adibatic/3dof-manipulator/cad/Ashoulder_joint.SLDASM

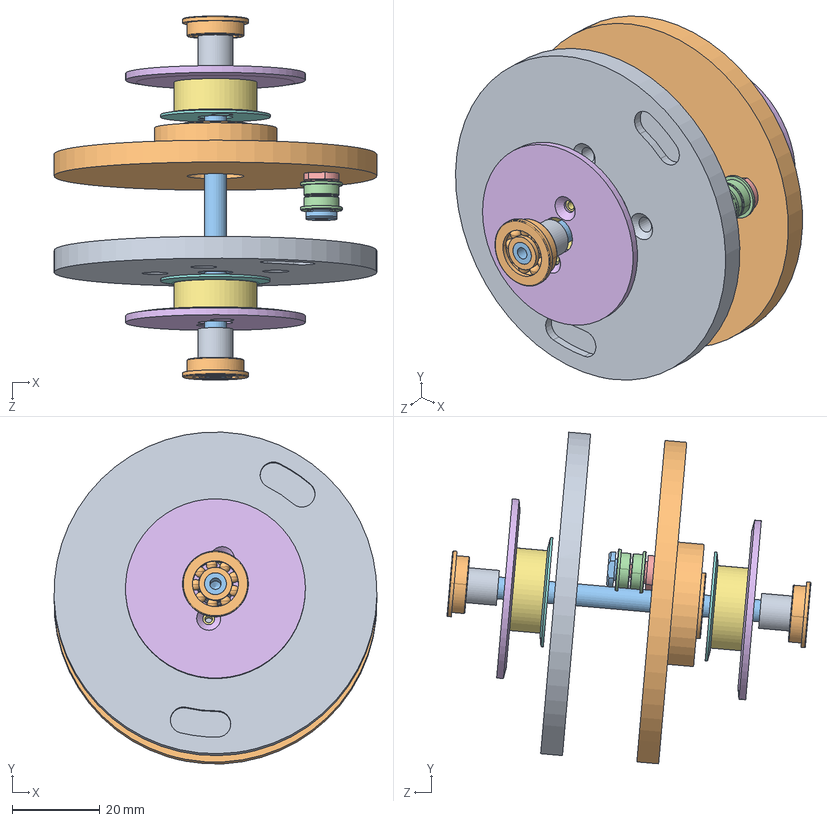
[picture p9: CAD file, 2026-10-08]
cad/Ashoulder_joint.SLDASM
73.6 x 75.6 x 83.0 mm
213shaft
704small_ball_bearings x 3
214sleeve x 2
212flange x 2
211toothed_pulley x 2
210spur_gear x 2
307link_attachment_shaft
705small_ball_bearings x 2
308nut
208spur_gear
207spur_gear
