adibatic/3dof-manipulator/cad/X-X.SLDASM

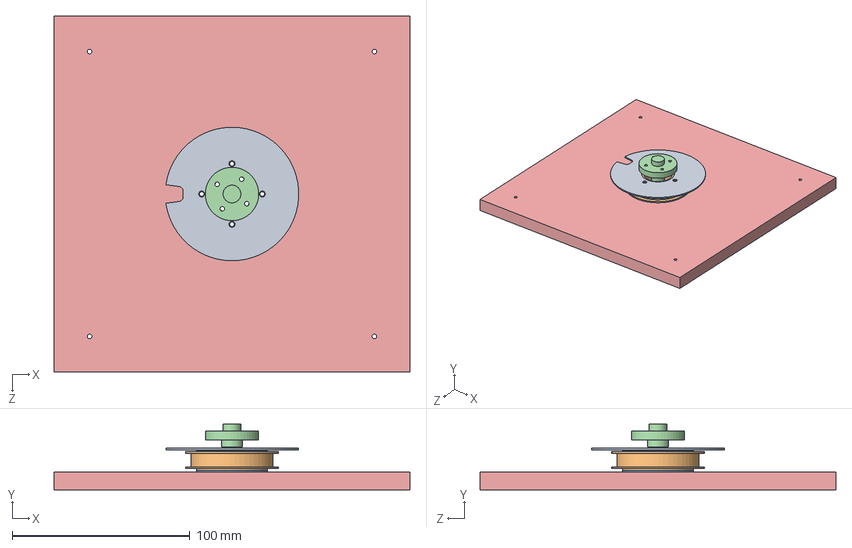
[picture p10: CAD file, 2026-10-08]
cad/X-X.SLDASM
200.0 x 37.0 x 200.0 mm
101base
102shaft
107spacer
103toothed_pulley
106proximity_sensor_target
