adibatic/3dof-manipulator/cad/assembly.SLDASM

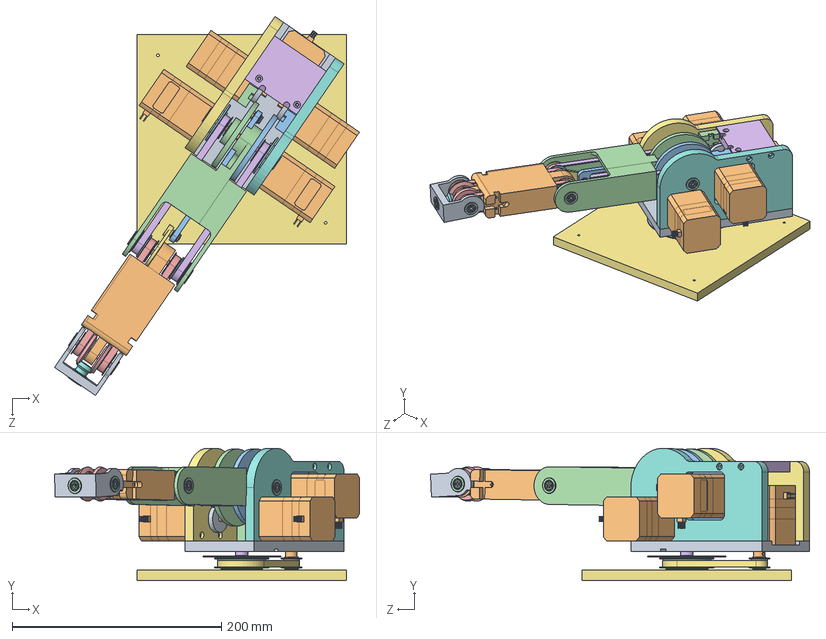
[picture p11: CAD file, 2026-10-08]
cad/assembly.SLDASM
291.2 x 126.5 x 361.9 mm
101base
102shaft
107spacer
103toothed_pulley
106proximity_sensor_target
104toothed_pulley
105waist_rotation_plate
201left_motor_plate
202right_motor_plate
203reinforcement_plate
213shaft
704small_ball_bearings x 9
214sleeve x 2
212flange x 8
211toothed_pulley x 4
210spur_gear x 2
307link_attachment_shaft x 2
705small_ball_bearings x 4
308nut x 2
208spur_gear
207spur_gear
302shaft
303toothed_pulley x 2
304flange x 2
305lever
402shaft
403bevel_gear x 2
301upper_arm
306link_bar
401forearm
501wrist
404bevel_gear
108belt
217belt x 2
309belt x 2
204motor_mounting_plate
205motor_mounting_plate
601pulse_motor x 5
206spur_gear x 4
