adibatic/3dof-manipulator/cad/Belbow_joint.SLDASM

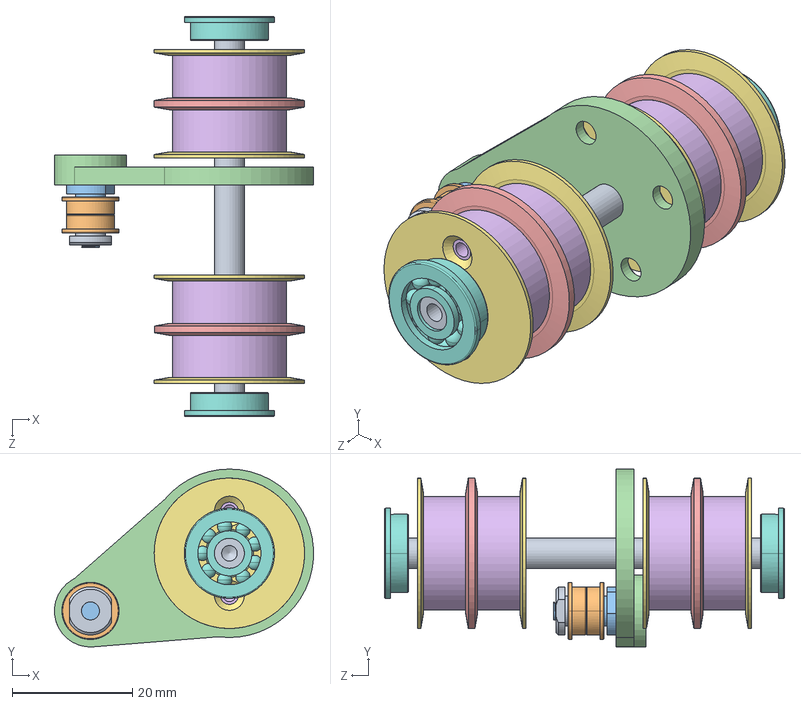
[picture p12: CAD file, 2026-10-08]
cad/Belbow_joint.SLDASM
43.0 x 29.6 x 66.5 mm
302shaft
704small_ball_bearings x 2
212flange x 4
303toothed_pulley x 2
304flange x 2
305lever
307link_attachment_shaft
705small_ball_bearings x 2
308nut
