adibatic/3dof-manipulator/cad/101base.SLDPRT

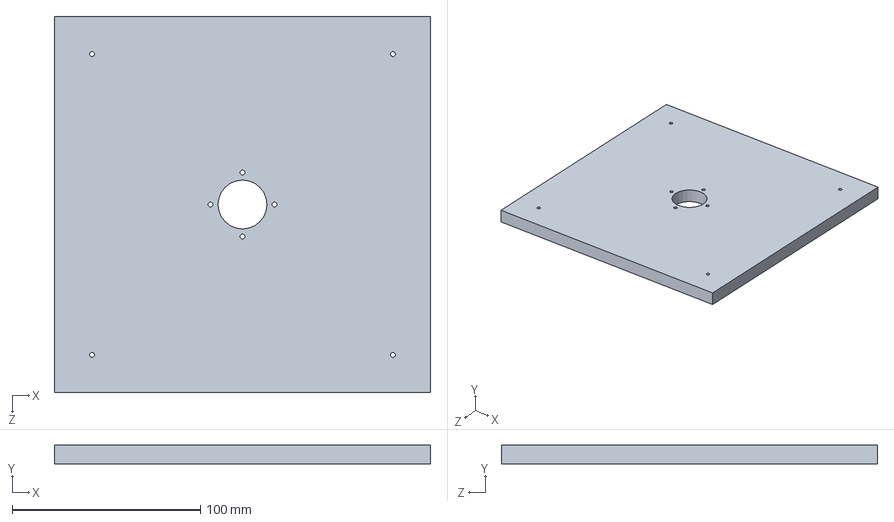
[picture p13: CAD file, 2026-10-08]
cad/101base.SLDPRT
200.0 x 10.0 x 200.0 mm
