adibatic/3dof-manipulator/cad/302shaft.SLDPRT

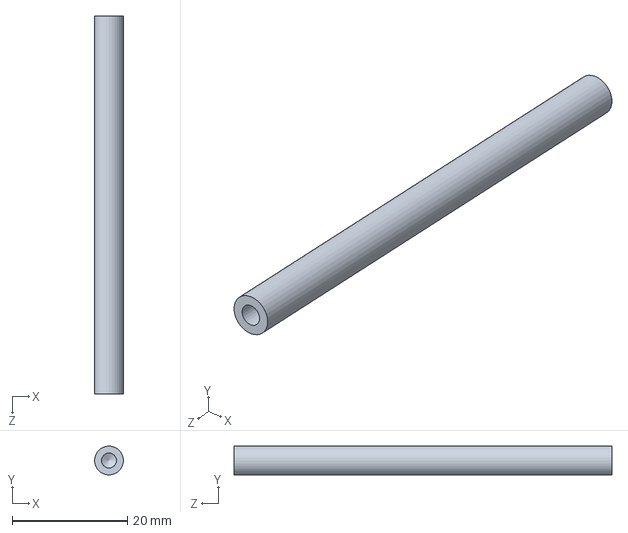
[picture p14: CAD file, 2026-10-08]
cad/302shaft.SLDPRT
5.00 x 5.00 x 65.5 mm
