adibatic/3dof-manipulator/cad/217belt.SLDPRT

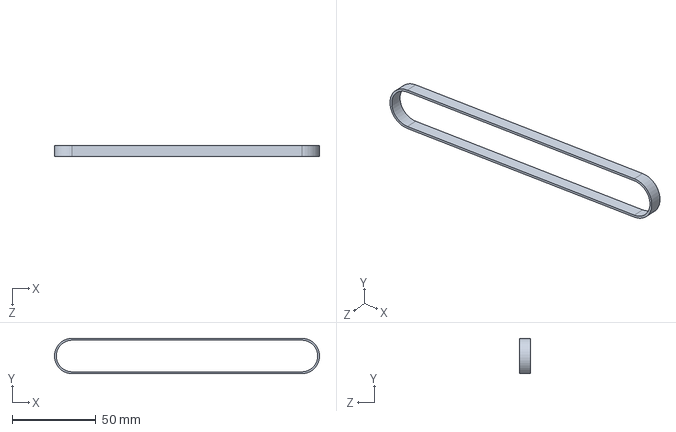
[picture p15: CAD file, 2026-10-08]
cad/217belt.SLDPRT
158.2 x 21.1 x 6.40 mm
