adibatic/3dof-manipulator/cad/208spur_gear.SLDPRT

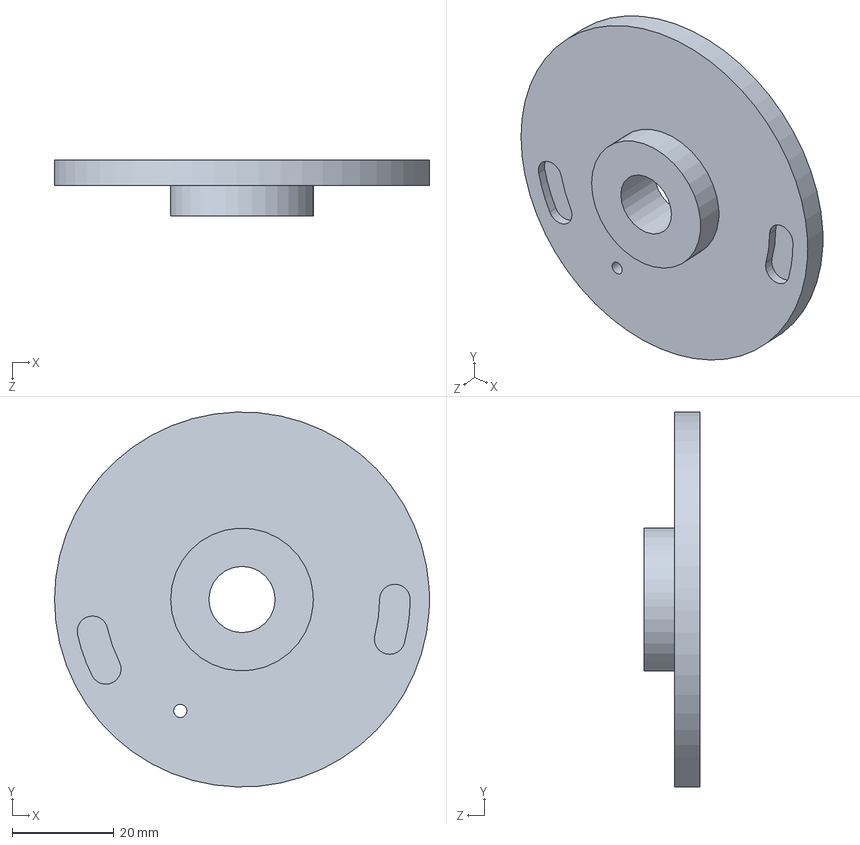
[picture p16: CAD file, 2026-10-08]
cad/208spur_gear.SLDPRT
73.6 x 73.6 x 11.0 mm
