adibatic/3dof-manipulator/cad/207spur_gear.SLDPRT

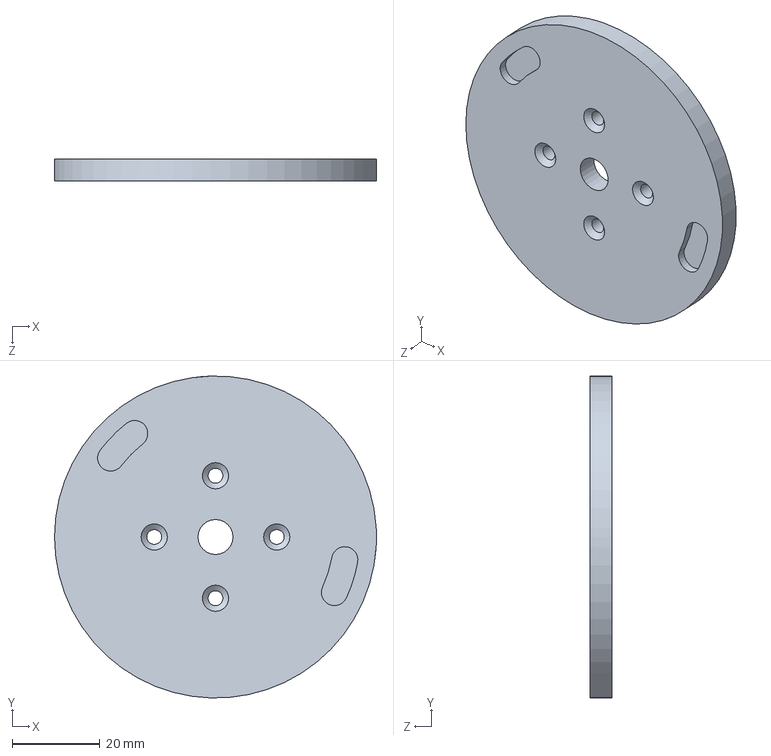
[picture p17: CAD file, 2026-10-08]
cad/207spur_gear.SLDPRT
73.6 x 73.6 x 5.00 mm
