adibatic/3dof-manipulator/cad/704small_ball_bearings.SLDPRT

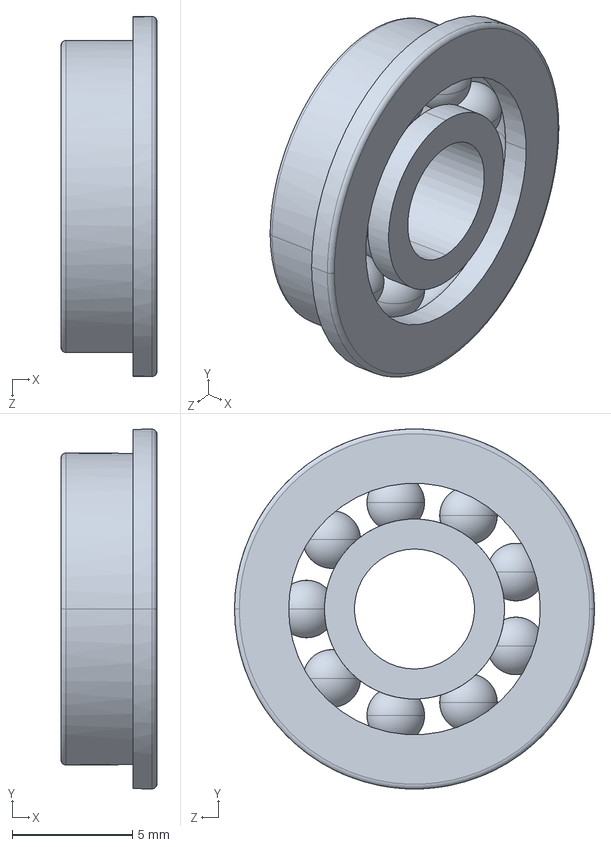
[picture p18: CAD file, 2026-10-08]
cad/704small_ball_bearings.SLDPRT
4.00 x 15.0 x 15.0 mm
