adibatic/3dof-manipulator/cad/308nut.SLDPRT

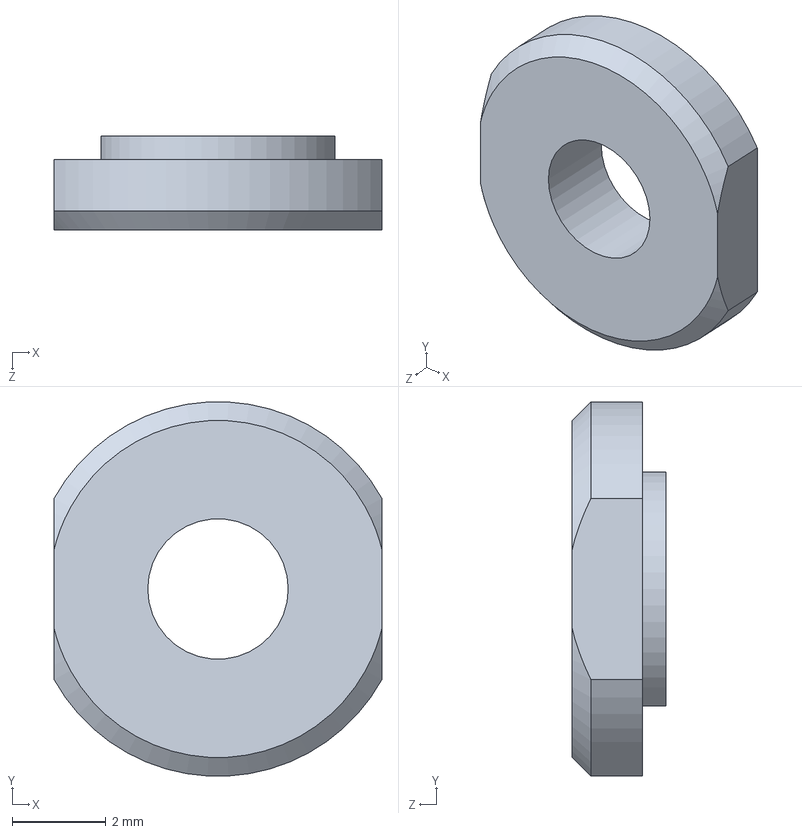
[picture p19: CAD file, 2026-10-08]
cad/308nut.SLDPRT
7.00 x 7.99 x 2.00 mm
