adibatic/3dof-manipulator/cad/303toothed_pulley.SLDPRT

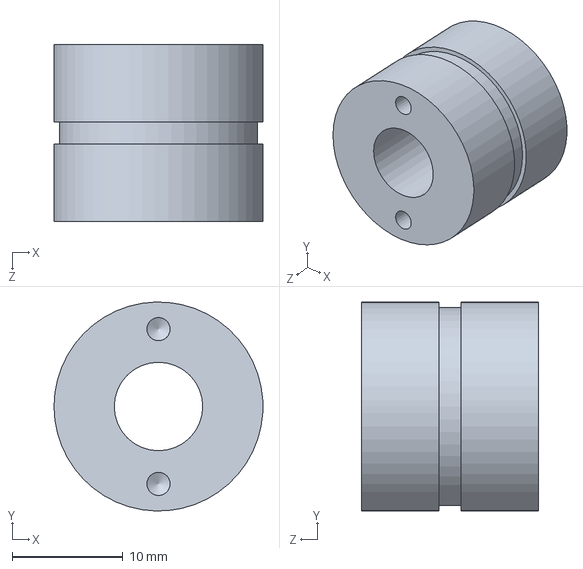
[picture p20: CAD file, 2026-10-08]
cad/303toothed_pulley.SLDPRT
18.9 x 18.9 x 16.0 mm
