adibatic/3dof-manipulator/cad/203reinforcement_plate.SLDPRT

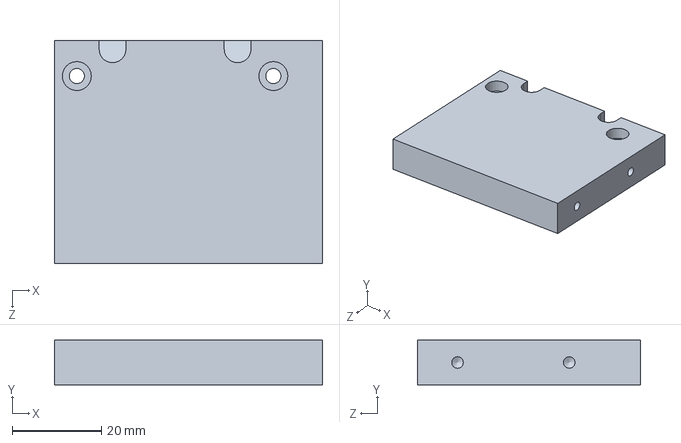
[picture p21: CAD file, 2026-10-08]
cad/203reinforcement_plate.SLDPRT
60.0 x 10.0 x 50.0 mm
