adibatic/3dof-manipulator/cad/201left_motor_plate.SLDPRT

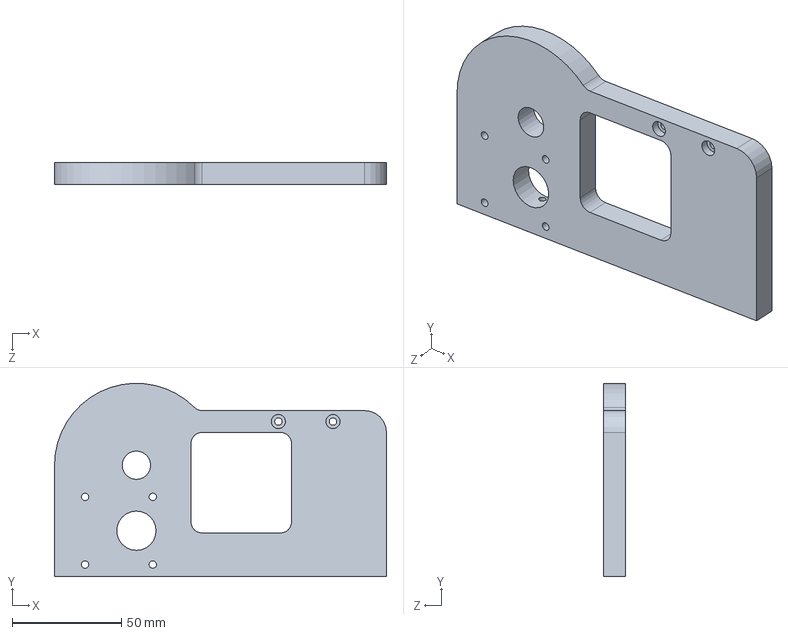
[picture p22: CAD file, 2026-10-08]
cad/201left_motor_plate.SLDPRT
152.0 x 88.5 x 10.0 mm
