adibatic/3dof-manipulator/cad/304flange.SLDPRT

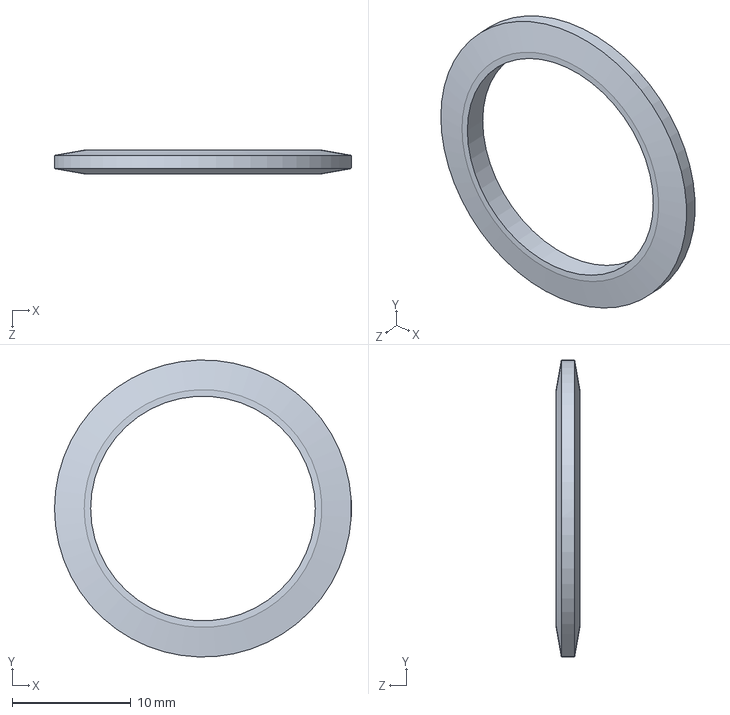
[picture p23: CAD file, 2026-10-08]
cad/304flange.SLDPRT
25.0 x 25.0 x 2.00 mm
