adibatic/3dof-manipulator/cad/214sleeve.SLDPRT

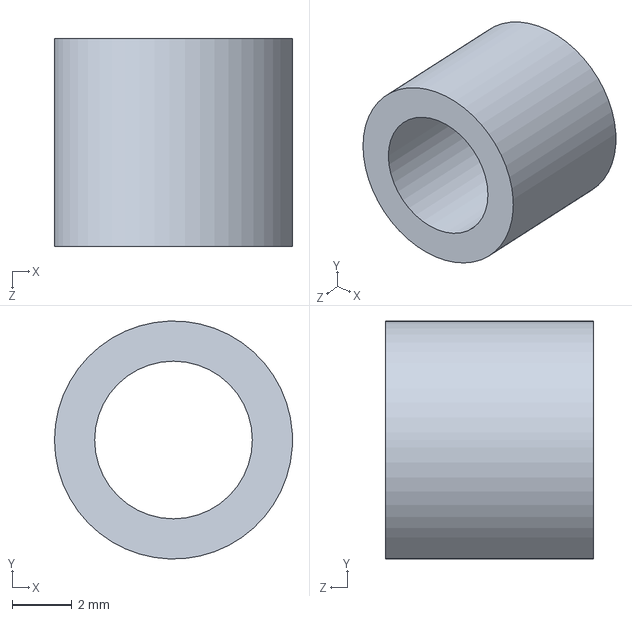
[picture p24: CAD file, 2026-10-08]
cad/214sleeve.SLDPRT
8.00 x 8.00 x 7.00 mm
