adibatic/3dof-manipulator/cad/401forearm.SLDPRT

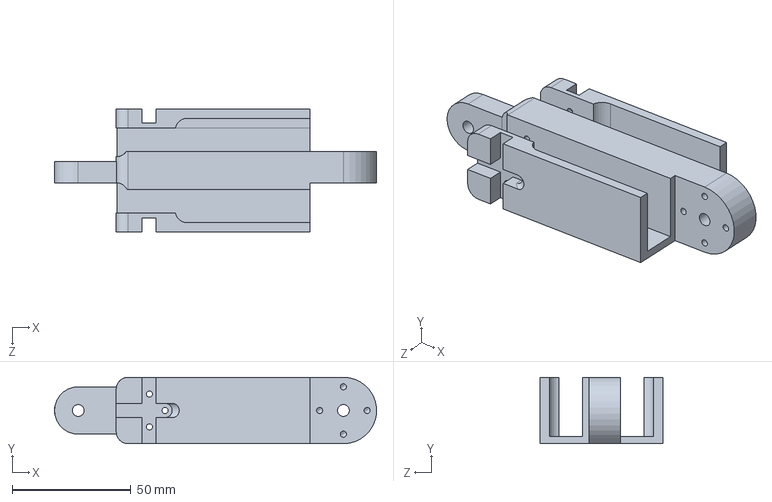
[picture p25: CAD file, 2026-10-08]
cad/401forearm.SLDPRT
135.7 x 28.0 x 52.0 mm
