adibatic/3dof-manipulator/cad/102shaft.SLDPRT

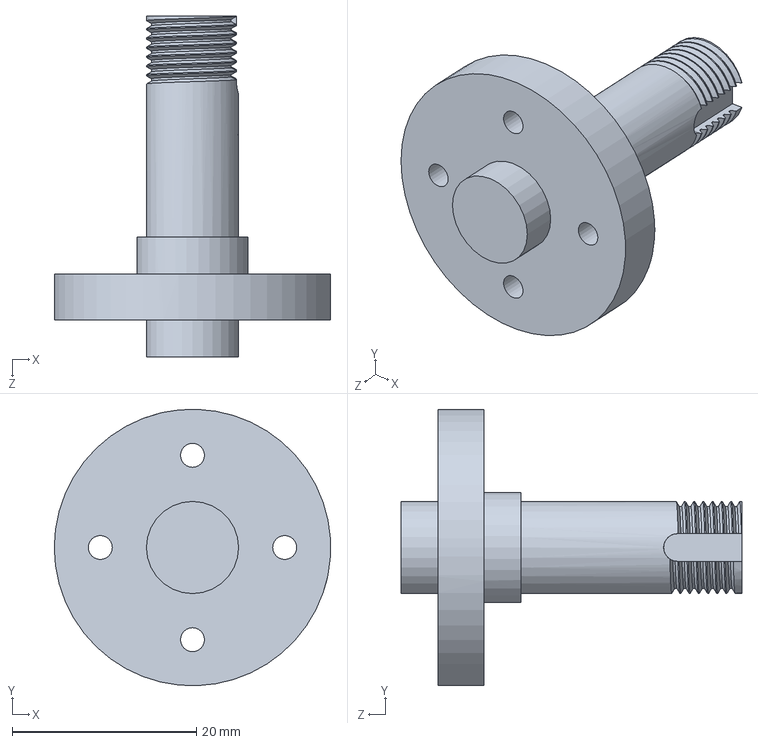
[picture p26: CAD file, 2026-10-08]
cad/102shaft.SLDPRT
30.0 x 30.0 x 37.0 mm
