adibatic/3dof-manipulator/cad/309belt.SLDPRT

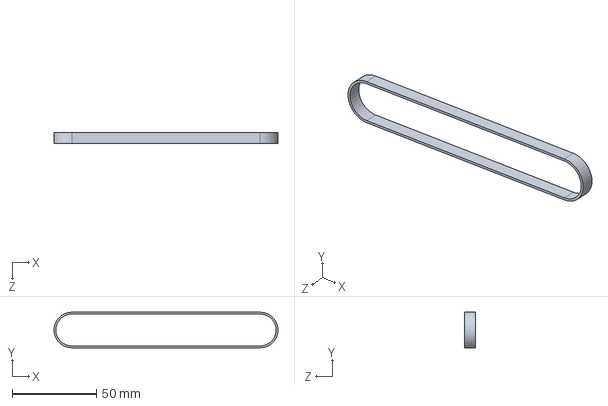
[picture p27: CAD file, 2026-10-08]
cad/309belt.SLDPRT
132.9 x 21.1 x 6.40 mm
