adibatic/3dof-manipulator/cad/103toothed_pulley.SLDPRT

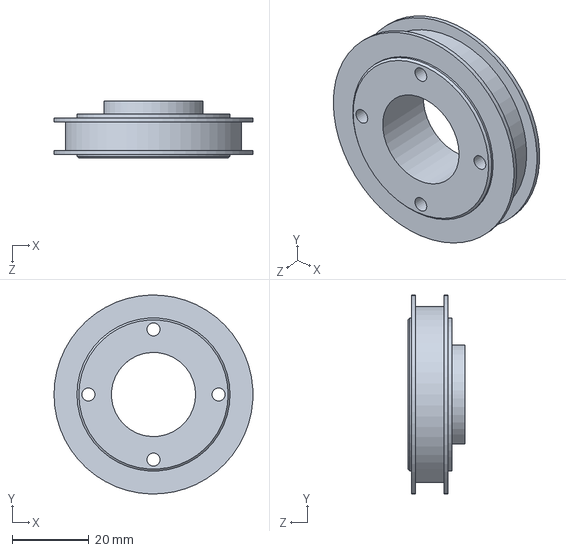
[picture p28: CAD file, 2026-10-08]
cad/103toothed_pulley.SLDPRT
52.0 x 52.0 x 15.0 mm
