adibatic/3dof-manipulator/cad/306link_bar.SLDPRT

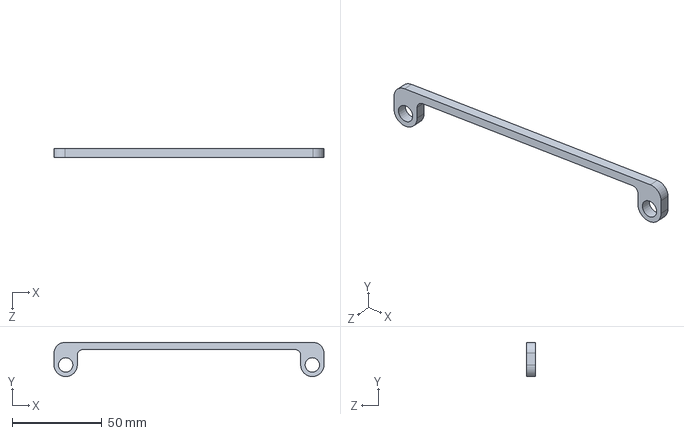
[picture p29: CAD file, 2026-10-08]
cad/306link_bar.SLDPRT
150.2 x 19.0 x 5.00 mm
