adibatic/3dof-manipulator/cad/404bevel_gear.sldprt

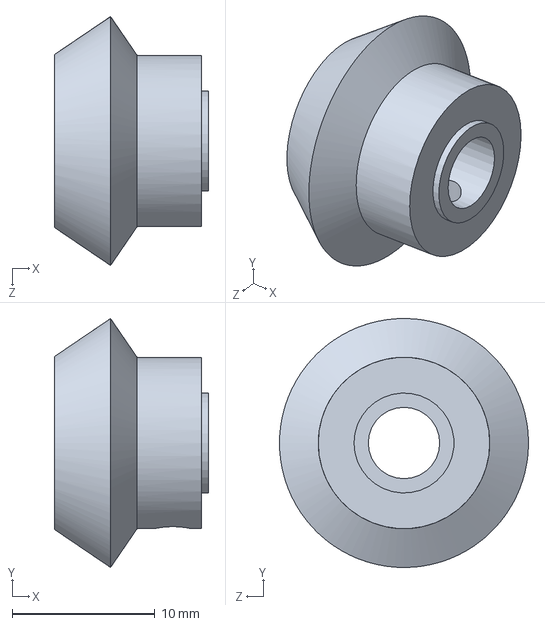
[picture p30: CAD file, 2026-10-08]
cad/404bevel_gear.sldprt
10.8 x 17.4 x 17.4 mm
