adibatic/3dof-manipulator/cad/301upper_arm.SLDPRT

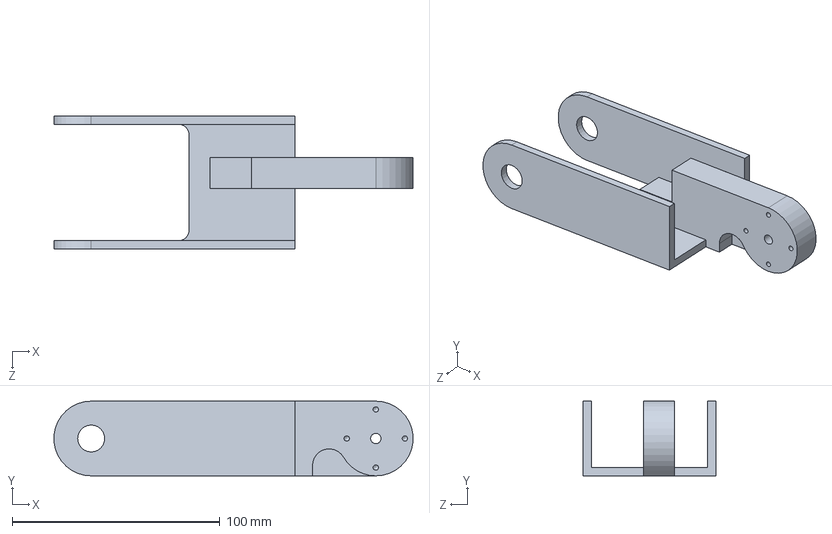
[picture p31: CAD file, 2026-10-08]
cad/301upper_arm.SLDPRT
173.0 x 36.0 x 64.0 mm
