adibatic/3dof-manipulator/cad/402shaft.SLDPRT

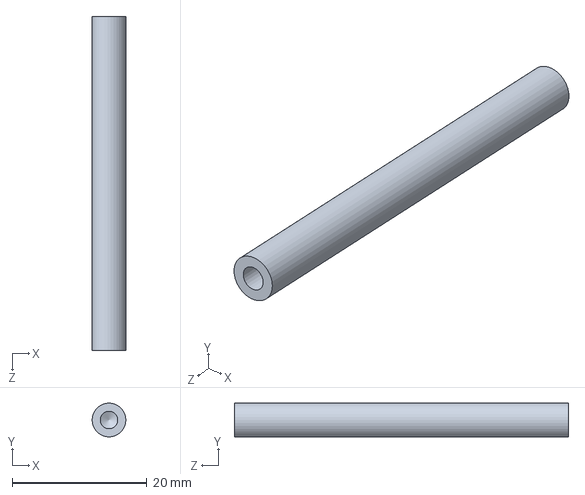
[picture p32: CAD file, 2026-10-08]
cad/402shaft.SLDPRT
5.00 x 4.98 x 49.5 mm
