adibatic/3dof-manipulator/cad/210spur_gear.SLDPRT

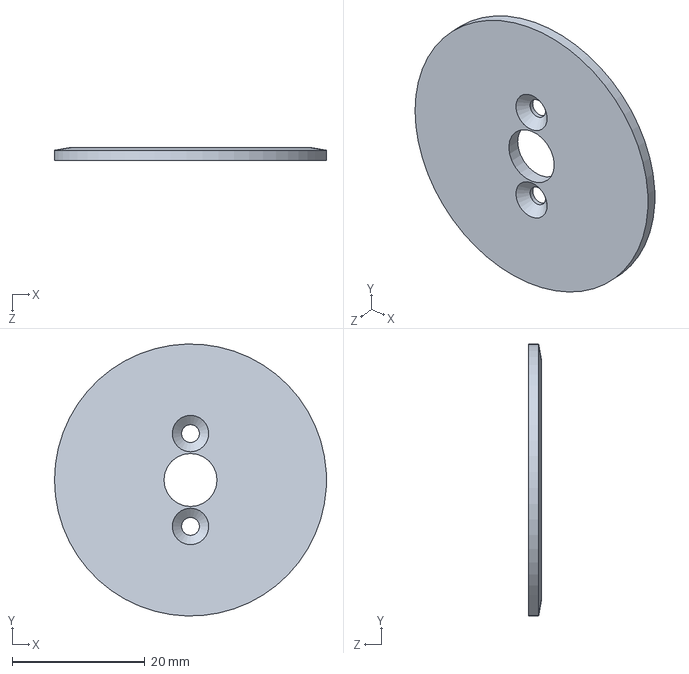
[picture p33: CAD file, 2026-10-08]
cad/210spur_gear.SLDPRT
41.0 x 41.0 x 2.00 mm
