adibatic/3dof-manipulator/cad/307link_attachment_shaft.SLDPRT

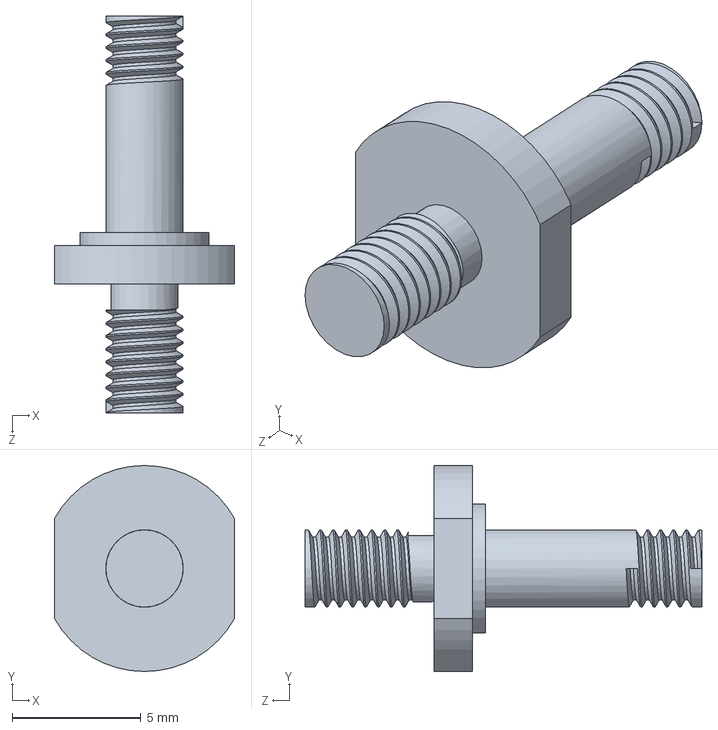
[picture p34: CAD file, 2026-10-08]
cad/307link_attachment_shaft.SLDPRT
7.00 x 8.00 x 15.4 mm
