adibatic/3dof-manipulator/cad/206spur_gear.SLDPRT

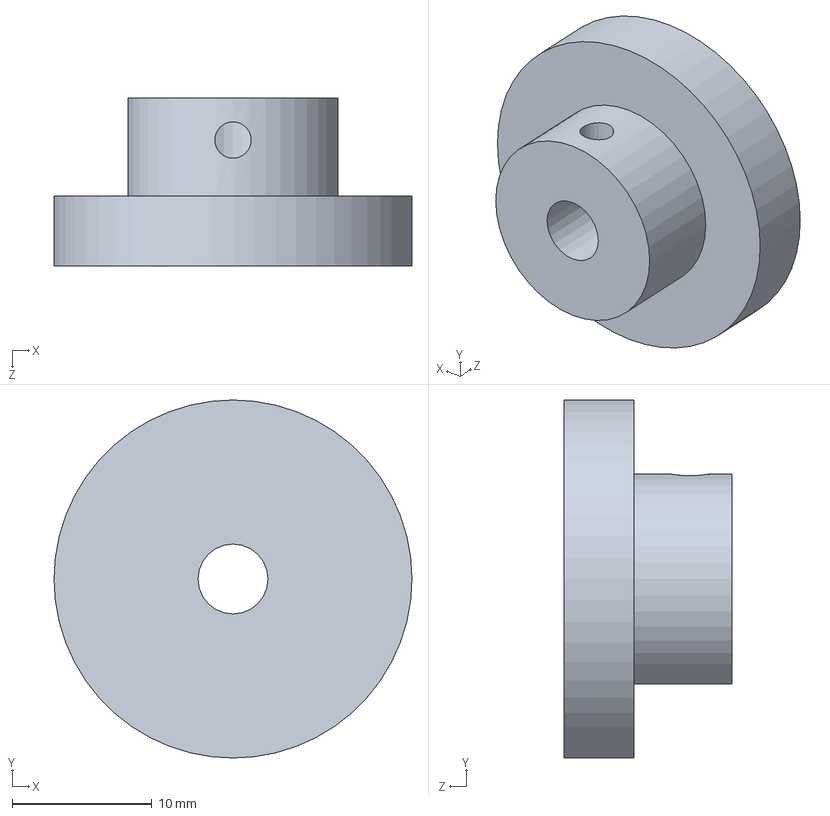
[picture p36: CAD file, 2026-10-08]
cad/206spur_gear.SLDPRT
25.6 x 25.6 x 12.0 mm
