adibatic/3dof-manipulator/cad/305lever.SLDPRT

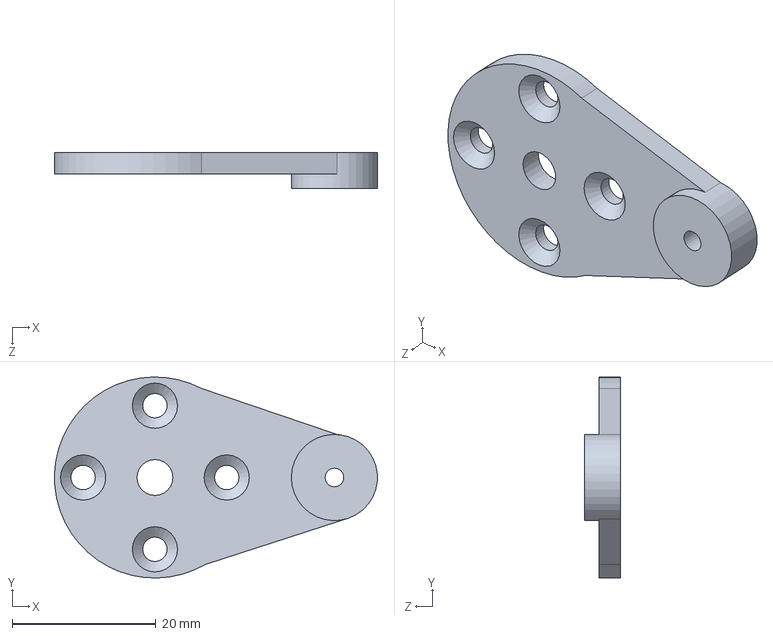
[picture p37: CAD file, 2026-10-08]
cad/305lever.SLDPRT
45.0 x 28.0 x 5.00 mm
