adibatic/3dof-manipulator/cad/104toothed_pulley.SLDPRT

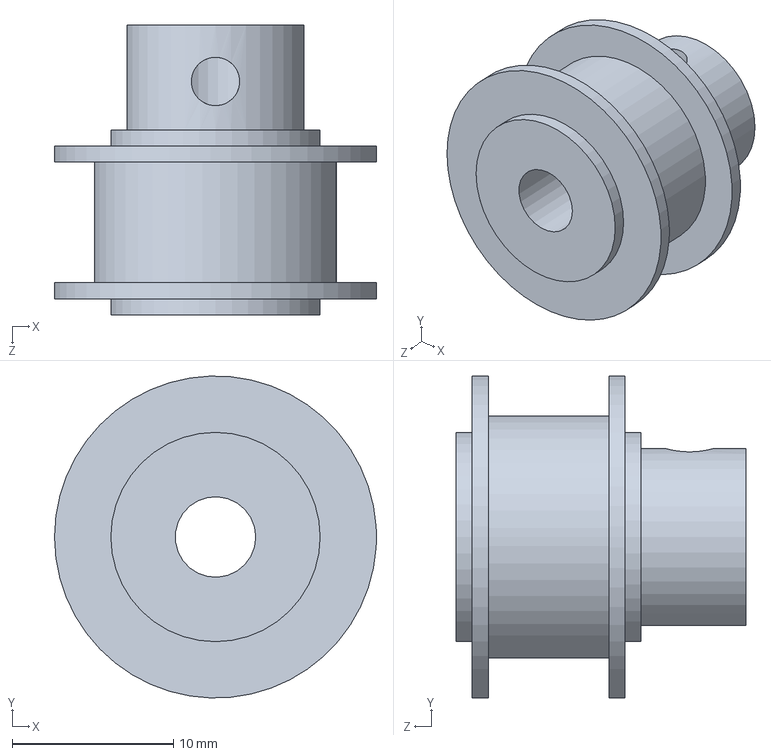
[picture p38: CAD file, 2026-10-08]
cad/104toothed_pulley.SLDPRT
20.0 x 20.0 x 18.0 mm
