adibatic/3dof-manipulator/cad/209spur_gear.SLDPRT

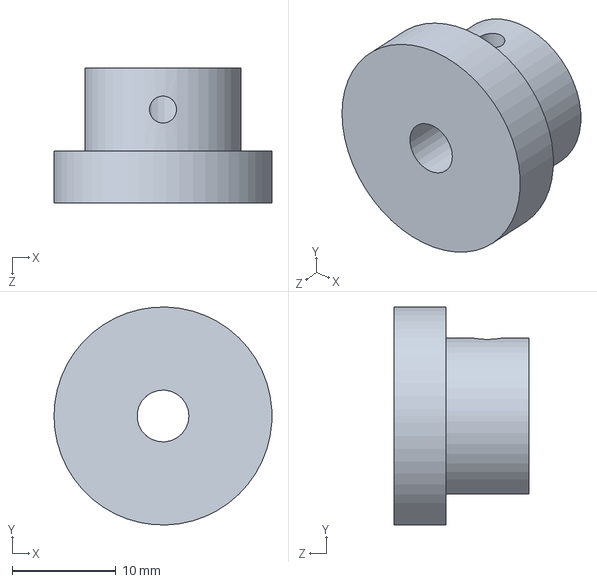
[picture p39: CAD file, 2026-10-08]
cad/209spur_gear.SLDPRT
21.0 x 21.0 x 13.0 mm
