adibatic/3dof-manipulator/cad/205motor_mounting_plate.SLDPRT

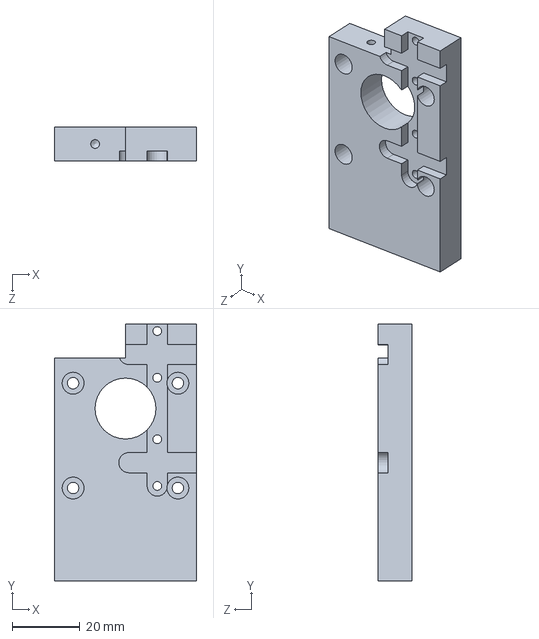
[picture p40: CAD file, 2026-10-08]
cad/205motor_mounting_plate.SLDPRT
42.0 x 76.0 x 10.0 mm
