adibatic/3dof-manipulator/cad/501wrist.SLDPRT

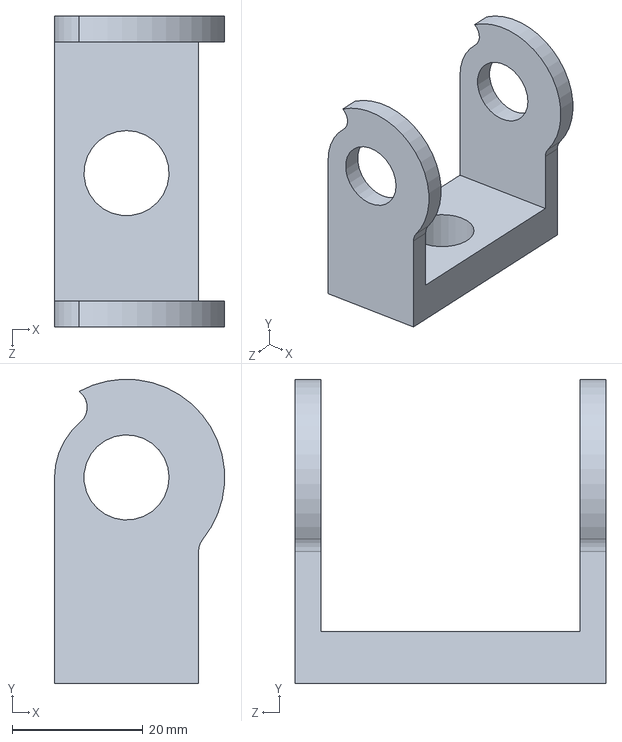
[picture p41: CAD file, 2026-10-08]
cad/501wrist.SLDPRT
26.0 x 46.5 x 47.5 mm
