adibatic/3dof-manipulator/cad/213shaft.SLDPRT

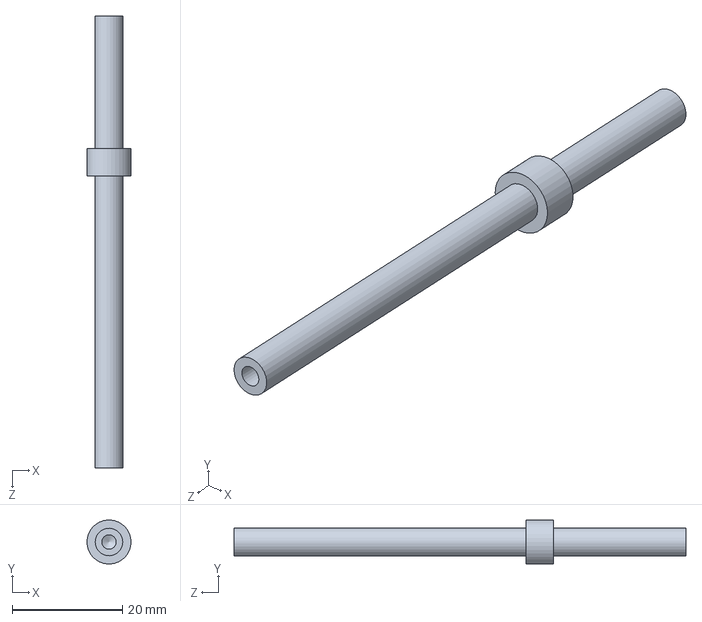
[picture p42: CAD file, 2026-10-08]
cad/213shaft.SLDPRT
8.00 x 7.97 x 82.0 mm
