adibatic/3dof-manipulator/cad/705small_ball_bearings.SLDPRT

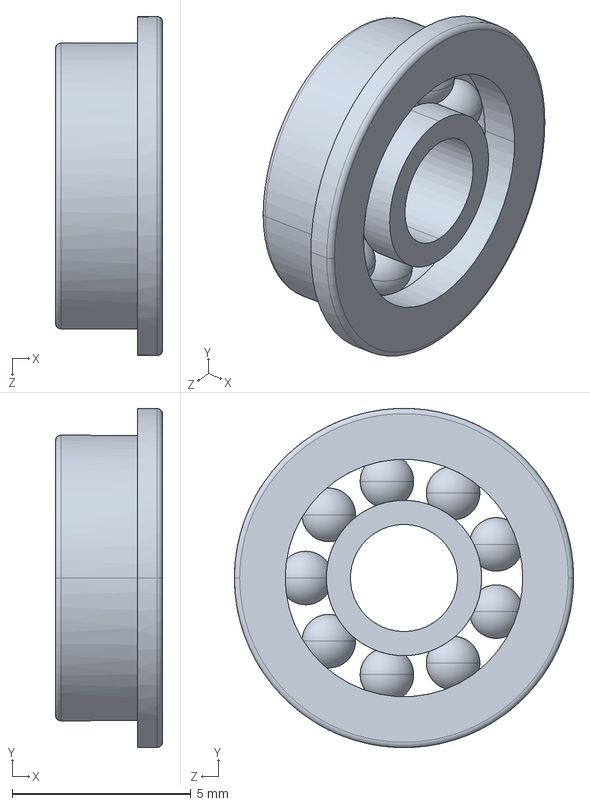
[picture p43: CAD file, 2026-10-08]
cad/705small_ball_bearings.SLDPRT
3.00 x 9.49 x 9.50 mm
