adibatic/3dof-manipulator/cad/108belt.SLDPRT

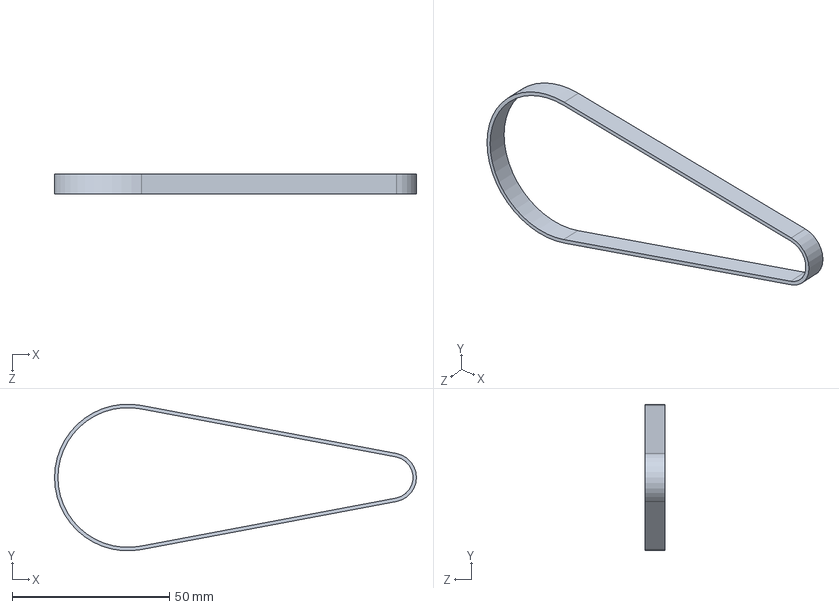
[picture p44: CAD file, 2026-10-08]
cad/108belt.SLDPRT
115.0 x 46.5 x 6.40 mm
