adibatic/3dof-manipulator/cad/106proximity_sensor_target.SLDPRT

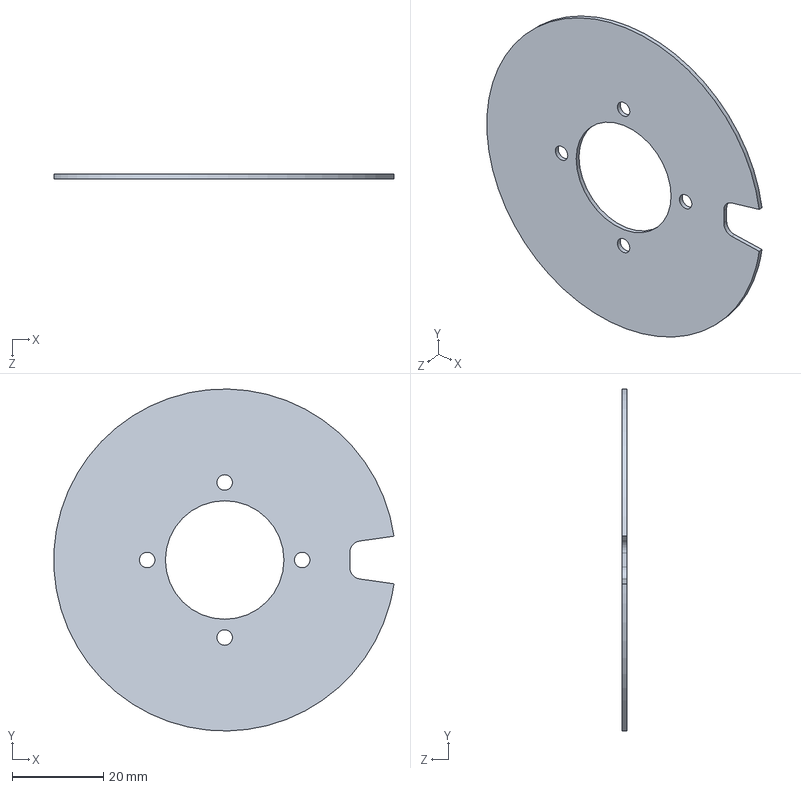
[picture p45: CAD file, 2026-10-08]
cad/106proximity_sensor_target.SLDPRT
74.6 x 75.0 x 1.00 mm
