adibatic/3dof-manipulator/cad/601pulse_motor.SLDPRT

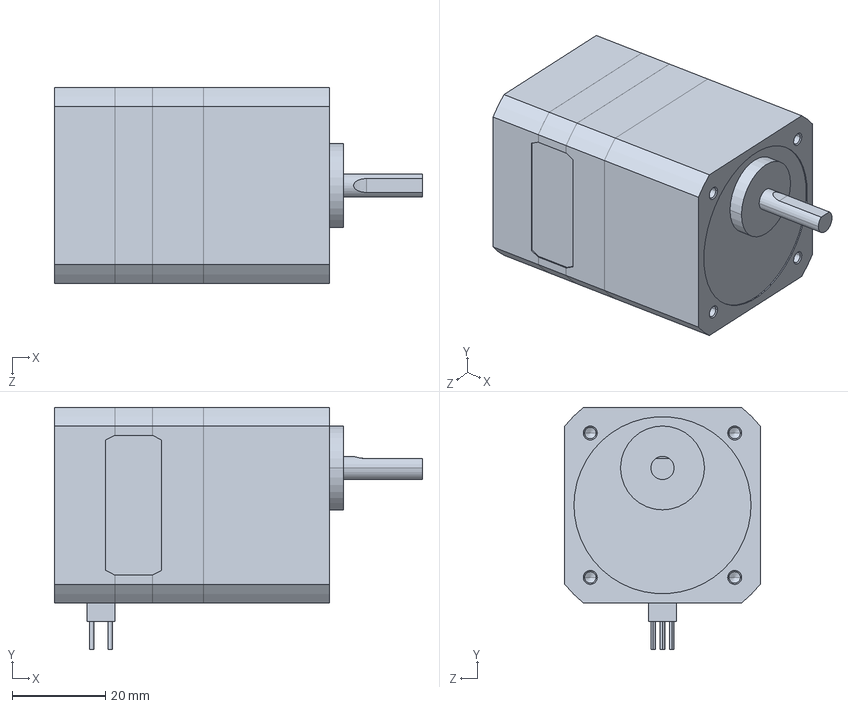
[picture p46: CAD file, 2026-10-08]
cad/601pulse_motor.SLDPRT
79.0 x 52.0 x 42.0 mm
