adibatic/3dof-manipulator/cad/107spacer.SLDPRT

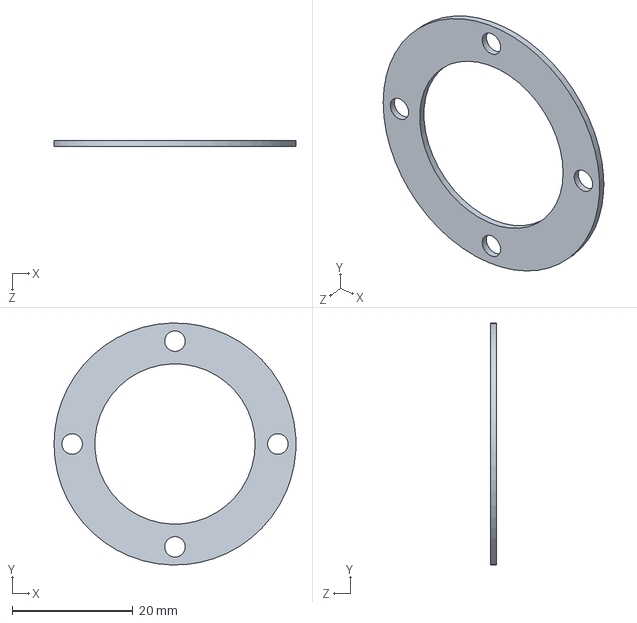
[picture p47: CAD file, 2026-10-08]
cad/107spacer.SLDPRT
40.0 x 40.0 x 1.00 mm
