adibatic/3dof-manipulator/cad/202right_motor_plate.SLDPRT

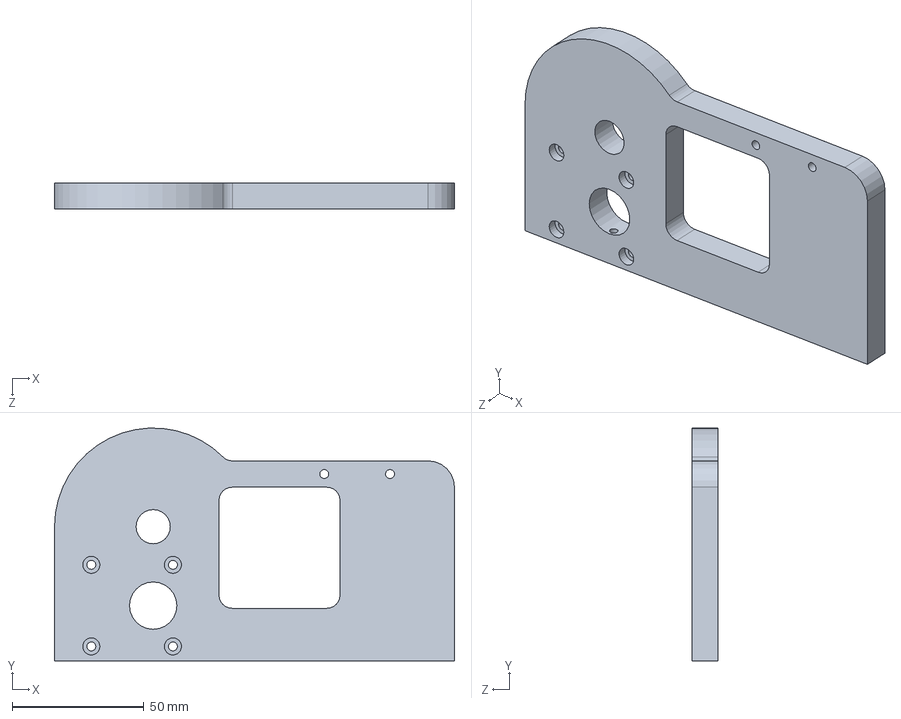
[picture p48: CAD file, 2026-10-08]
cad/202right_motor_plate.SLDPRT
152.0 x 88.5 x 10.0 mm
