adibatic/3dof-manipulator/cad/211toothed_pulley.SLDPRT

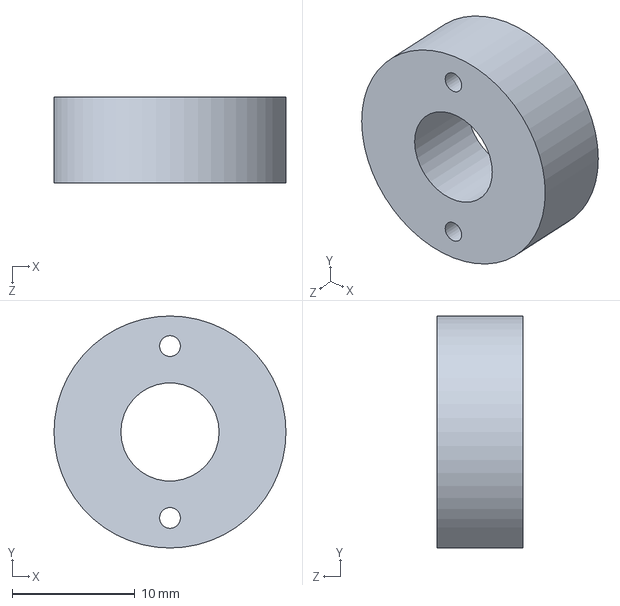
[picture p49: CAD file, 2026-10-08]
cad/211toothed_pulley.SLDPRT
18.9 x 18.9 x 7.00 mm
