adibatic/3dof-manipulator/cad/403bevel_gear.sldprt

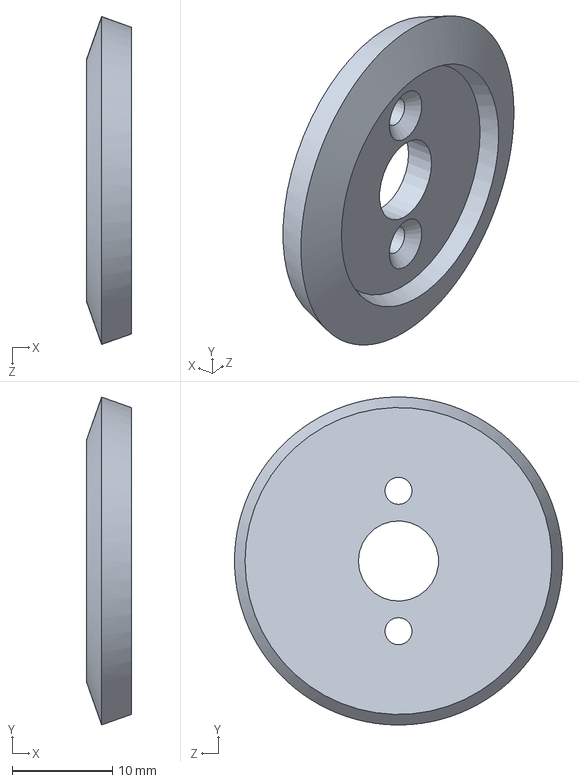
[picture p50: CAD file, 2026-10-08]
cad/403bevel_gear.sldprt
4.50 x 32.7 x 32.7 mm
