adibatic/3dof-manipulator/cad/212flange.SLDPRT

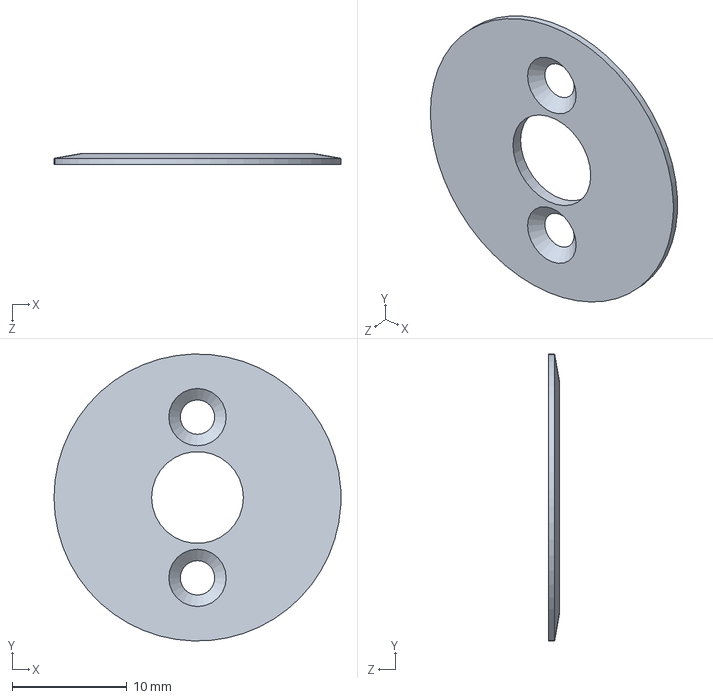
[picture p51: CAD file, 2026-10-08]
cad/212flange.SLDPRT
25.0 x 25.0 x 1.00 mm
