adibatic/3dof-manipulator/cad/105waist_rotation_plate.SLDPRT

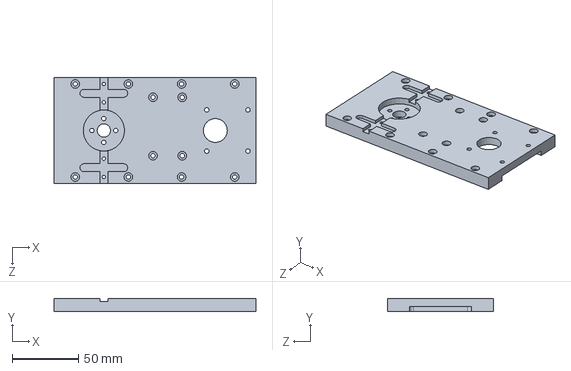
[picture p52: CAD file, 2026-10-08]
cad/105waist_rotation_plate.SLDPRT
152.0 x 10.0 x 80.0 mm
