adibatic/3dof-manipulator/cad/701ball_bearings.SLDPRT

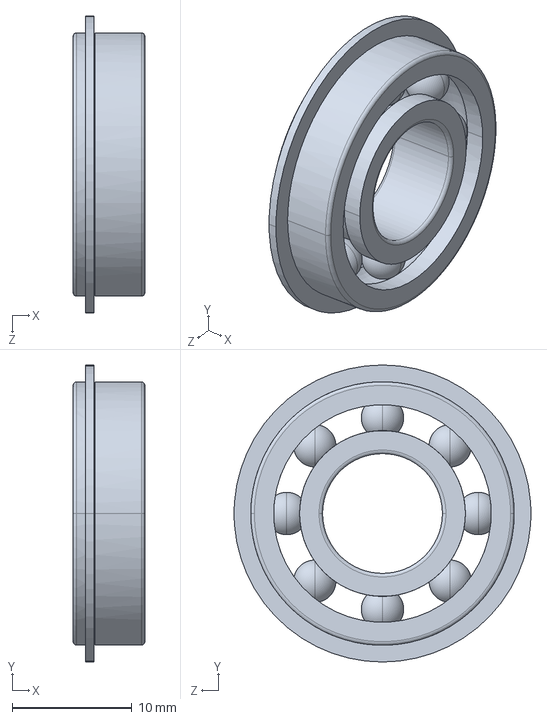
[picture p53: CAD file, 2026-10-08]
cad/701ball_bearings.SLDPRT
6.00 x 24.8 x 24.8 mm
