adibatic/3dof-manipulator/cad/502shaft.SLDPRT

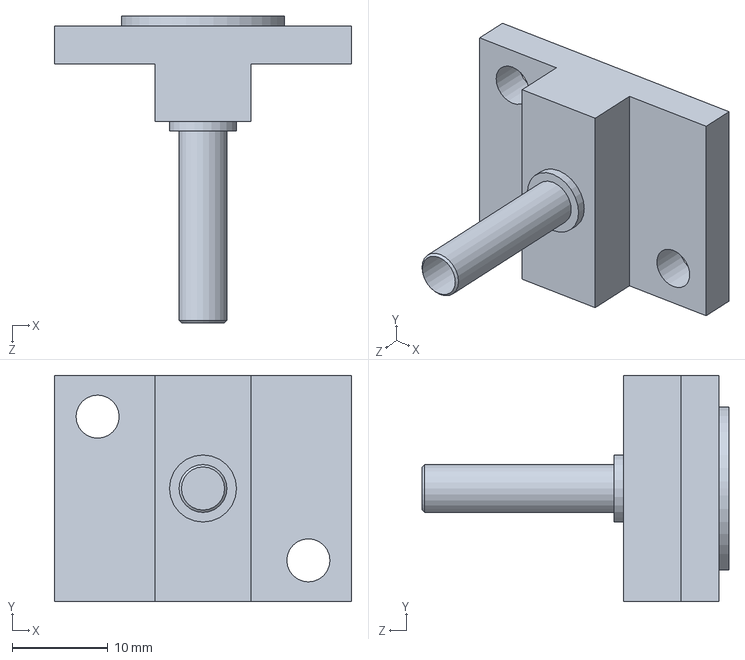
[picture p54: CAD file, 2026-10-08]
cad/502shaft.SLDPRT
31.0 x 23.6 x 32.0 mm
