adibatic/3dof-manipulator/cad/215sleeve.SLDPRT

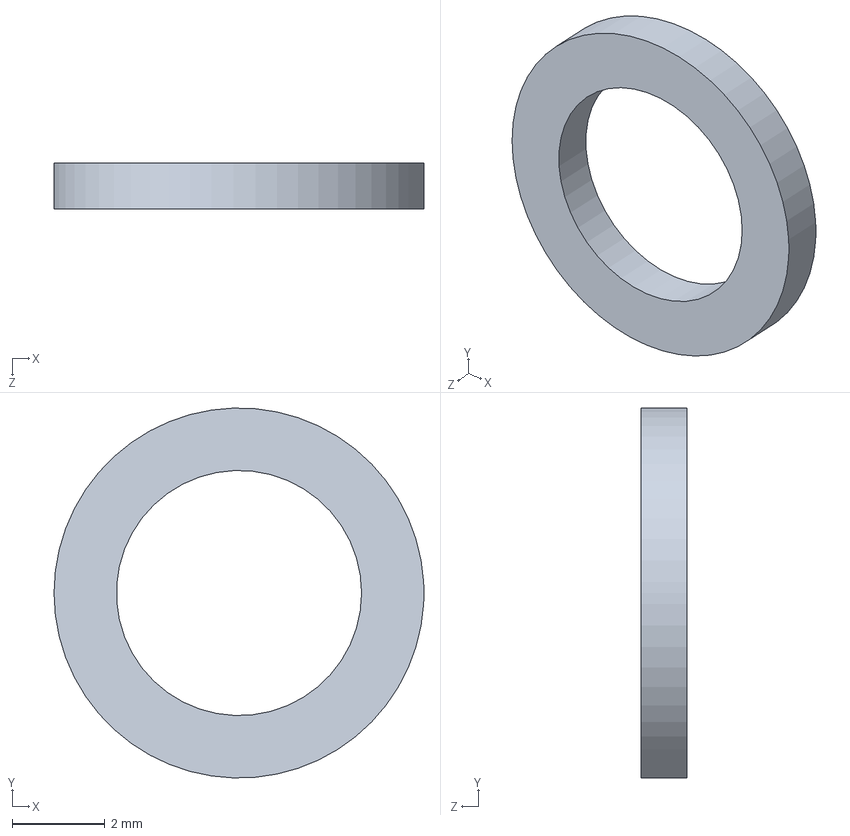
[picture p55: CAD file, 2026-10-08]
cad/215sleeve.SLDPRT
8.00 x 8.00 x 1.00 mm
