adibatic/3dof-manipulator/cad/Cwrist_joint.SLDASM

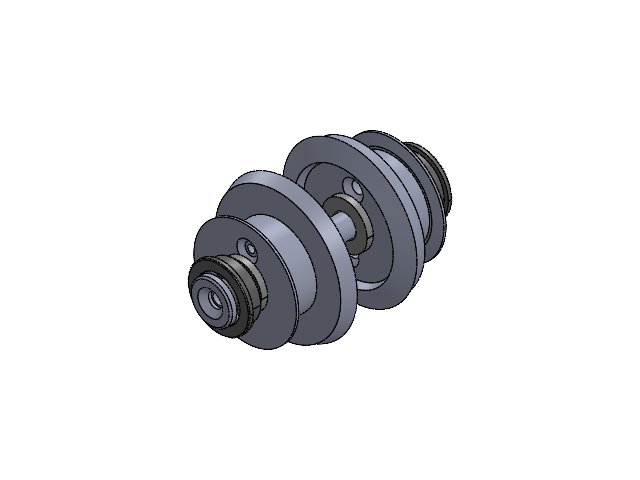
[picture p56: CAD file, 2026-10-08]
cad/Cwrist_joint.SLDASM
402shaft
216washer x 2
704small_ball_bearings x 2
215sleeve x 2
706plain_bearings x 5
212flange x 2
211toothed_pulley x 2
403bevel_gear x 2
