adibatic/3dof-manipulator/(list of files, cad)

Other CAD files:
cad/216washer.SLDPRT
cad/702bearing_nut.SLDPRT
cad/703bearing_washer.SLDPRT
