adibatic/3dof-manipulator/drawings/drawings.pdf

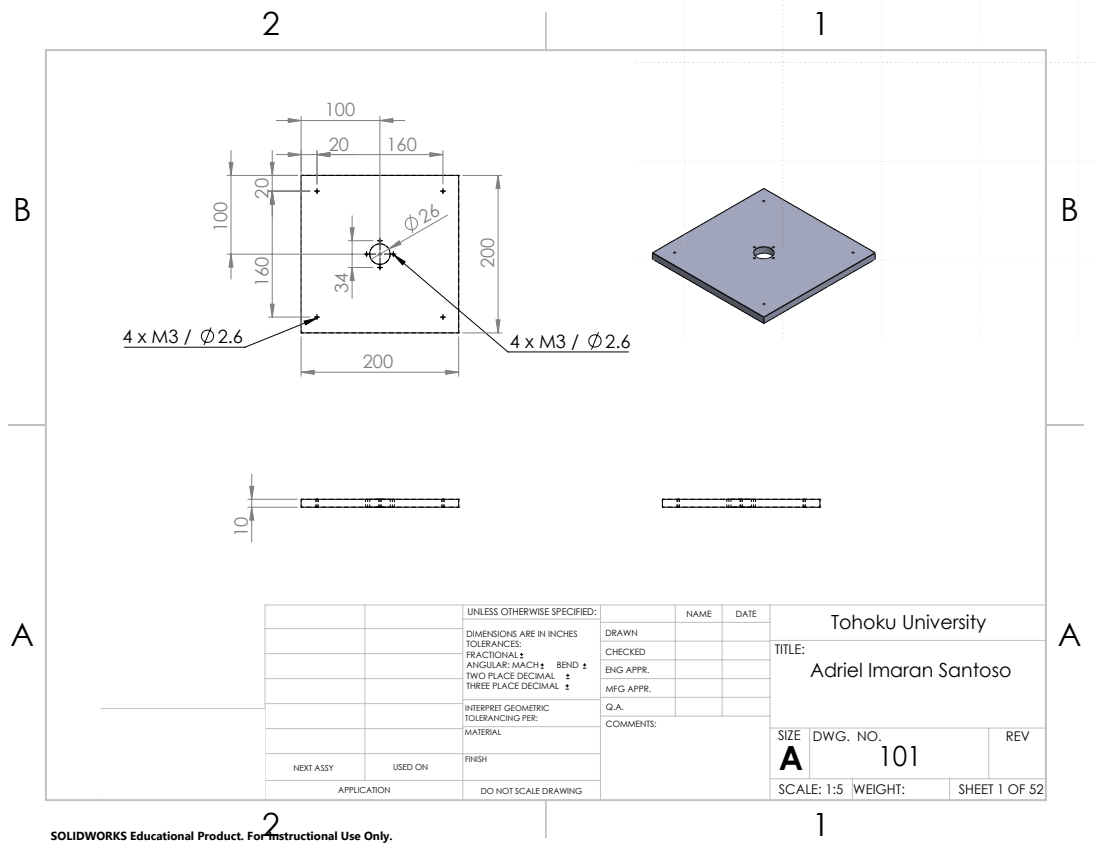
[picture p57: page 1]

UNLESS OTHERWISE SPECIFIED: | | NAME | DATE | Tohoku University
DIMENSIONS ARE IN INCHES TOLERANCES: FRACTIONAL ANGULAR: MACH BEND TWO PLACE DECIMAL THREE PLACE DECIMAL | DRAWN

CHECKED | | | TITLE: Adriel Imaran Santoso

ENG APPR.
MFG APPR.

INTERPRET GEOMETRIC TOLERANCING PER: | Q.A.
MATERIAL | | SIZE A | DWG. NO. 101 | REV

NEXT ASSY | USED ON | FINISH

APPLICATION | DO NOT SCALE DRAWING | | SCALE: 1:5 | WEIGHT: | SHEET 1 OF 52

SOLIDWORKS Educational Product. For Instructional Use Only.

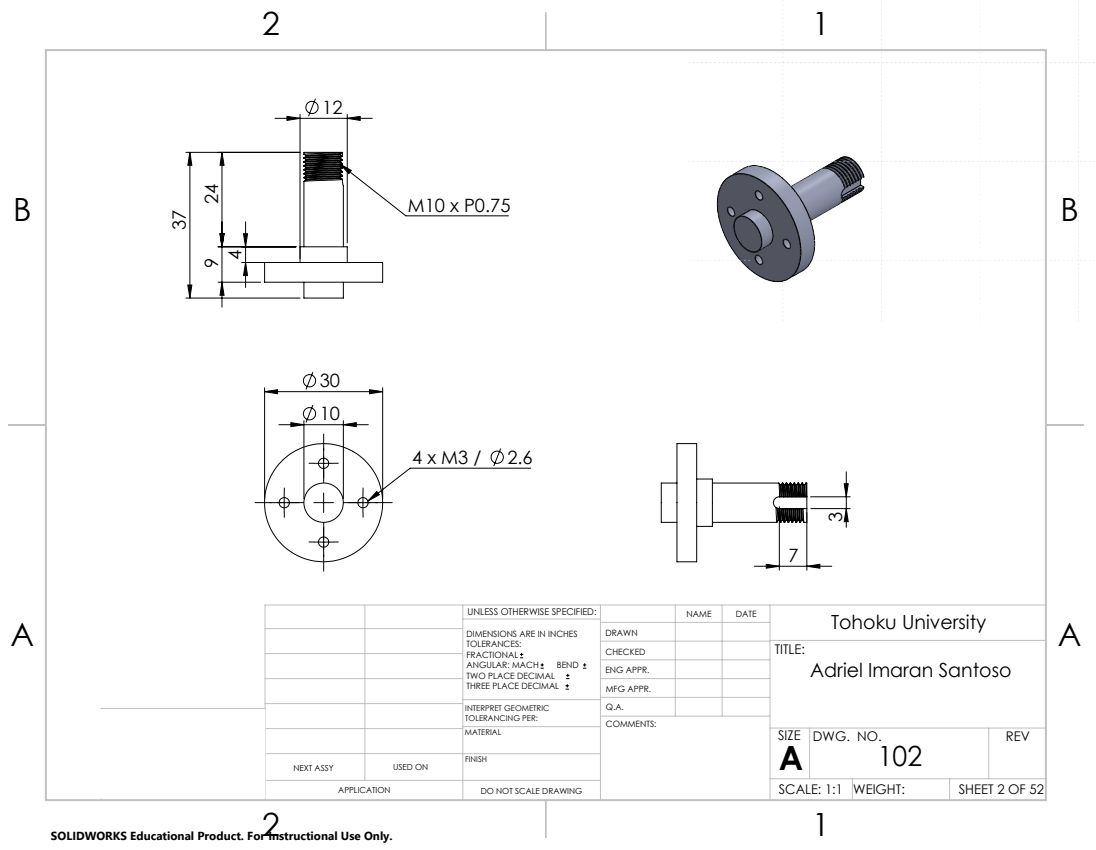
[picture p58: page 2]
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

CHECKED | | | TITLE: Adriel Imaran Santoso

ENG APPR.
MFG APPR.

INTERPRET GEOMETRIC TOLERANCING PER: | Q.A.
MATERIAL | | SIZE A | DWG. NO. 102 | REV

NEXT ASSY | USED ON | FINISH

SCALE: 1:1 | WEIGHT:

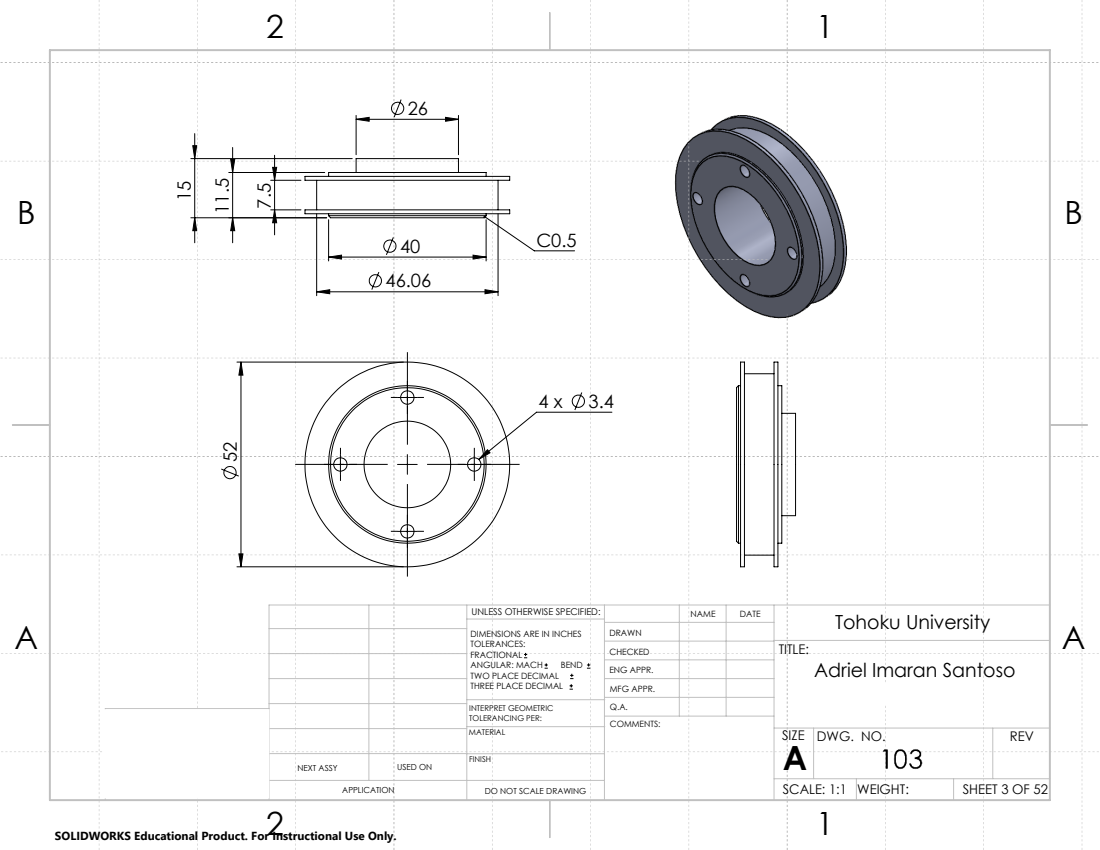
[picture p59: page 3]
Tohoku University A

UNLESS OTHERWISE SPECIFIED: | | NAME | DATE
DIMENSIONS ARE IN INCHES TOLERANCES: FRACTIONAL ANGULAR: MACH BEND TWO PLACE DECIMAL THREE PLACE DECIMAL | DRAWN

CHECKED | | | TITLE: Adriel Imaran Santoso

ENG APPR.
MFG APPR.

INTERPRET GEOMETRIC TOLERANCING PER: | Q.A.
MATERIAL | | SIZE A | DWG. NO. | REV

NEXT ASSY | USED ON | FINISH

DO NOT SCALE DRAWING | | SCALE: 1:1 | WEIGHT: | SHEET 3 OF 52

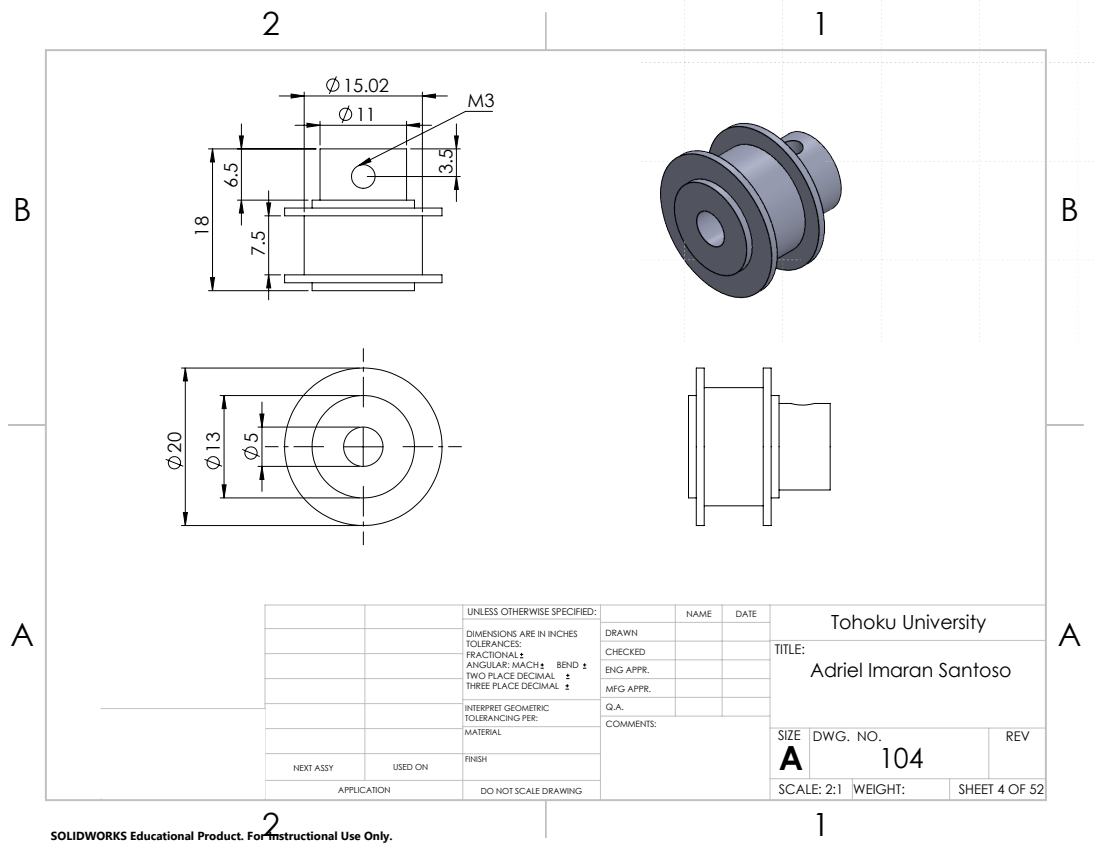
[picture p60: page 4]
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

CHECKED | | | TITLE: Adriel Imaran Santoso

ENG APPR.
MFG APPR.

INTERPRET GEOMETRIC TOLERANCING PER: | Q.A.
MATERIAL | | SIZE A | DWG. NO. 104 | REV

NEXT ASSY | USED ON | FINISH

SCALE: 2:1 | WEIGHT:

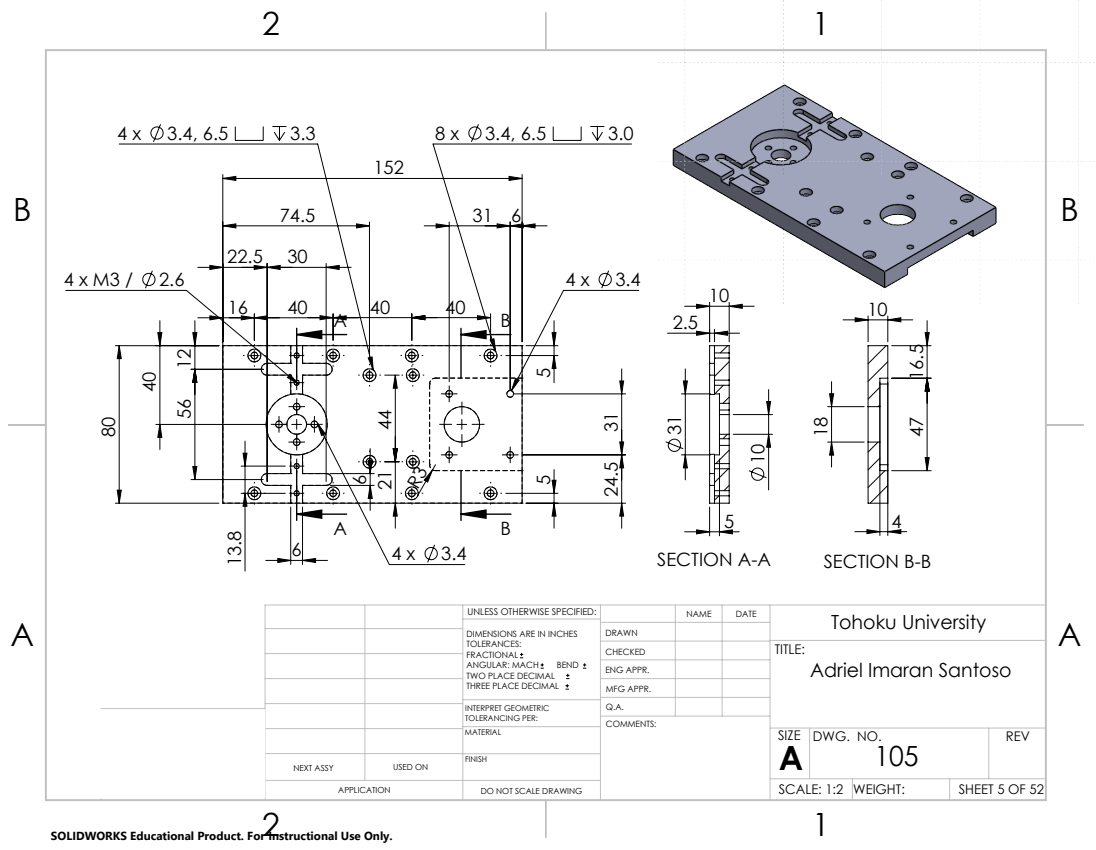
[picture p61: page 5]
SECTION A-A; SECTION B-B

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

CHECKED | | | TITLE: Adriel Imaran Santoso

ENG APPR.
MFG APPR.

INTERPRET GEOMETRIC TOLERANCING PER: | Q.A.
MATERIAL | | SIZE A | DWG. NO. 105 | REV

NEXT ASSY | USED ON | FINISH

SCALE: 1:2 | WEIGHT:

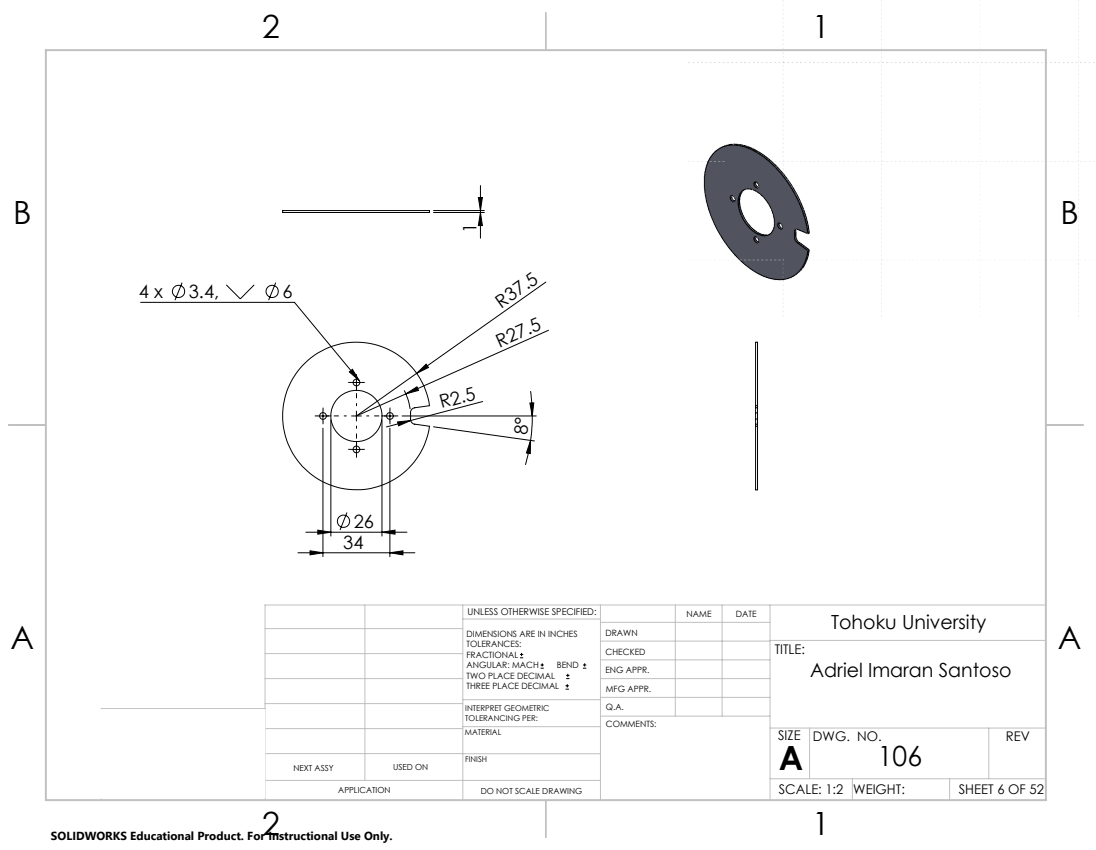
[picture p62: page 6]
Tohoku University A

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

CHECKED | | | TITLE: Adriel Imaran Santoso

ENG APPR.
MFG APPR.

INTERPRET GEOMETRIC TOLERANCING PER: | Q.A.
MATERIAL | | SIZE A | DWG. NO. 106 | REV

NEXT ASSY | USED ON | FINISH

SCALE: 1:2 | WEIGHT:

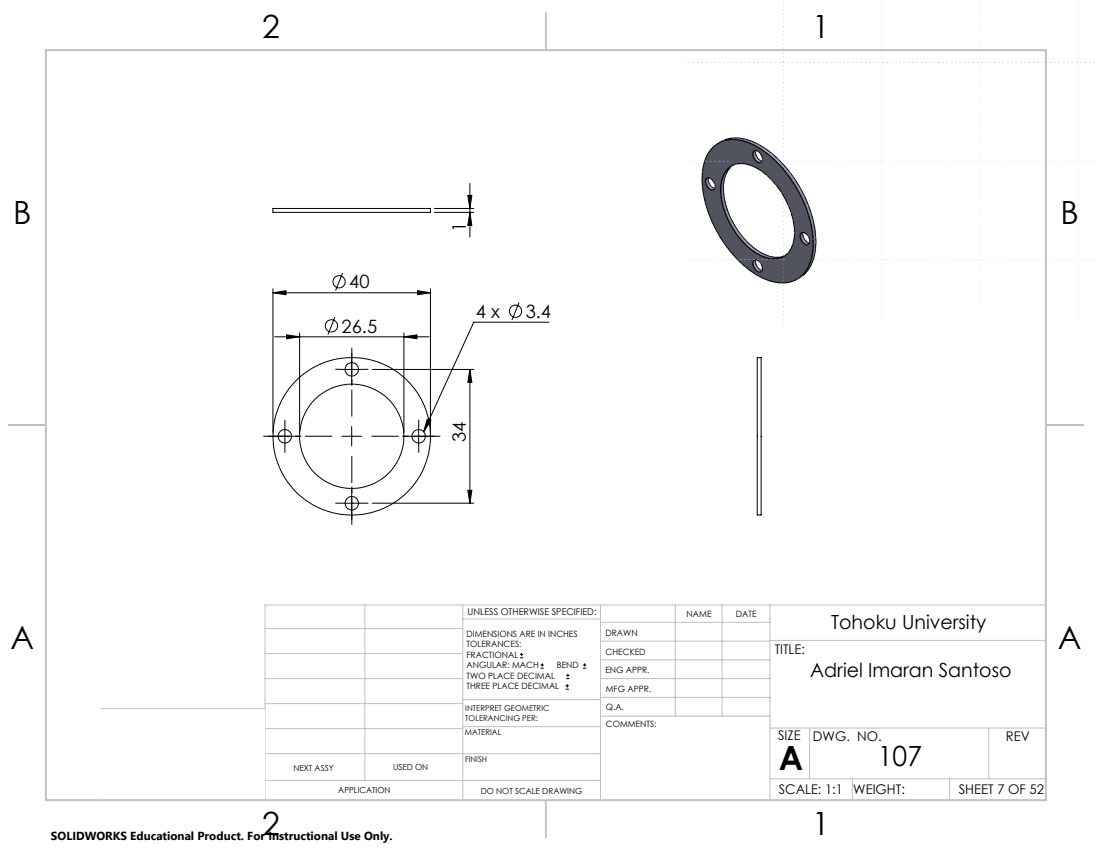
[picture p63: page 7]
Tohoku University A

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

CHECKED | | | TITLE: Adriel Imaran Santoso

ENG APPR.
MFG APPR.

INTERPRET GEOMETRIC TOLERANCING PER: | Q.A.
MATERIAL | | SIZE A | DWG. NO. 107 | REV

NEXT ASSY | USED ON | FINISH

SCALE: 1:1 | WEIGHT:

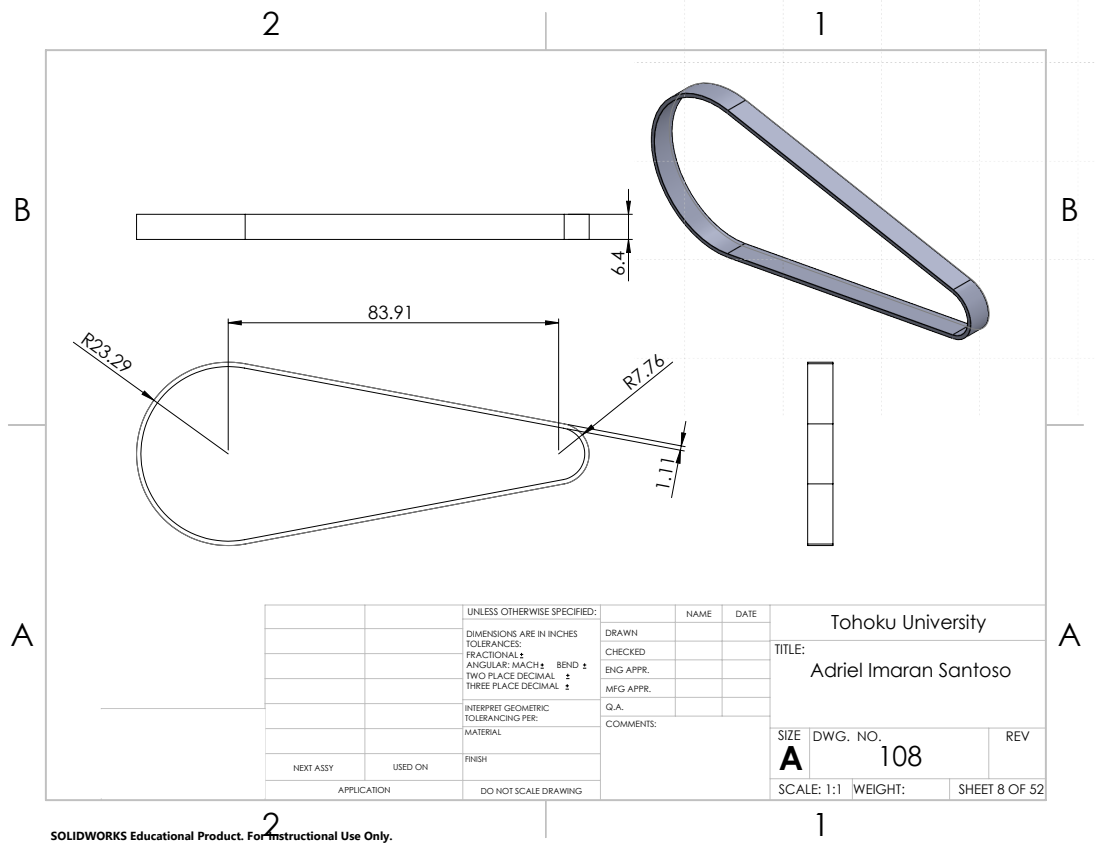
[picture p64: page 8]
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

CHECKED | | | TITLE: Adriel Imaran Santoso

ENG APPR.
MFG APPR.

INTERPRET GEOMETRIC TOLERANCING PER: | Q.A.
MATERIAL | | SIZE A | DWG. NO. 108 | REV

NEXT ASSY | USED ON | FINISH

SCALE: 1:1 | WEIGHT:

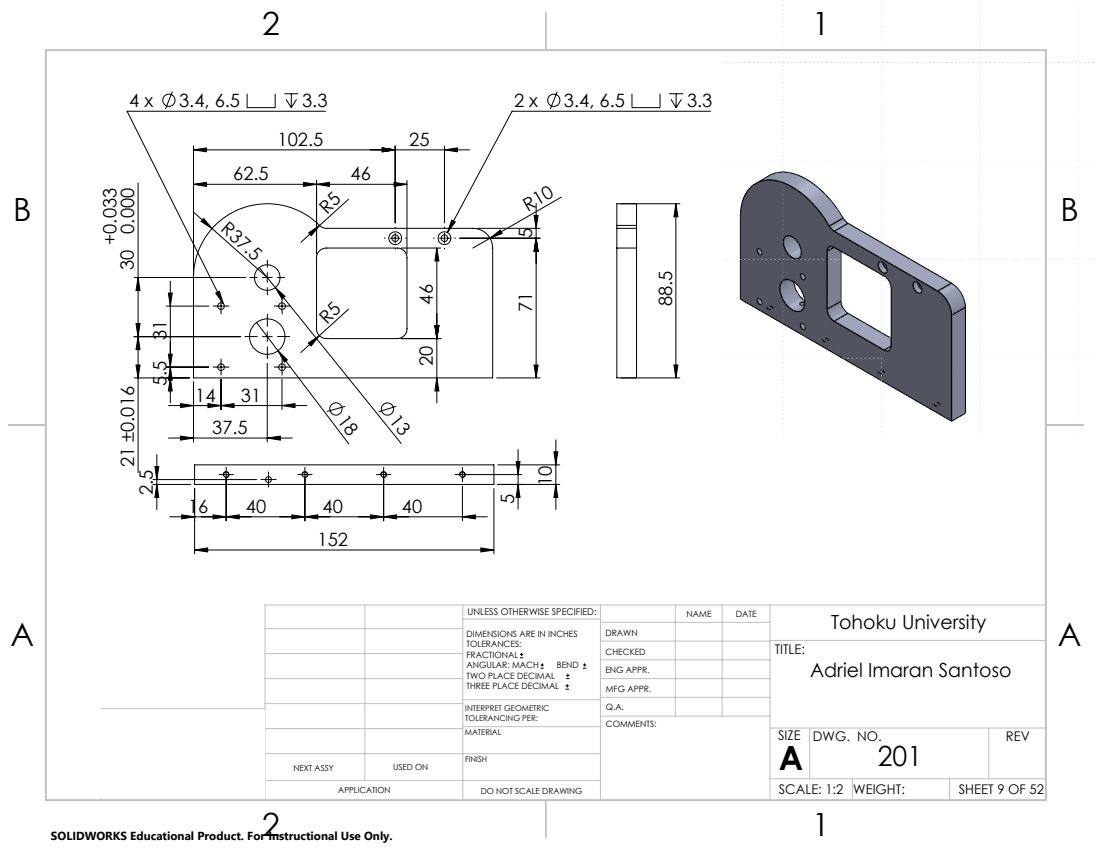
[picture p65: page 9]
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

CHECKED | | | TITLE: Adriel Imaran Santoso

ENG APPR.
MFG APPR.

INTERPRET GEOMETRIC TOLERANCING PER: | Q.A.
MATERIAL | | SIZE A | DWG. NO. 201 | REV

NEXT ASSY | USED ON | FINISH

SCALE: 1:2 | WEIGHT:

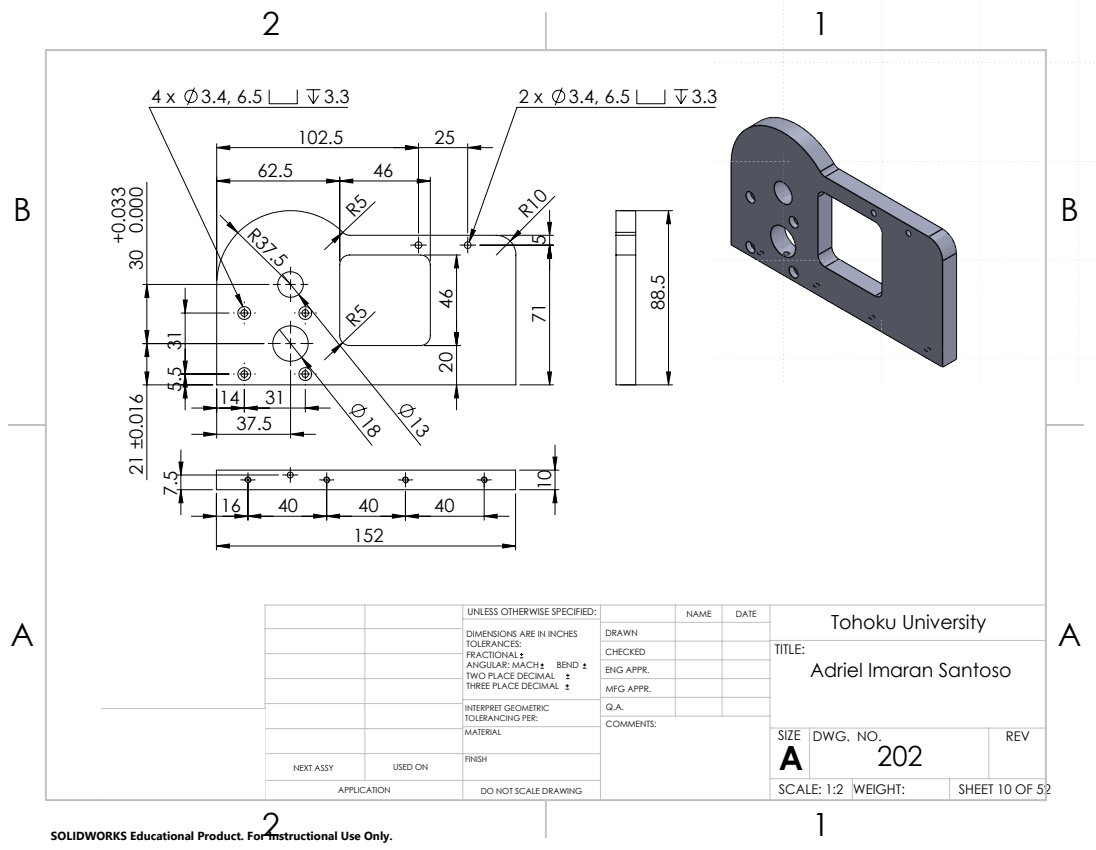
[picture p66: page 10]
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

CHECKED | | | TITLE: Adriel Imaran Santoso

ENG APPR.
MFG APPR.

INTERPRET GEOMETRIC TOLERANCING PER: | Q.A.
MATERIAL | | SIZE A | DWG. NO. 202 | REV

NEXT ASSY | USED ON | FINISH

SCALE: 1:2 | WEIGHT:

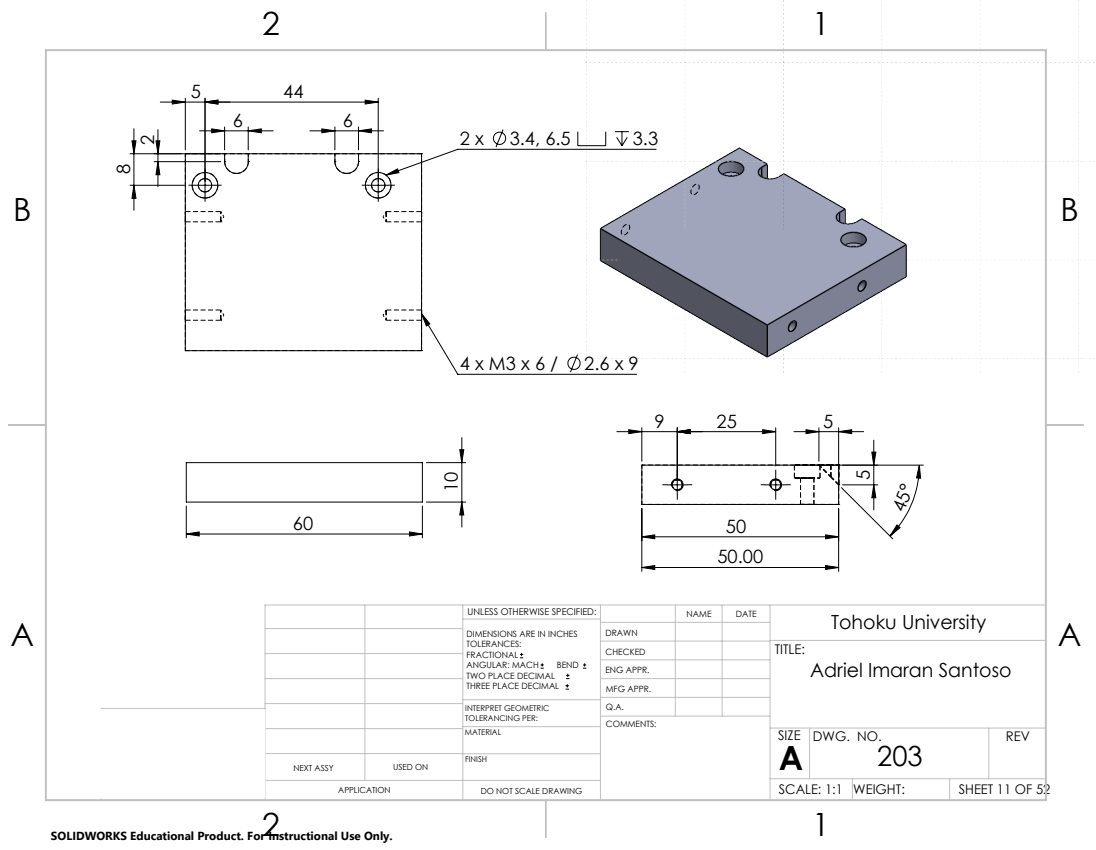
[picture p67: page 11]
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

CHECKED | | | TITLE: Adriel Imaran Santoso

ENG APPR.
MFG APPR.

INTERPRET GEOMETRIC TOLERANCING PER: | Q.A.
MATERIAL | | SIZE A | DWG. NO. 203 | REV

NEXT ASSY | USED ON | FINISH

SCALE: 1:1 | WEIGHT:

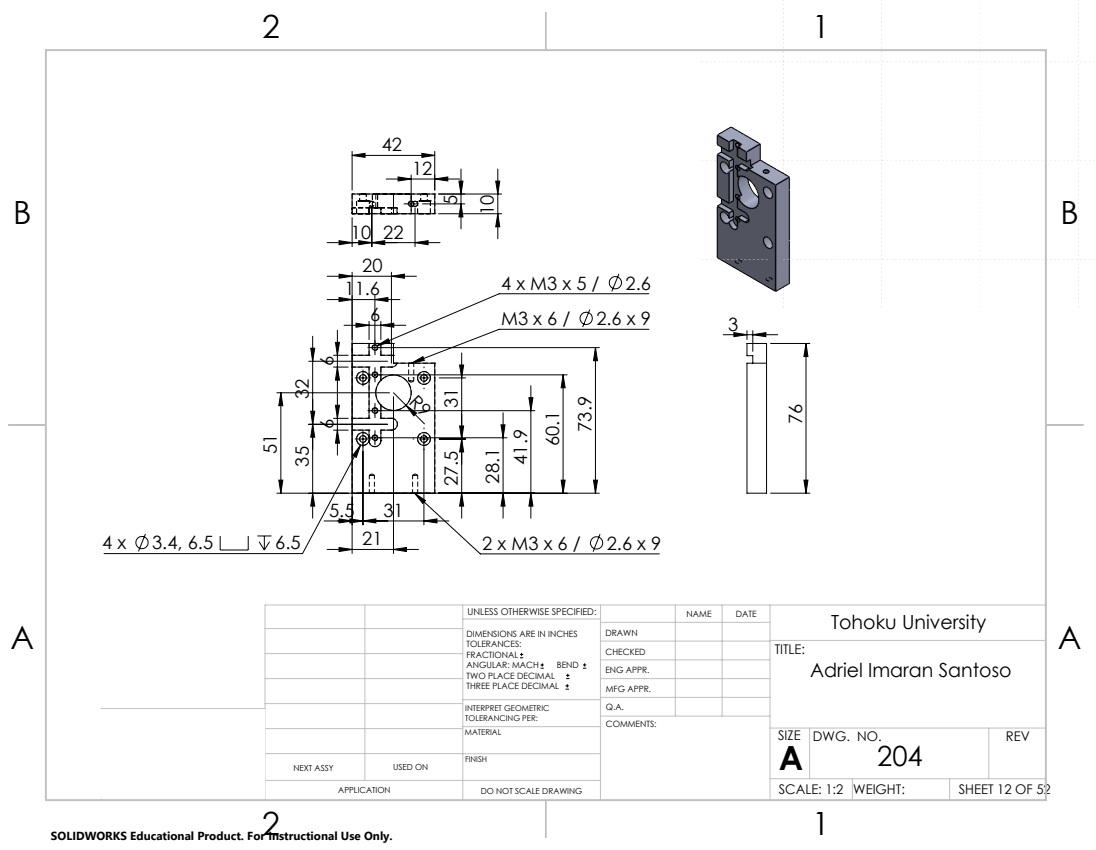
[picture p68: page 12]
Tohoku University A

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

CHECKED | | | TITLE: Adriel Imaran Santoso

ENG APPR.
MFG APPR.

INTERPRET GEOMETRIC TOLERANCING PER: | Q.A.
MATERIAL | | SIZE A | DWG. NO. 204 | REV

NEXT ASSY | USED ON | FINISH

SCALE: 1:2 | WEIGHT:

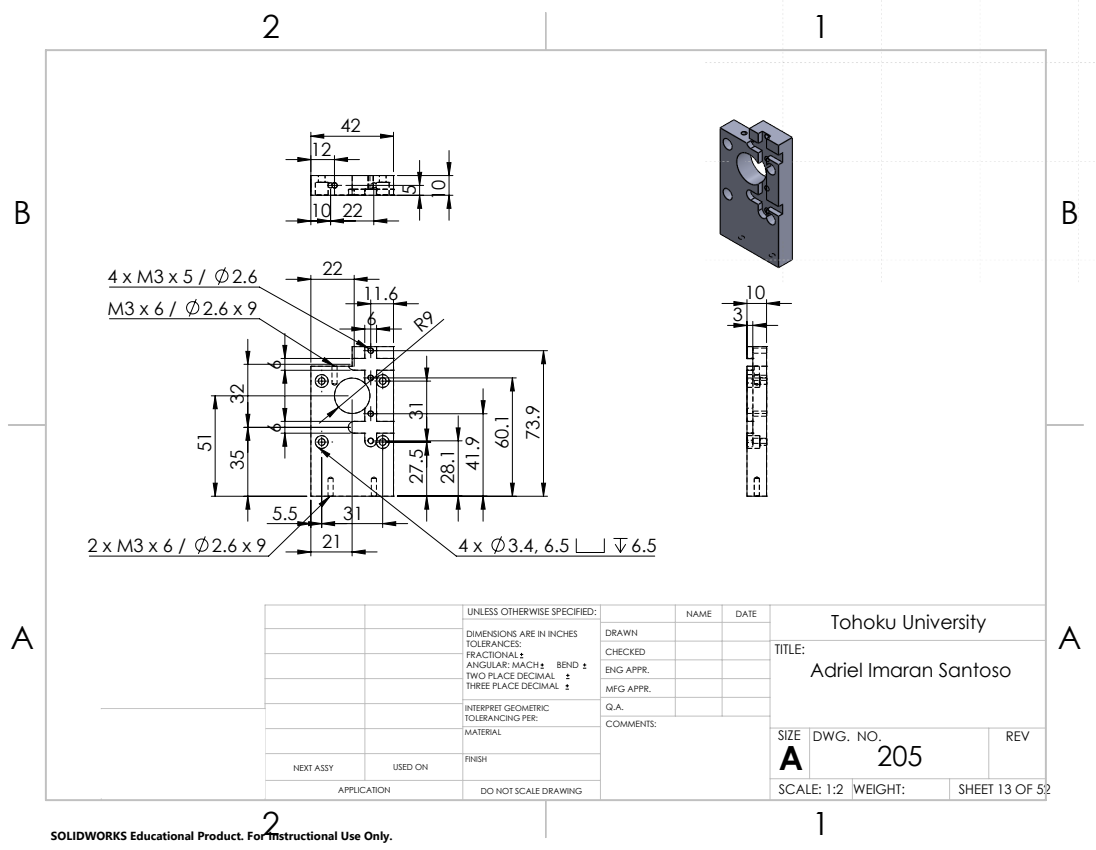
[picture p69: page 13]
Tohoku University A

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

CHECKED | | | TITLE: Adriel Imaran Santoso

ENG APPR.
MFG APPR.

INTERPRET GEOMETRIC TOLERANCING PER: | Q.A.
MATERIAL | | SIZE A | DWG. NO. 205 | REV

NEXT ASSY | USED ON | FINISH

SCALE: 1:2 | WEIGHT:

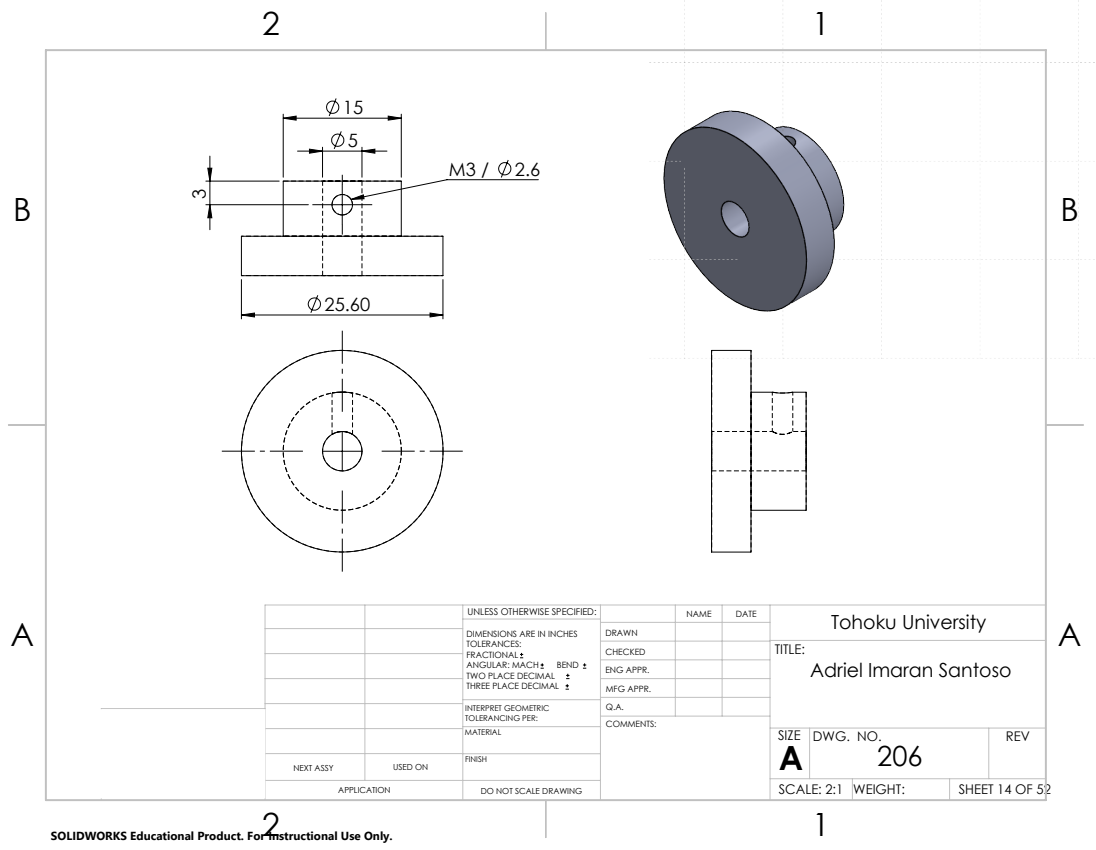
[picture p70: page 14]
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

CHECKED | | | TITLE: Adriel Imaran Santoso

ENG APPR.
MFG APPR.

INTERPRET GEOMETRIC TOLERANCING PER: | Q.A.
MATERIAL | | SIZE A | DWG. NO. 206 | REV

NEXT ASSY | USED ON | FINISH

SCALE: 2:1 | WEIGHT:

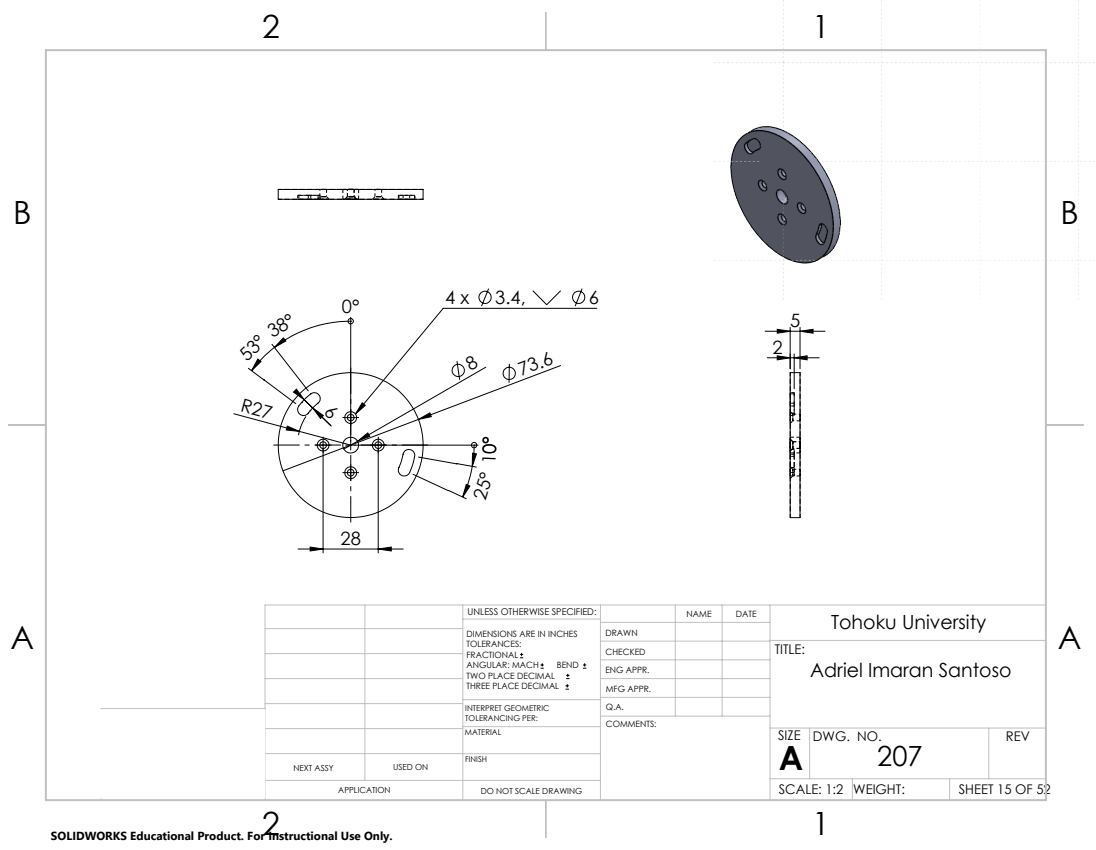
[picture p71: page 15]
Tohoku University A

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

CHECKED | | | TITLE: Adriel Imaran Santoso

ENG APPR.
MFG APPR.

INTERPRET GEOMETRIC TOLERANCING PER: | Q.A.
MATERIAL | | SIZE A | DWG. NO. 207 | REV

NEXT ASSY | USED ON | FINISH

SCALE: 1:2 | WEIGHT:

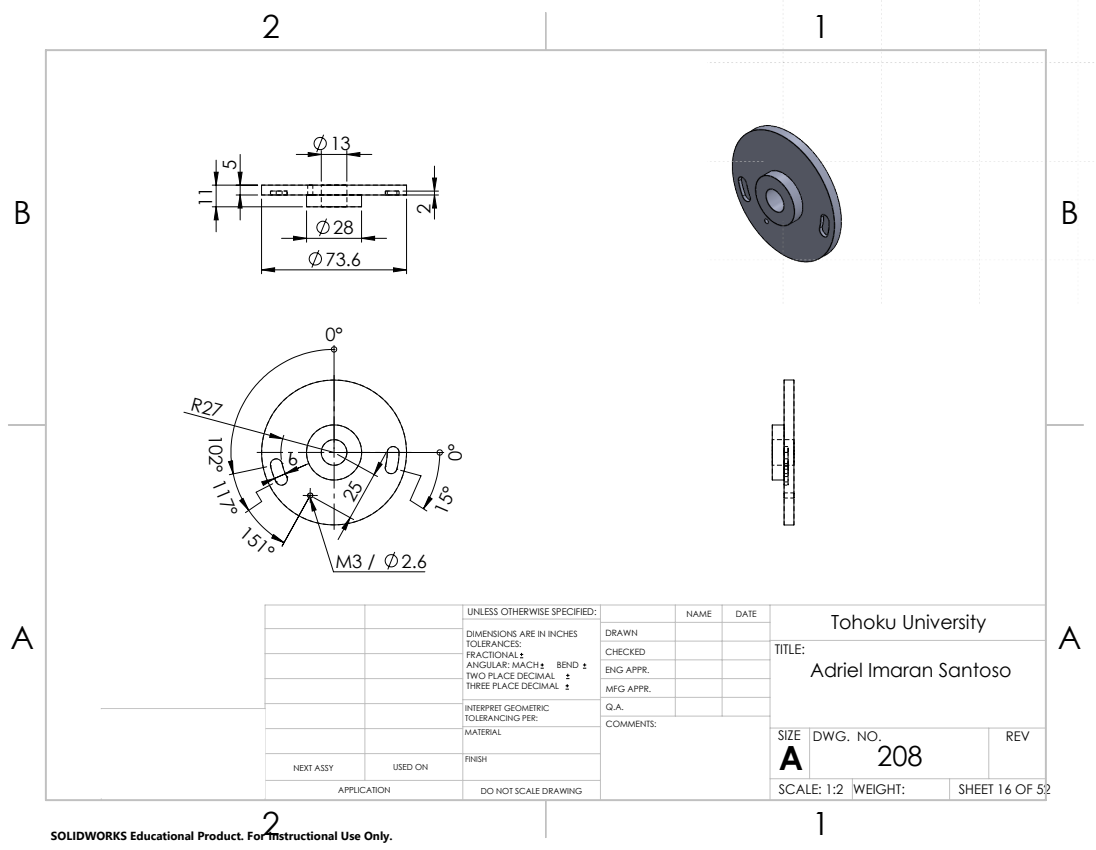
[picture p72: page 16]
Tohoku University A

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

CHECKED | | | TITLE: Adriel Imaran Santoso

ENG APPR.
MFG APPR.

INTERPRET GEOMETRIC TOLERANCING PER: | Q.A.
MATERIAL | | SIZE A | DWG. NO. 208 | REV

NEXT ASSY | USED ON | FINISH

SCALE: 1:2 | WEIGHT:

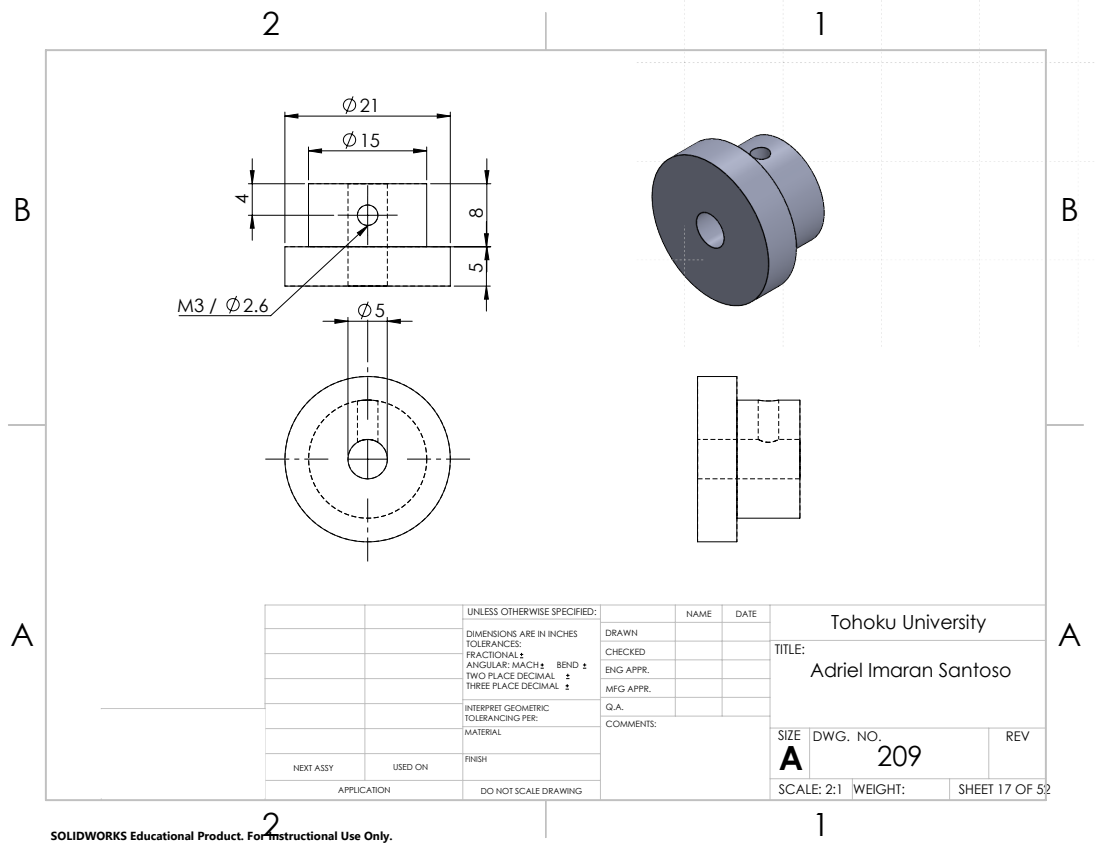
[picture p73: page 17]
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

CHECKED | | | TITLE: Adriel Imaran Santoso

ENG APPR.
MFG APPR.

INTERPRET GEOMETRIC TOLERANCING PER: | Q.A.
MATERIAL | | SIZE A | DWG. NO. 209 | REV

NEXT ASSY | USED ON | FINISH

SCALE: 2:1 | WEIGHT:

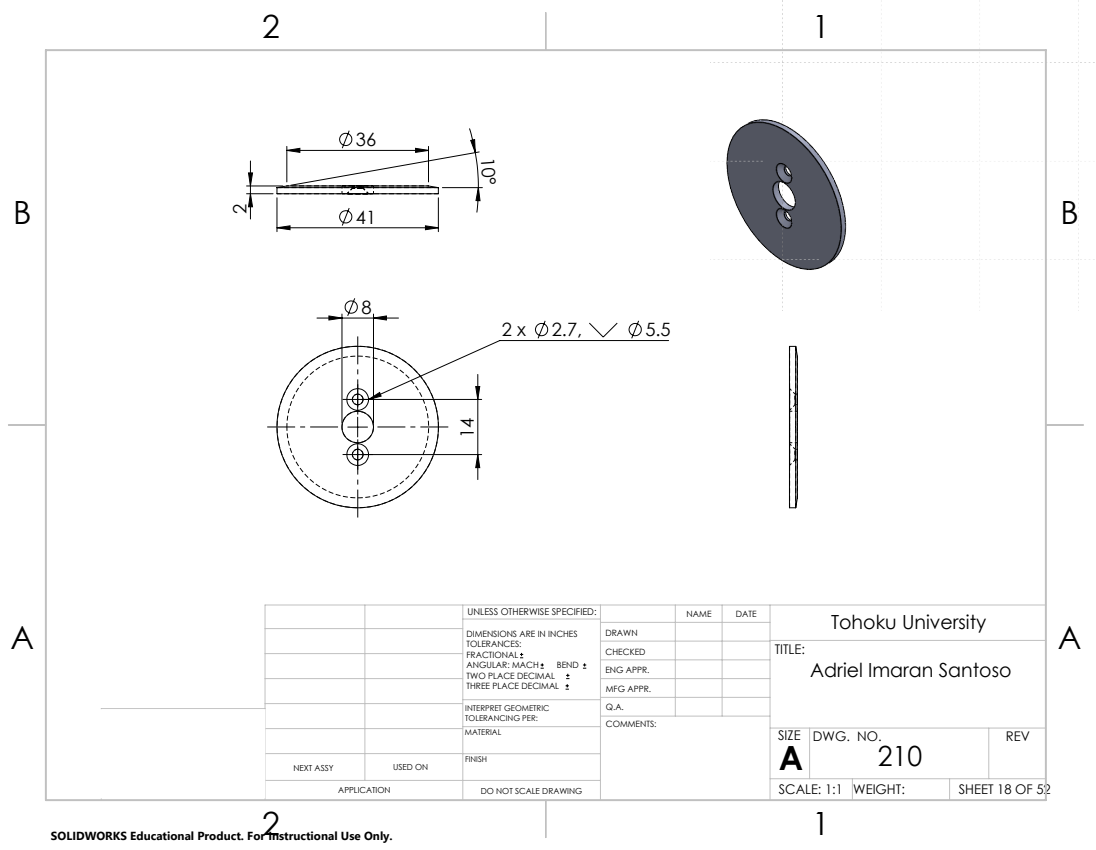
[picture p74: page 18]
Tohoku University A

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

CHECKED | | | TITLE: Adriel Imaran Santoso

ENG APPR.
MFG APPR.

INTERPRET GEOMETRIC TOLERANCING PER: | Q.A.
MATERIAL | | SIZE A | DWG. NO. 210 | REV

NEXT ASSY | USED ON | FINISH

SCALE: 1:1 | WEIGHT:

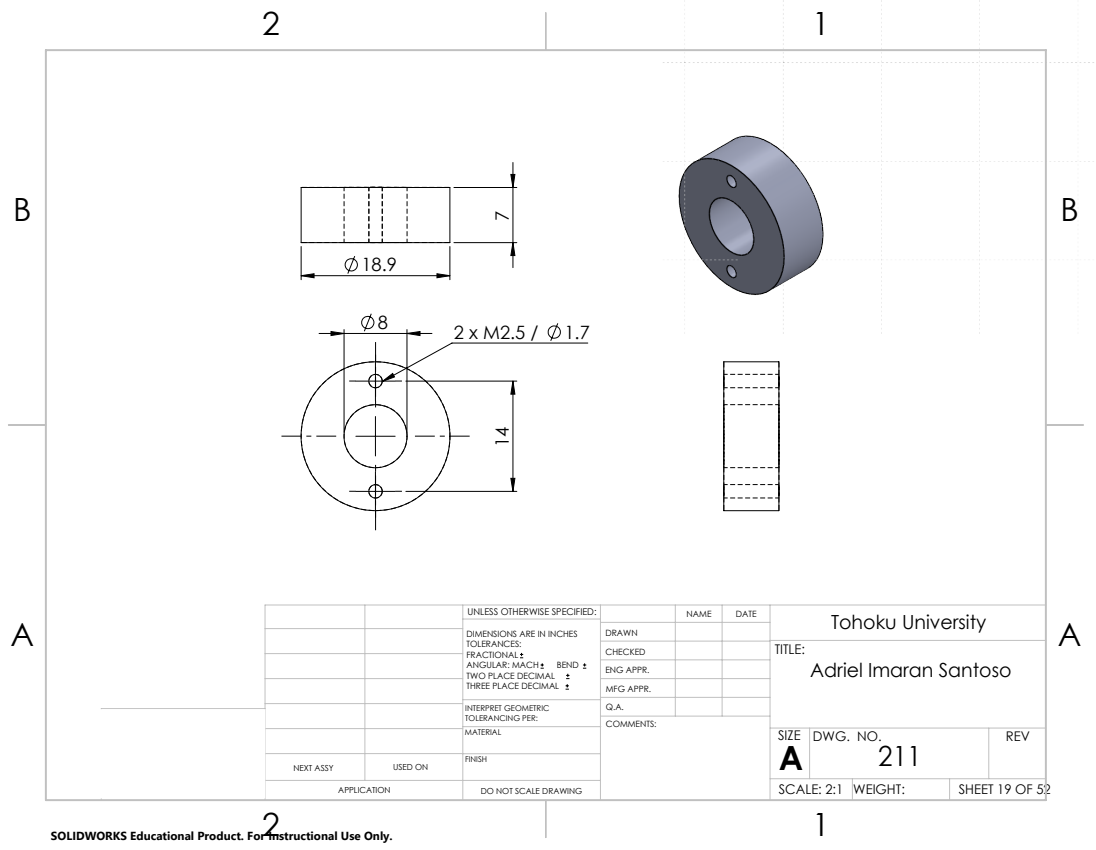
[picture p75: page 19]
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

CHECKED | | | TITLE: Adriel Imaran Santoso

ENG APPR.
MFG APPR.

INTERPRET GEOMETRIC TOLERANCING PER: | Q.A.
MATERIAL | | SIZE A | DWG. NO. 211 | REV

NEXT ASSY | USED ON | FINISH

SCALE: 2:1 | WEIGHT:

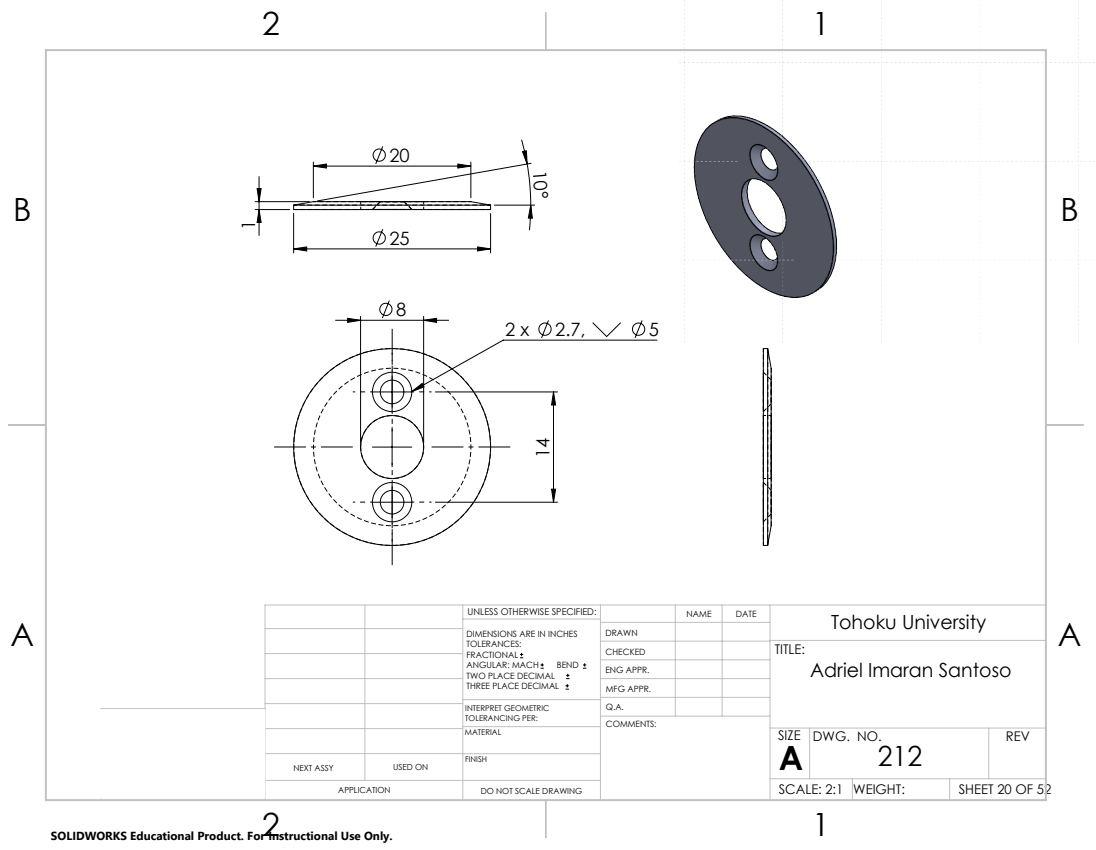
[picture p76: page 20]
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

CHECKED | | | TITLE: Adriel Imaran Santoso

ENG APPR.
MFG APPR.

INTERPRET GEOMETRIC TOLERANCING PER: | Q.A.
MATERIAL | | SIZE A | DWG. NO. 212 | REV

NEXT ASSY | USED ON | FINISH

SCALE: 2:1 | WEIGHT:

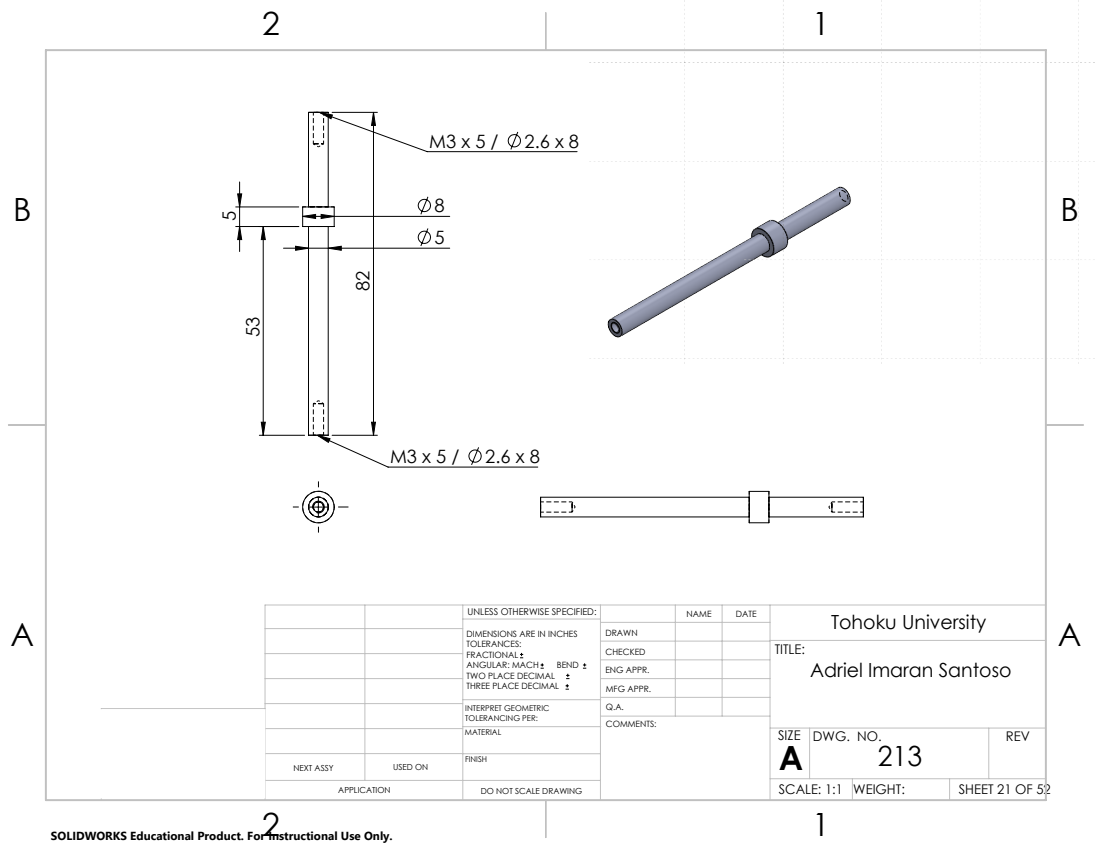
[picture p77: page 21]
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

CHECKED | | | TITLE: Adriel Imaran Santoso

ENG APPR.
MFG APPR.

INTERPRET GEOMETRIC TOLERANCING PER: | Q.A.
MATERIAL | | SIZE A | DWG. NO. 213 | REV

NEXT ASSY | USED ON | FINISH

SCALE: 1:1 | WEIGHT:

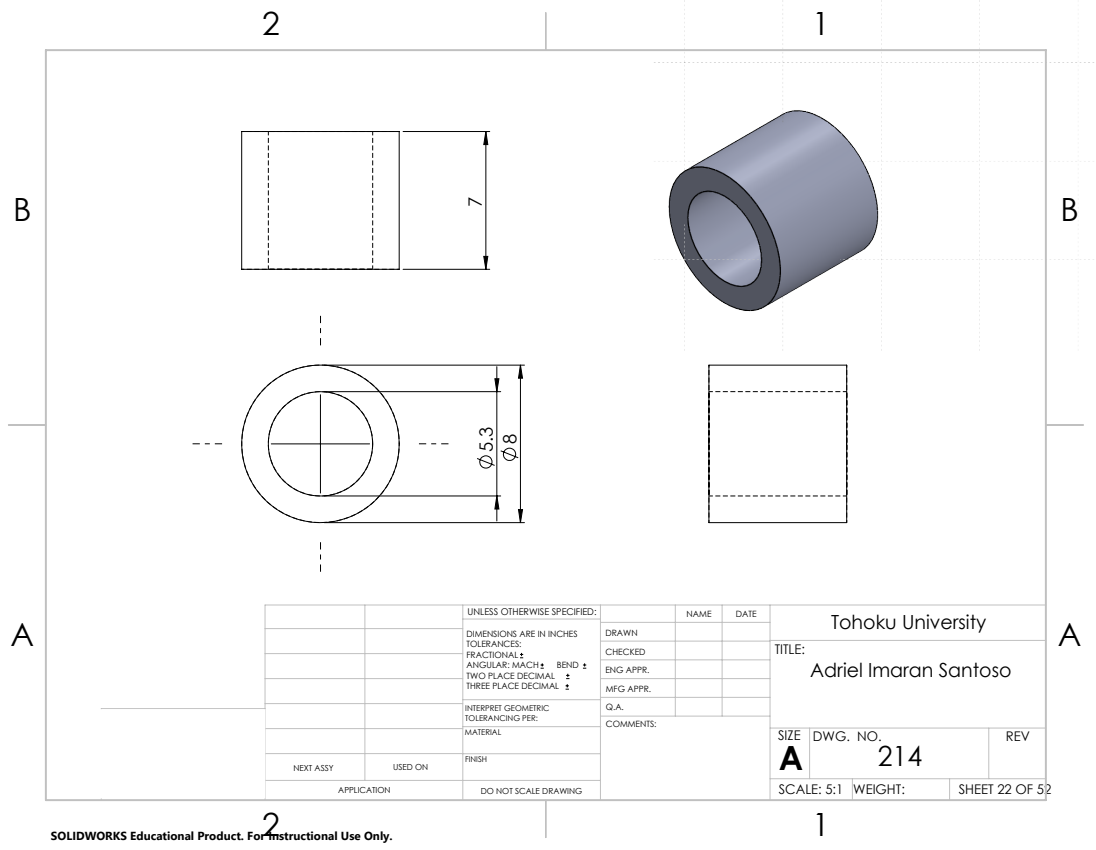
[picture p78: page 22]
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

CHECKED | | | TITLE: Adriel Imaran Santoso

ENG APPR.
MFG APPR.

INTERPRET GEOMETRIC TOLERANCING PER: | Q.A.
MATERIAL | | SIZE A | DWG. NO. 214 | REV

NEXT ASSY | USED ON | FINISH

SCALE: 5:1 | WEIGHT:

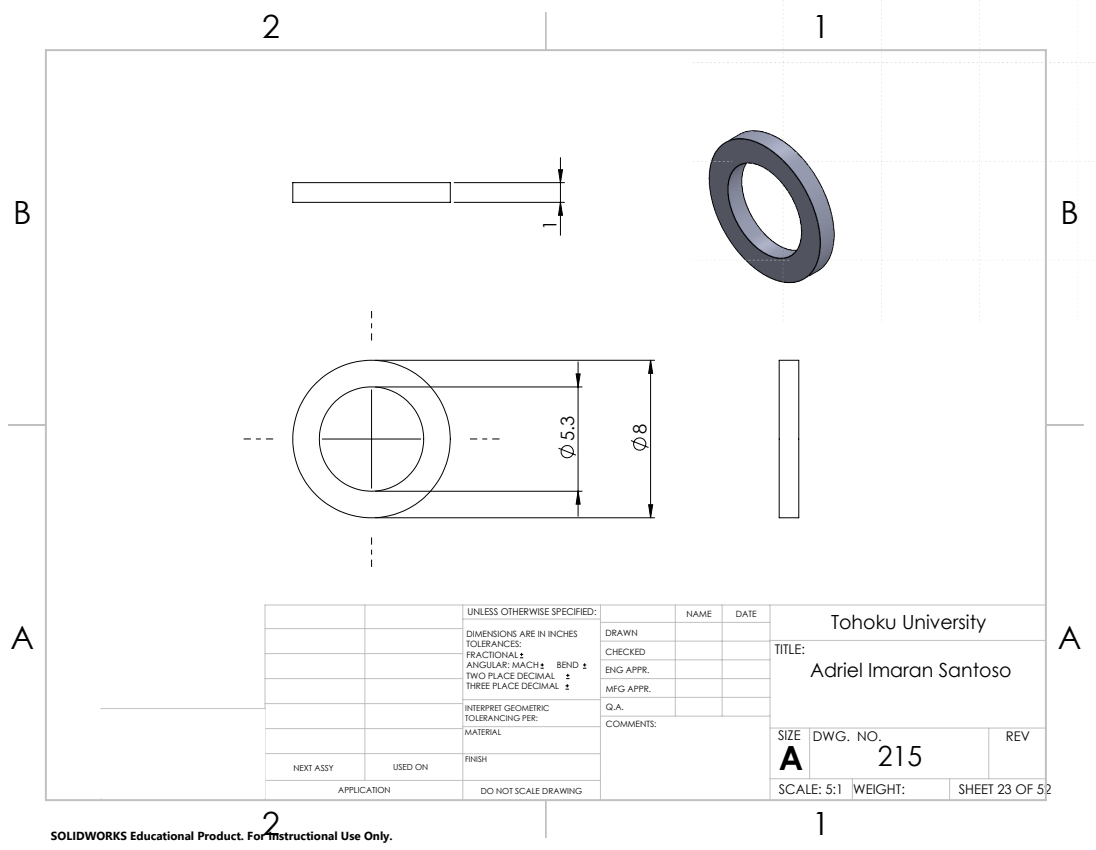
[picture p79: page 23]
Tohoku University A

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

CHECKED | | | TITLE: Adriel Imaran Santoso

ENG APPR.
MFG APPR.

INTERPRET GEOMETRIC TOLERANCING PER: | Q.A.
MATERIAL | | SIZE A | DWG. NO. 215 | REV

NEXT ASSY | USED ON | FINISH

SCALE: 5:1 | WEIGHT:

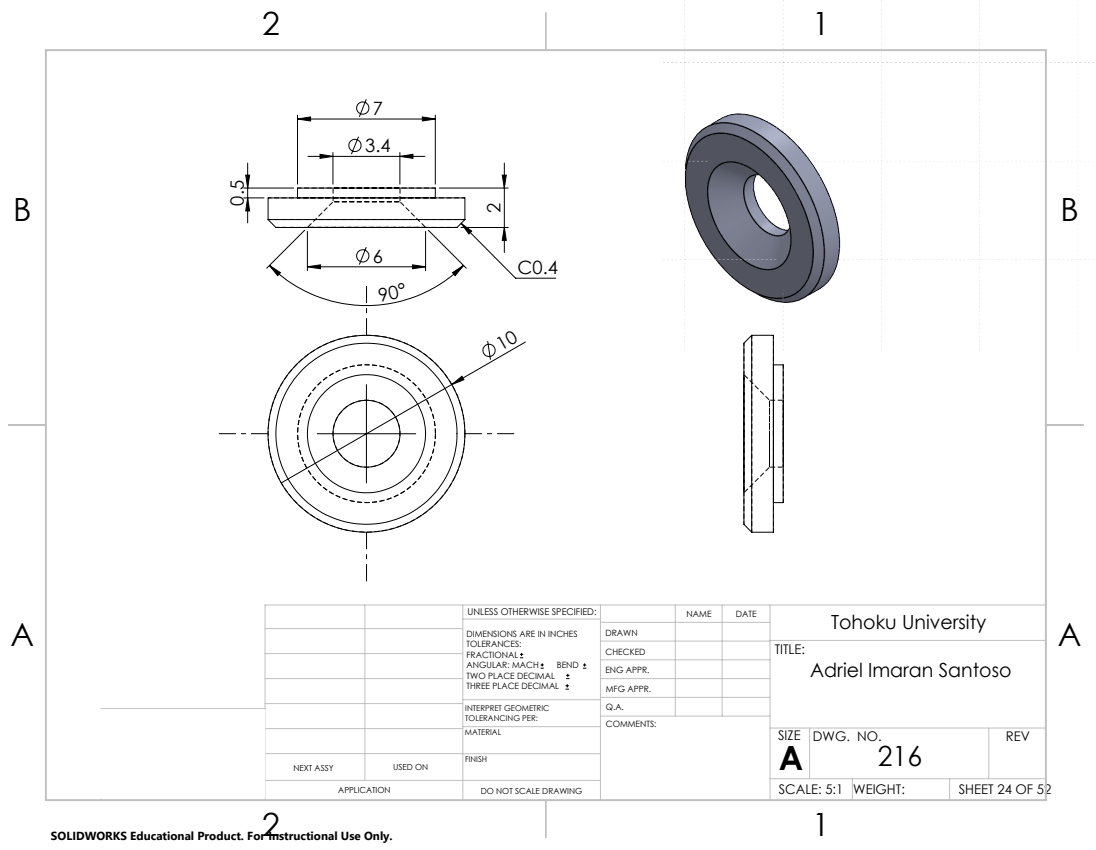
[picture p80: page 24]
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

CHECKED | | | TITLE: Adriel Imaran Santoso

ENG APPR.
MFG APPR.

INTERPRET GEOMETRIC TOLERANCING PER: | Q.A.
MATERIAL | | SIZE A | DWG. NO. 216 | REV

NEXT ASSY | USED ON | FINISH

SCALE: 5:1 | WEIGHT:

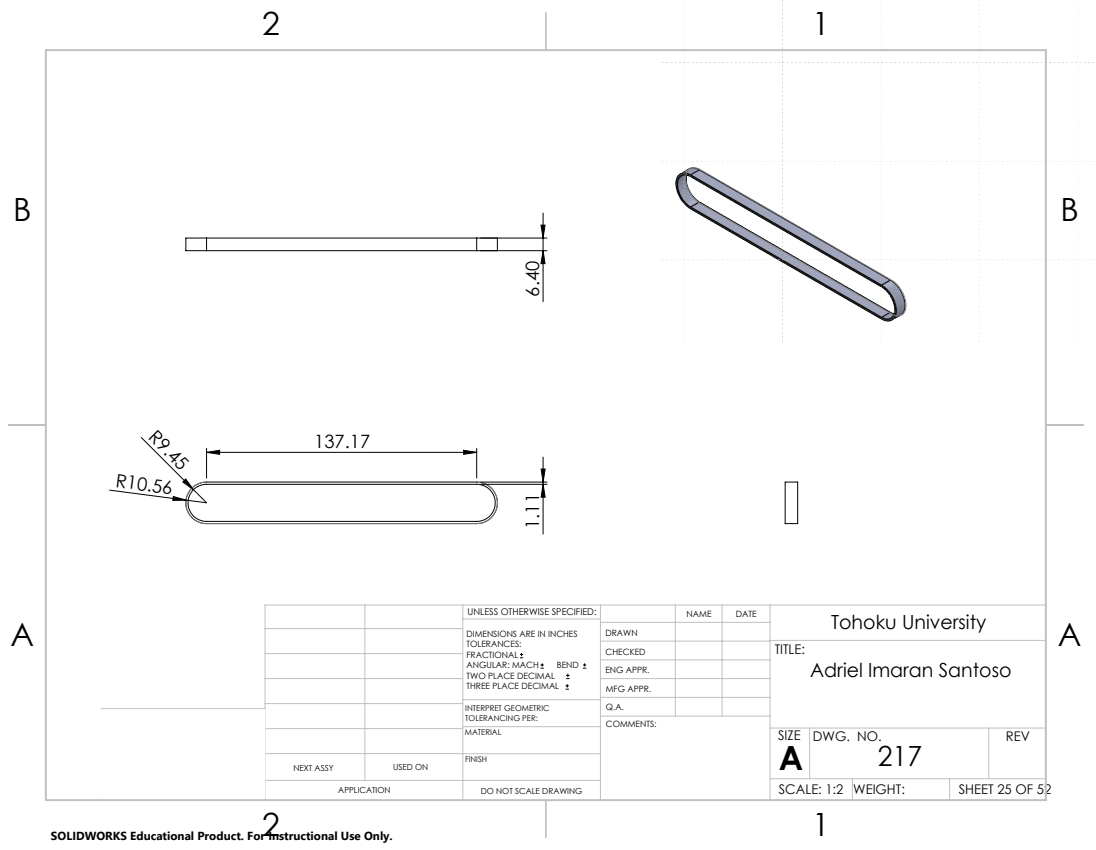
[picture p81: page 25]
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

CHECKED | | | TITLE: Adriel Imaran Santoso

ENG APPR.
MFG APPR.

INTERPRET GEOMETRIC TOLERANCING PER: | Q.A.
MATERIAL | | SIZE A | DWG. NO. 217 | REV

NEXT ASSY | USED ON | FINISH

SCALE: 1:2 | WEIGHT:

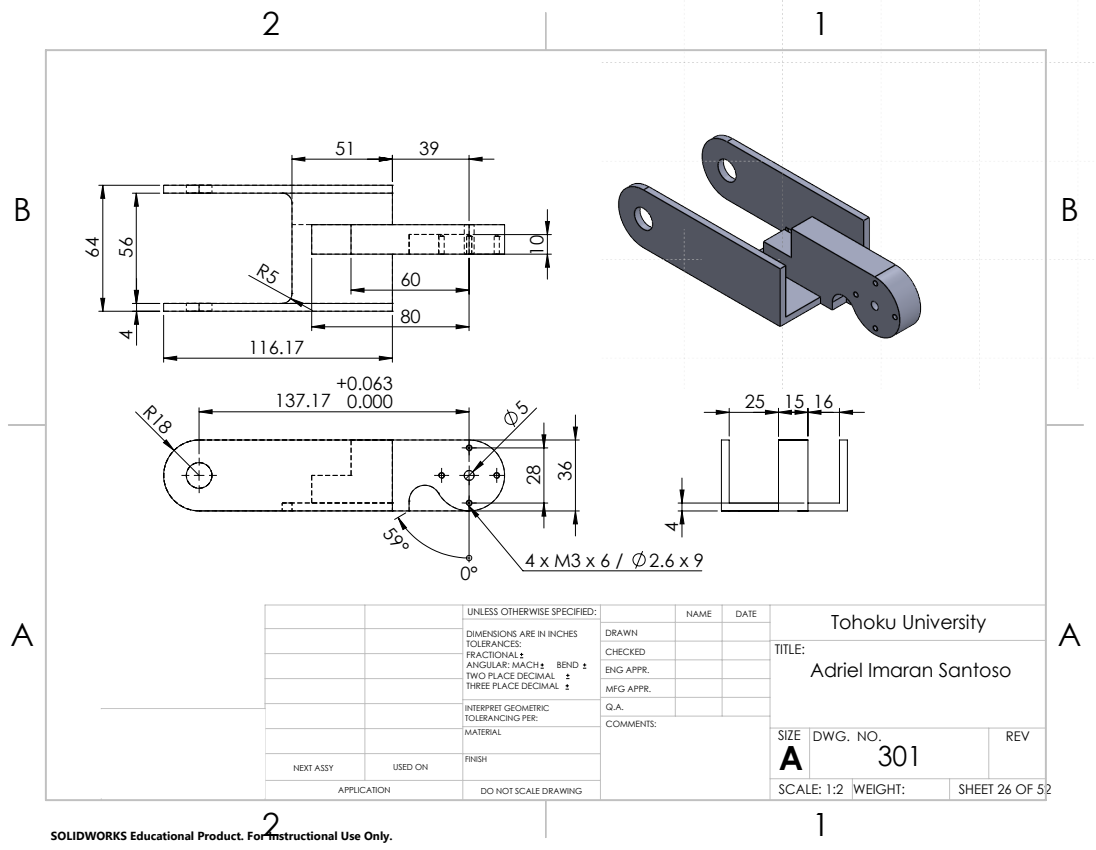
[picture p82: page 26]
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

CHECKED | | | TITLE: Adriel Imaran Santoso

ENG APPR.
MFG APPR.

INTERPRET GEOMETRIC TOLERANCING PER: | Q.A.
MATERIAL | | SIZE A | DWG. NO. 301 | REV

NEXT ASSY | USED ON | FINISH

SCALE: 1:2 | WEIGHT:

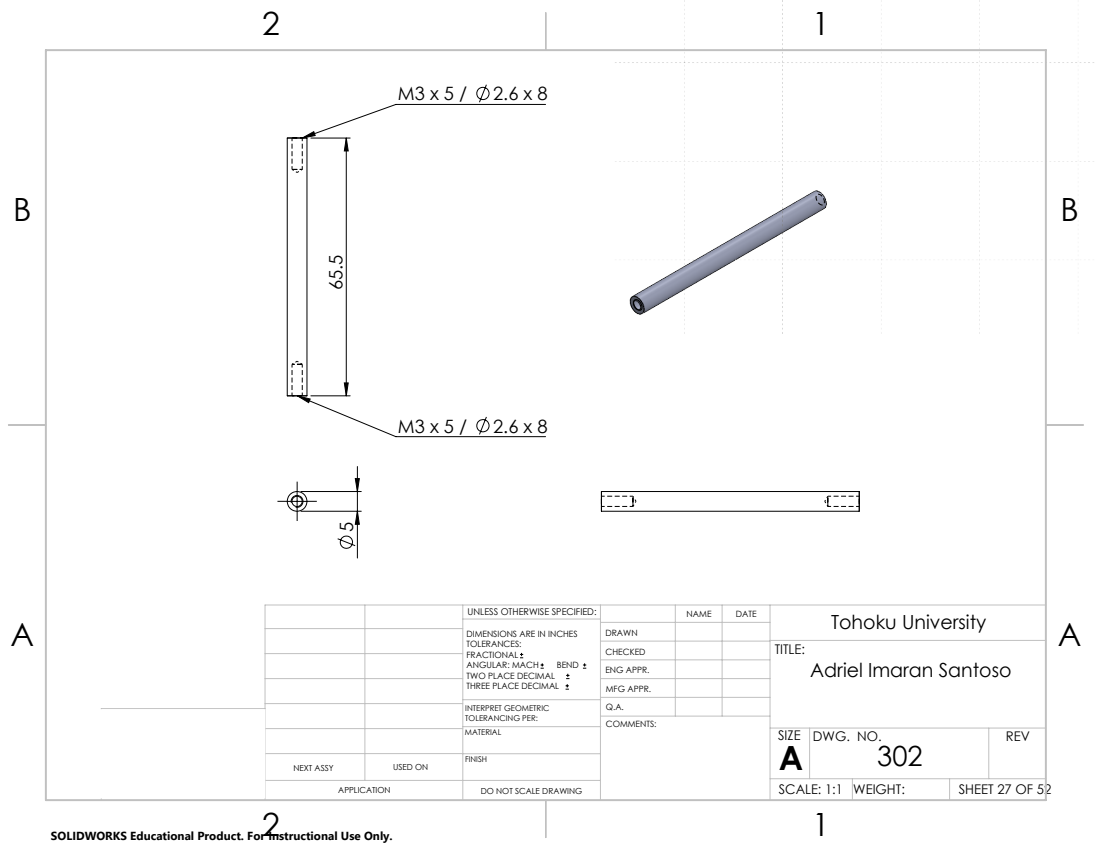
[picture p83: page 27]
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

CHECKED | | | TITLE: Adriel Imaran Santoso

ENG APPR.
MFG APPR.

INTERPRET GEOMETRIC TOLERANCING PER: | Q.A.
MATERIAL | | SIZE A | DWG. NO. 302 | REV

NEXT ASSY | USED ON | FINISH

SCALE: 1:1 | WEIGHT:

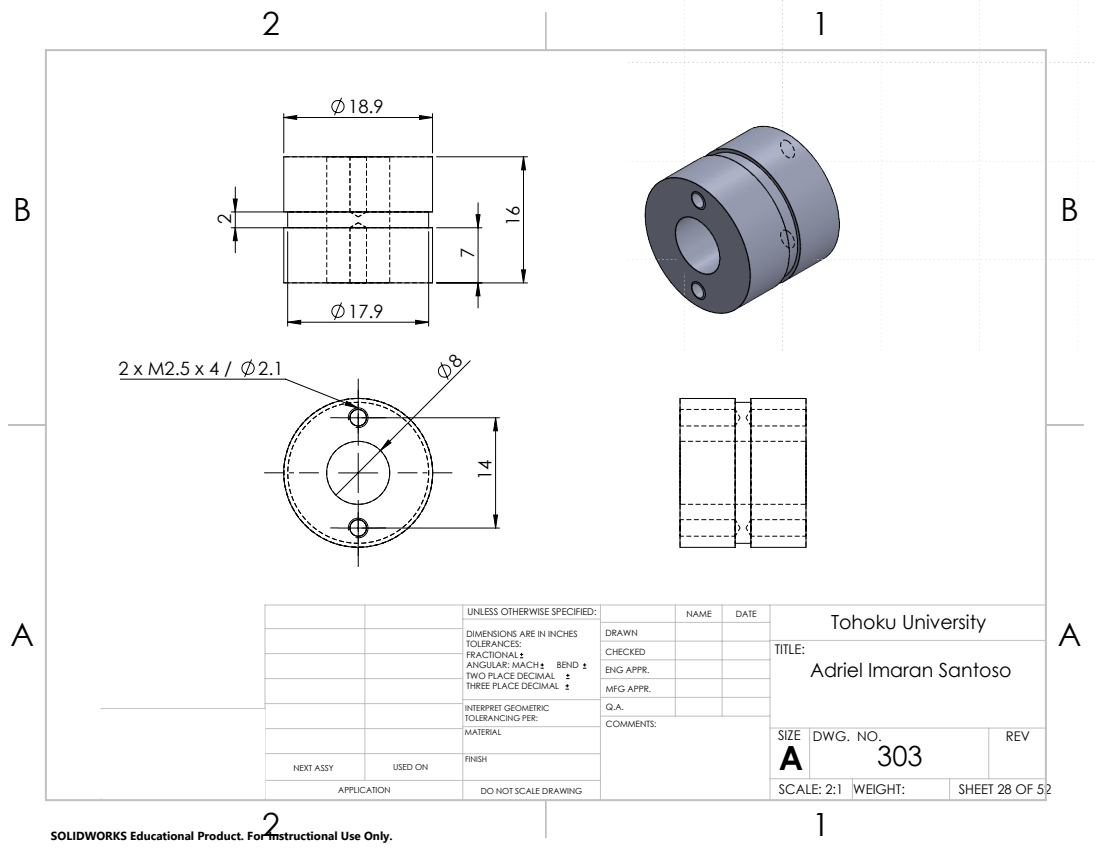
[picture p84: page 28]
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

CHECKED | | | TITLE: Adriel Imaran Santoso

ENG APPR.
MFG APPR.

INTERPRET GEOMETRIC TOLERANCING PER: | Q.A.
MATERIAL | | SIZE A | DWG. NO. 303 | REV

NEXT ASSY | USED ON | FINISH

SCALE: 2:1 | WEIGHT:

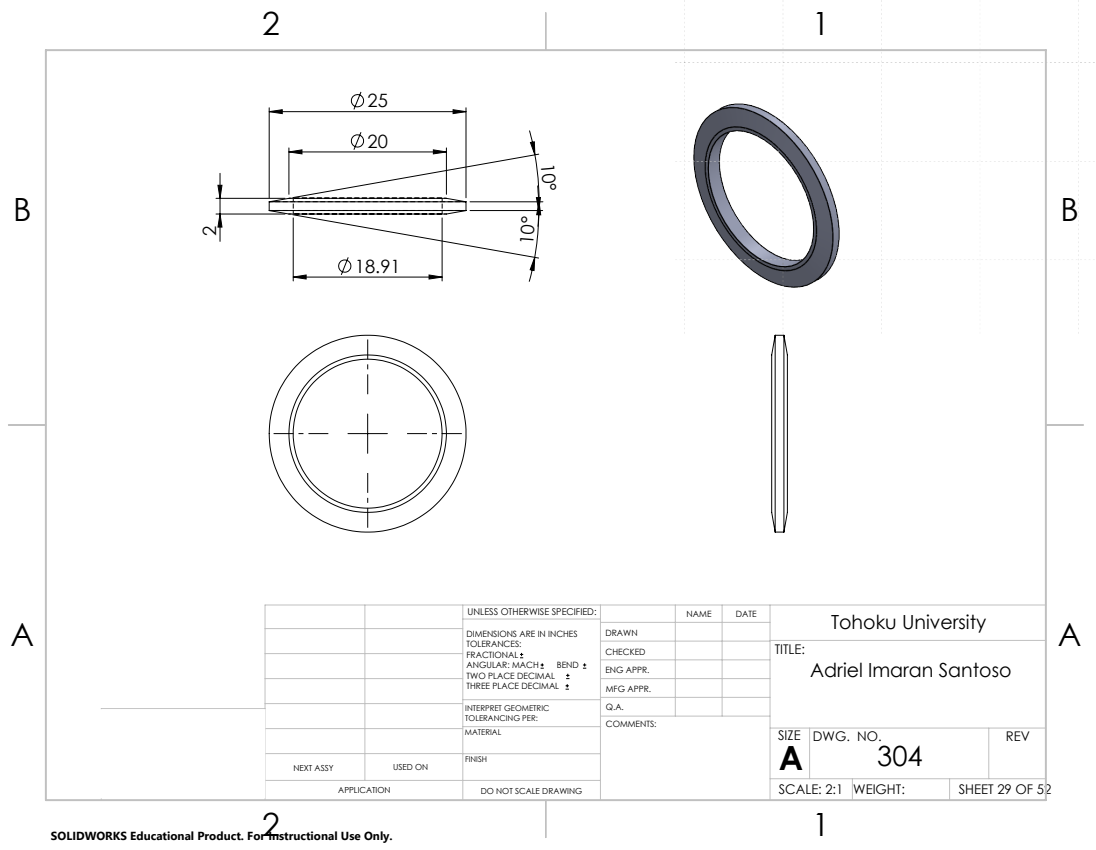
[picture p85: page 29]
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

CHECKED | | | TITLE: Adriel Imaran Santoso

ENG APPR.
MFG APPR.

INTERPRET GEOMETRIC TOLERANCING PER: | Q.A.
MATERIAL | | SIZE A | DWG. NO. 304 | REV

NEXT ASSY | USED ON | FINISH

SCALE: 2:1 | WEIGHT:

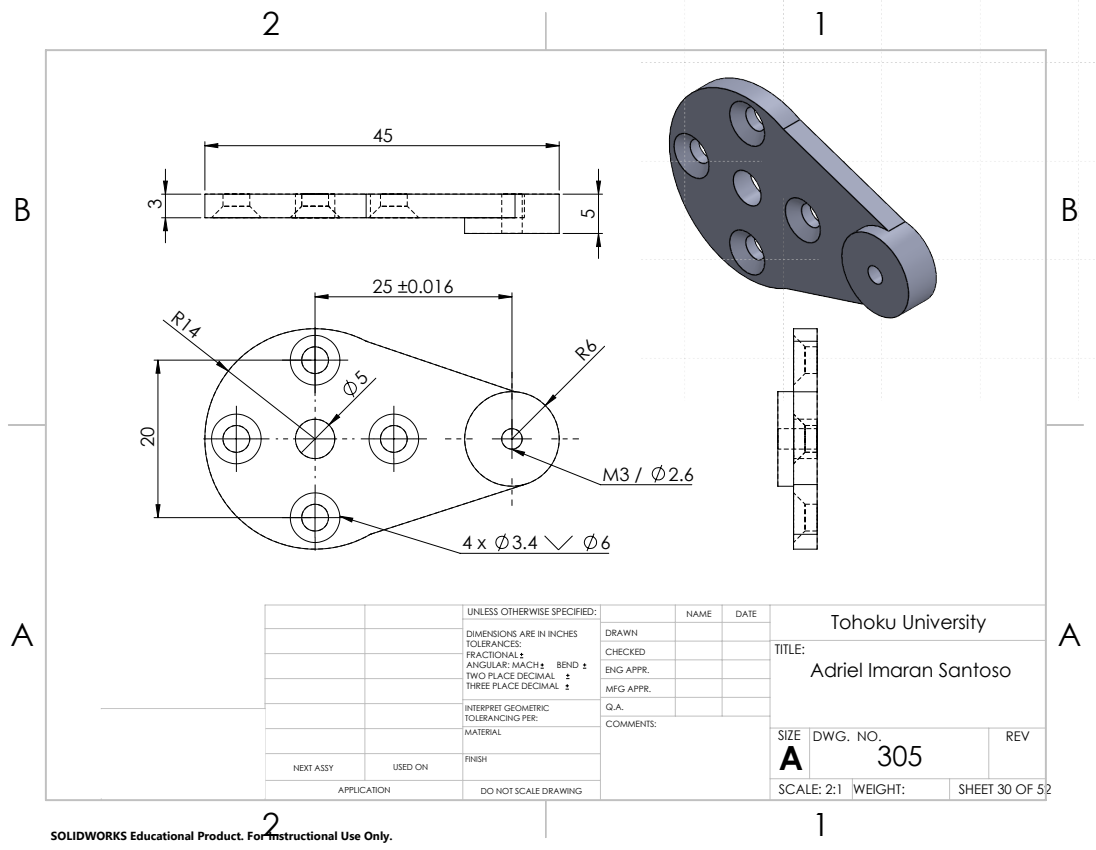
[picture p86: page 30]
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

CHECKED | | | TITLE: Adriel Imaran Santoso

ENG APPR.
MFG APPR.

INTERPRET GEOMETRIC TOLERANCING PER: | Q.A.
MATERIAL | | SIZE A | DWG. NO. 305 | REV

NEXT ASSY | USED ON | FINISH

SCALE: 2:1 | WEIGHT:

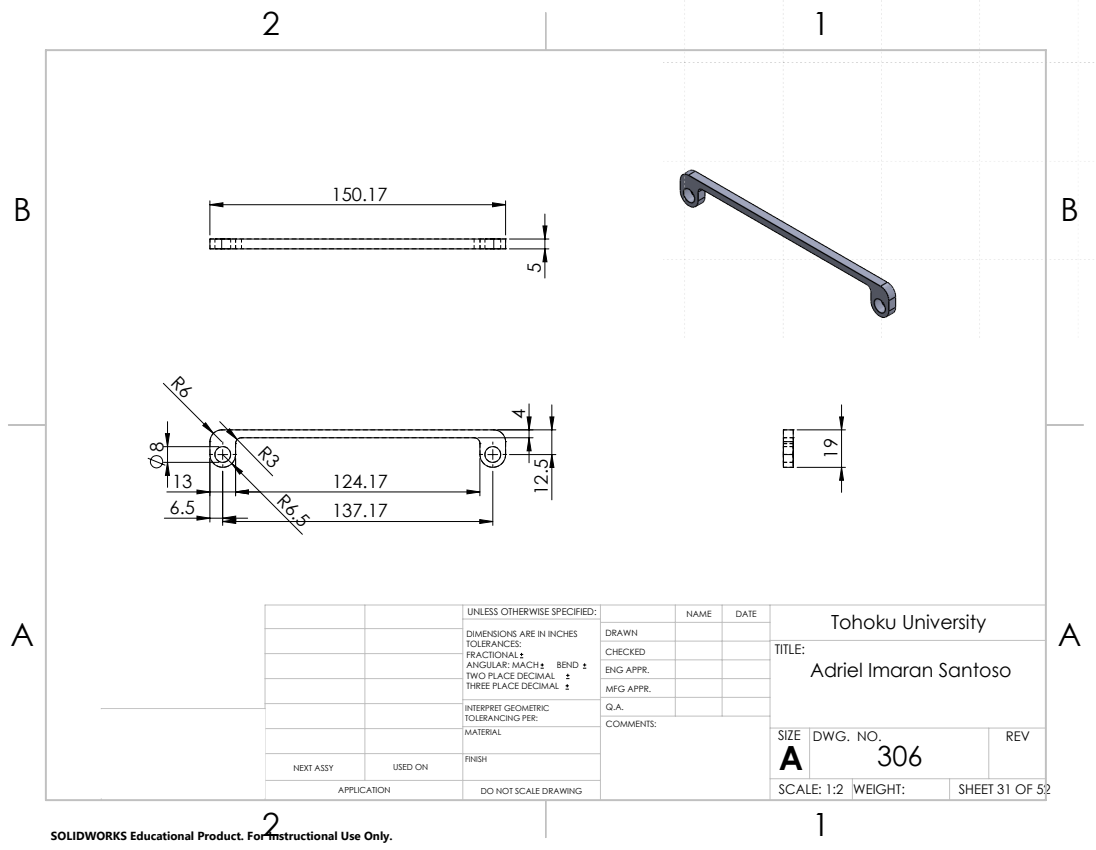
[picture p87: page 31]
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

CHECKED | | | TITLE: Adriel Imaran Santoso

ENG APPR.
MFG APPR.

INTERPRET GEOMETRIC TOLERANCING PER: | Q.A.
MATERIAL | | SIZE A | DWG. NO. 306 | REV

NEXT ASSY | USED ON | FINISH

SCALE: 1:2 | WEIGHT:

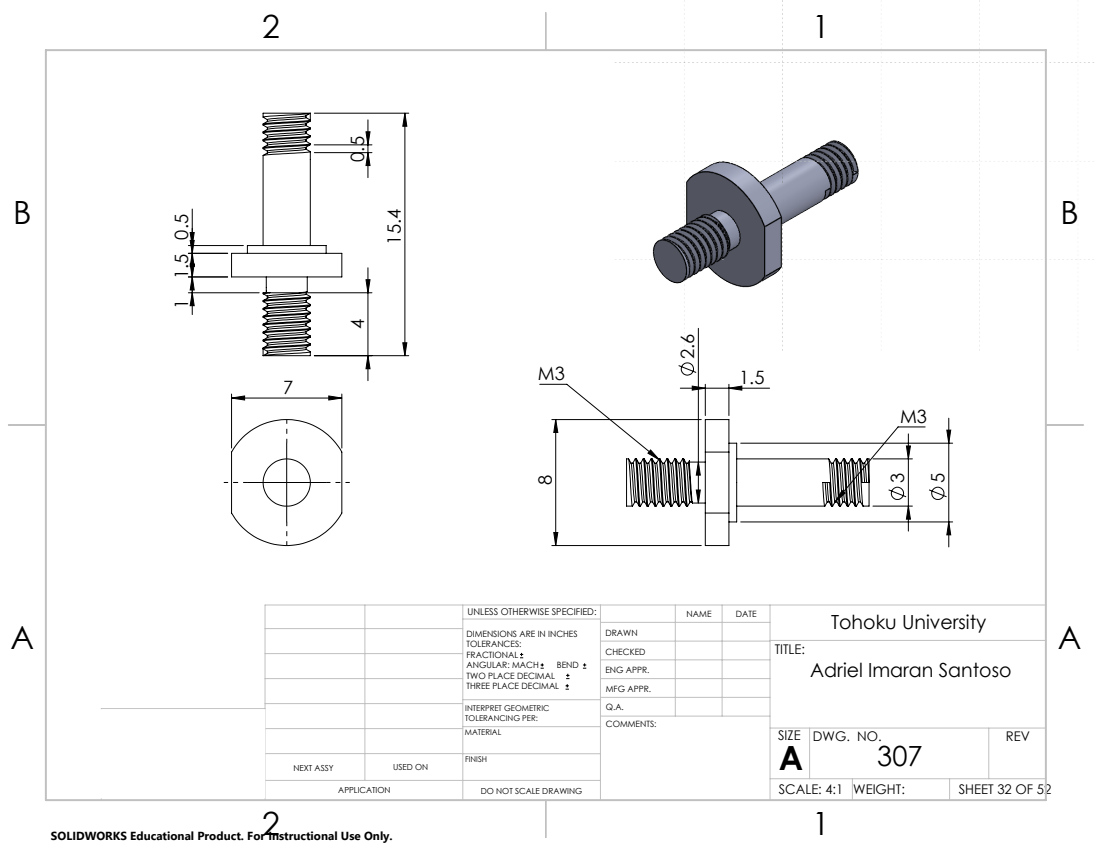
[picture p88: page 32]
Tohoku University A

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

CHECKED | | | TITLE: Adriel Imaran Santoso

ENG APPR.
MFG APPR.

INTERPRET GEOMETRIC TOLERANCING PER: | Q.A.
MATERIAL | | SIZE A | DWG. NO. 307 | REV

NEXT ASSY | USED ON | FINISH

SCALE: 4:1 | WEIGHT:

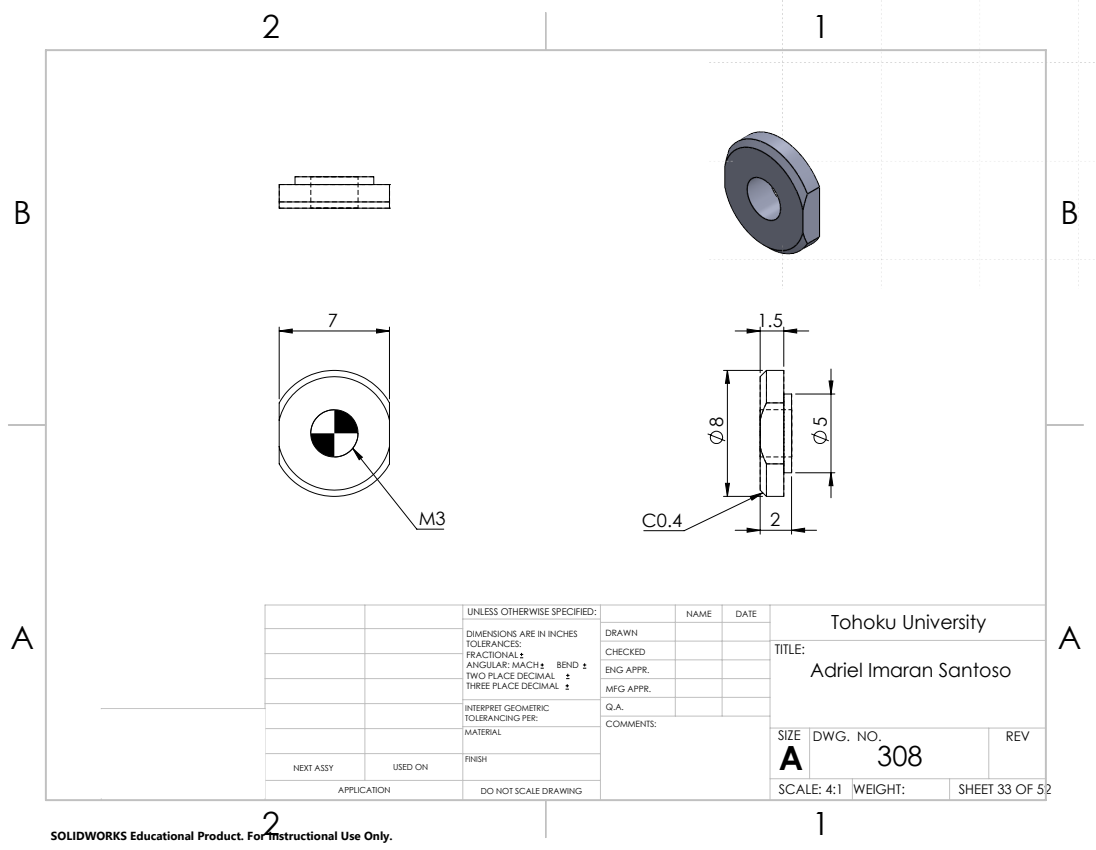
[picture p89: page 33]
Tohoku University A

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

CHECKED | | | TITLE: Adriel Imaran Santoso

ENG APPR.
MFG APPR.

INTERPRET GEOMETRIC TOLERANCING PER: | Q.A.
MATERIAL | | SIZE A | DWG. NO. 308 | REV

NEXT ASSY | USED ON | FINISH

SCALE: 4:1 | WEIGHT:

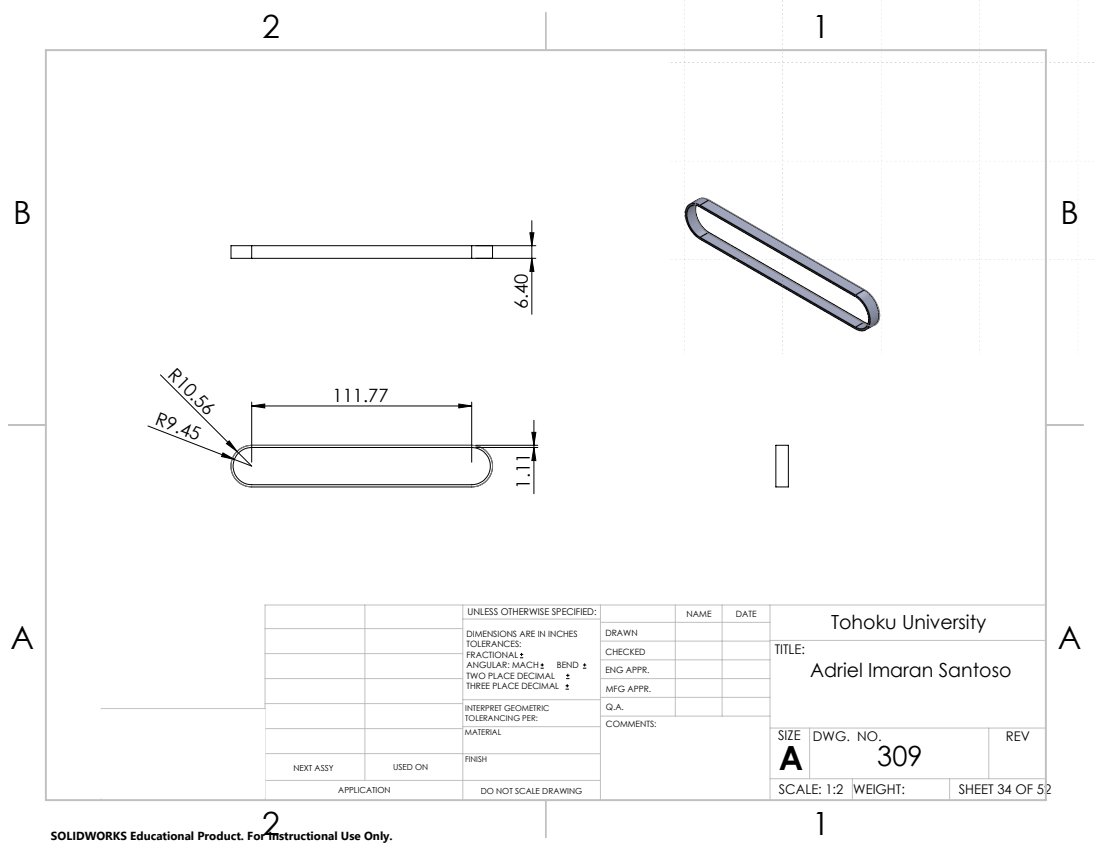
[picture p90: page 34]
Tohoku University A

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

CHECKED | | | TITLE: Adriel Imaran Santoso

ENG APPR.
MFG APPR.

INTERPRET GEOMETRIC TOLERANCING PER: | Q.A.
MATERIAL | | SIZE A | DWG. NO. 309 | REV

NEXT ASSY | USED ON | FINISH

SCALE: 1:2 | WEIGHT:

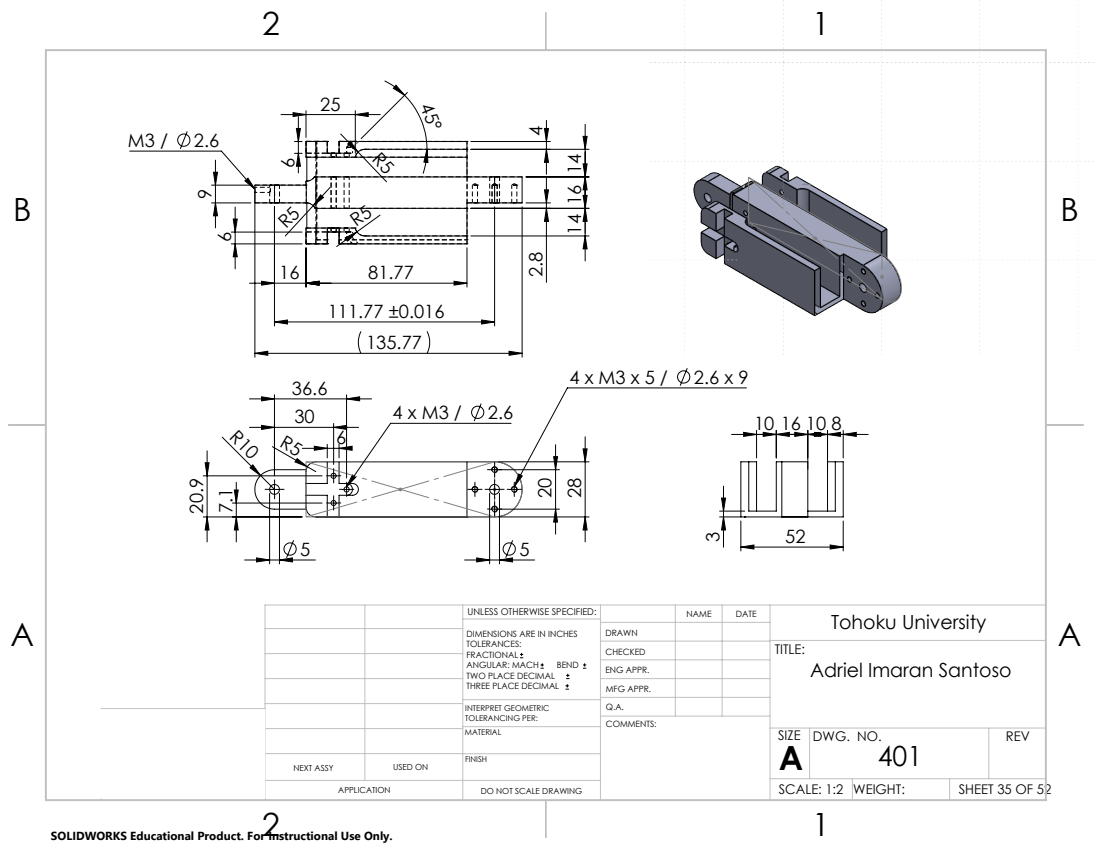
[picture p91: page 35]
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

CHECKED | | | TITLE: Adriel Imaran Santoso

ENG APPR.
MFG APPR.

INTERPRET GEOMETRIC TOLERANCING PER: | Q.A.
MATERIAL | | SIZE A | DWG. NO. 401 | REV

NEXT ASSY | USED ON | FINISH

SCALE: 1:2 | WEIGHT:

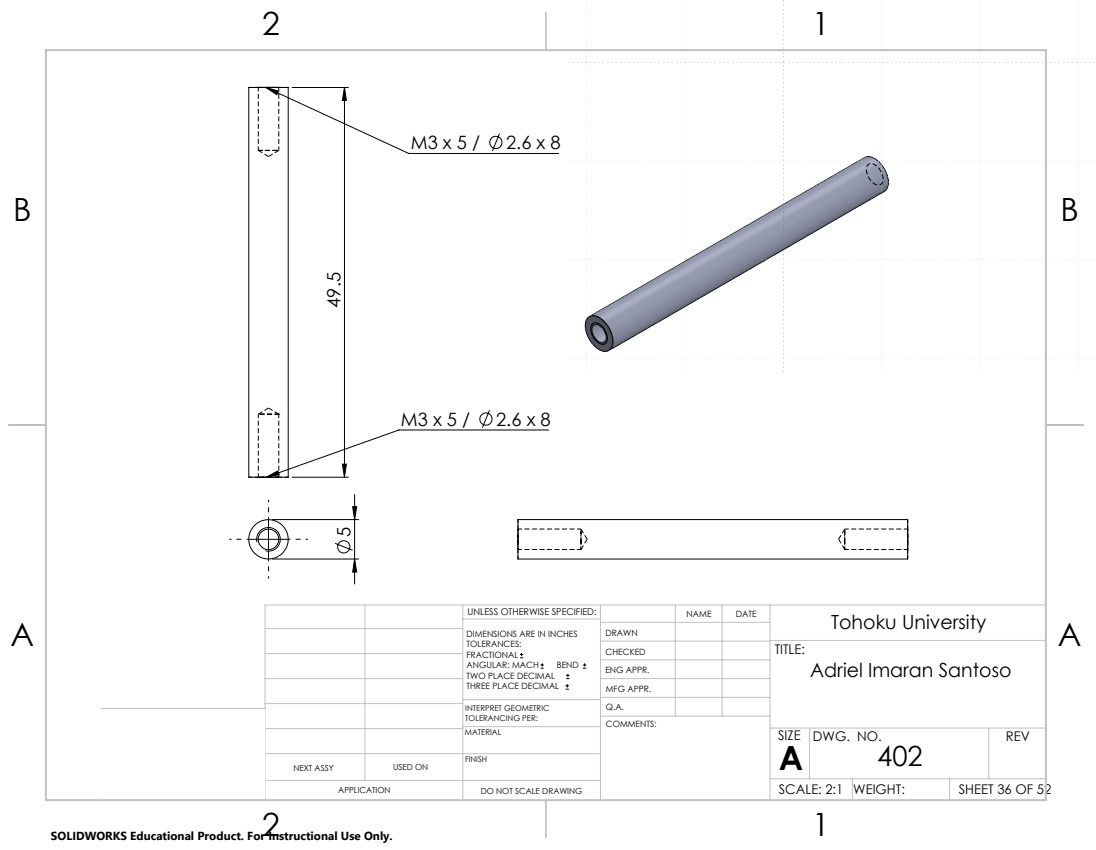
[picture p92: page 36]
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

CHECKED | | | TITLE: Adriel Imaran Santoso

ENG APPR.
MFG APPR.

INTERPRET GEOMETRIC TOLERANCING PER: | Q.A.
MATERIAL | | SIZE A | DWG. NO. 402 | REV

NEXT ASSY | USED ON | FINISH

SCALE: 2:1 | WEIGHT:

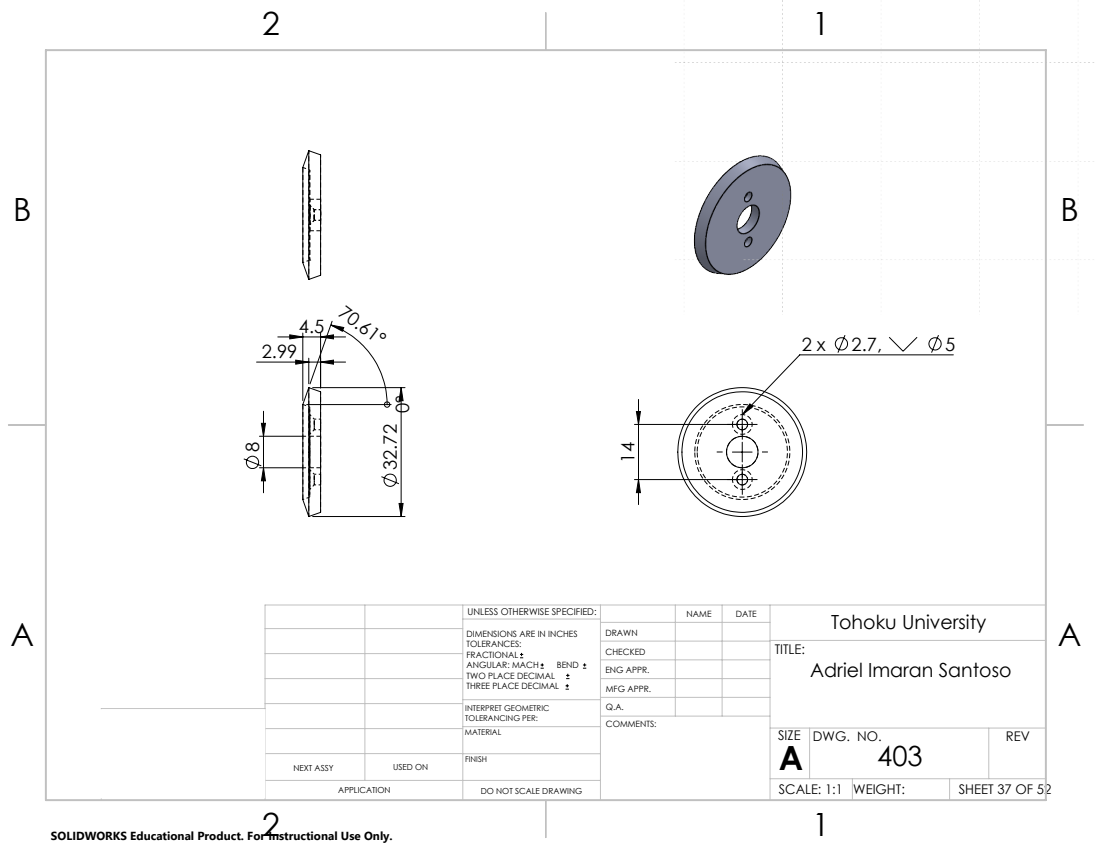
[picture p93: page 37]
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

CHECKED | | | TITLE: Adriel Imaran Santoso

ENG APPR.
MFG APPR.

INTERPRET GEOMETRIC TOLERANCING PER: | Q.A.
MATERIAL | | SIZE A | DWG. NO. 403 | REV

NEXT ASSY | USED ON | FINISH

SCALE: 1:1 | WEIGHT:

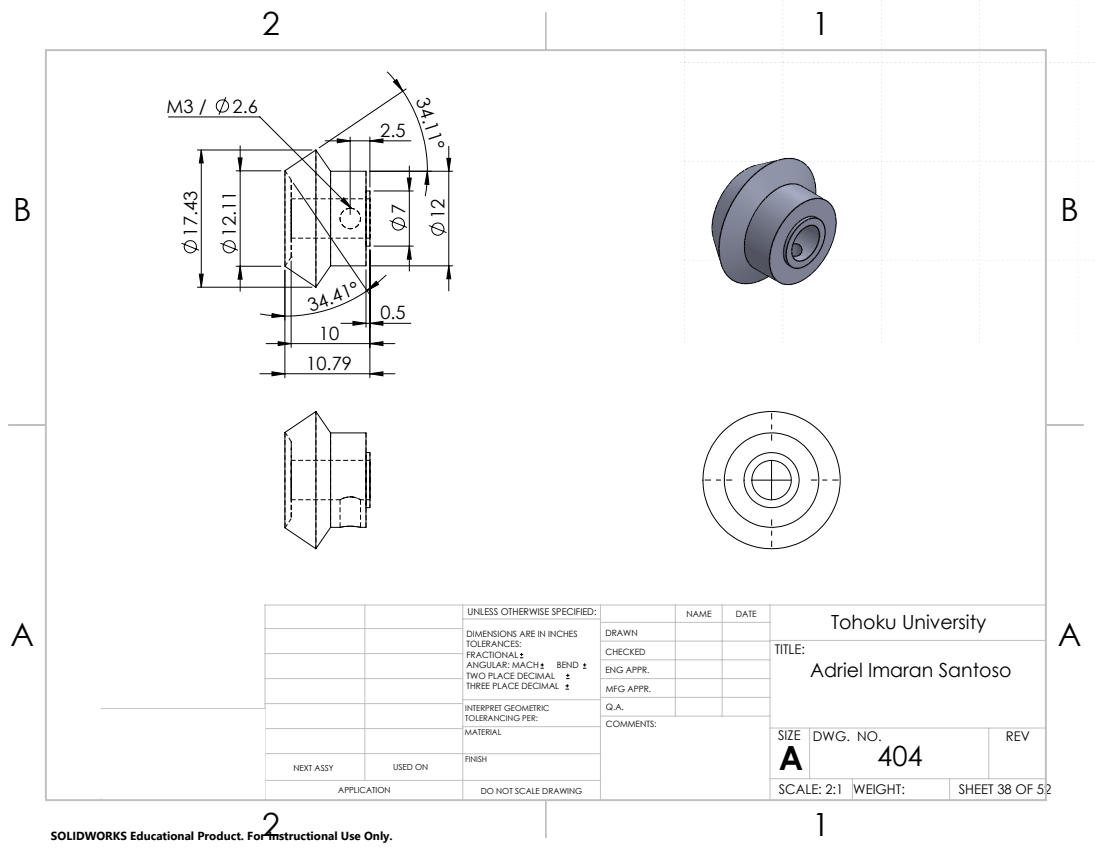
[picture p94: page 38]
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

CHECKED | | | TITLE: Adriel Imaran Santoso

ENG APPR.
MFG APPR.

INTERPRET GEOMETRIC TOLERANCING PER: | Q.A.
MATERIAL | | SIZE A | DWG. NO. 404 | REV

NEXT ASSY | USED ON | FINISH

SCALE: 2:1 | WEIGHT:

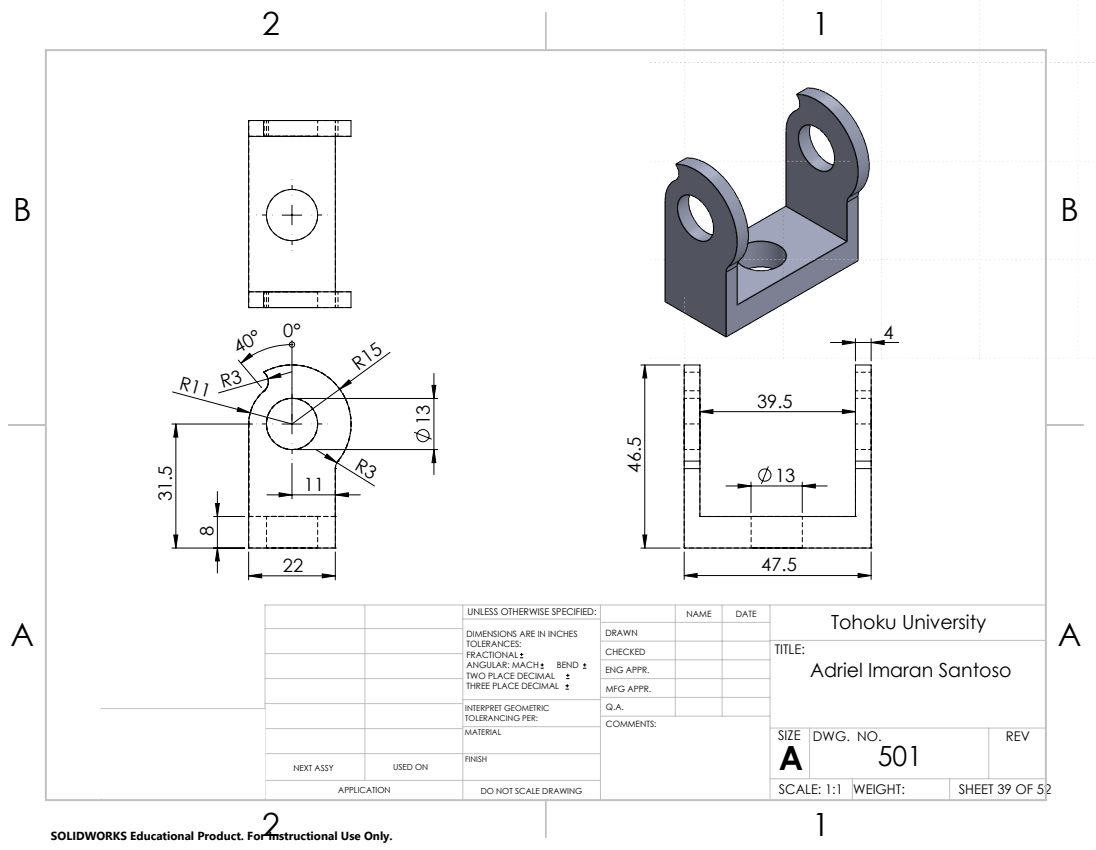
[picture p95: page 39]
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

CHECKED | | | TITLE: Adriel Imaran Santoso

ENG APPR.
MFG APPR.

INTERPRET GEOMETRIC TOLERANCING PER: | Q.A.
MATERIAL | | SIZE A | DWG. NO. 501 | REV

NEXT ASSY | USED ON | FINISH

SCALE: 1:1 | WEIGHT:

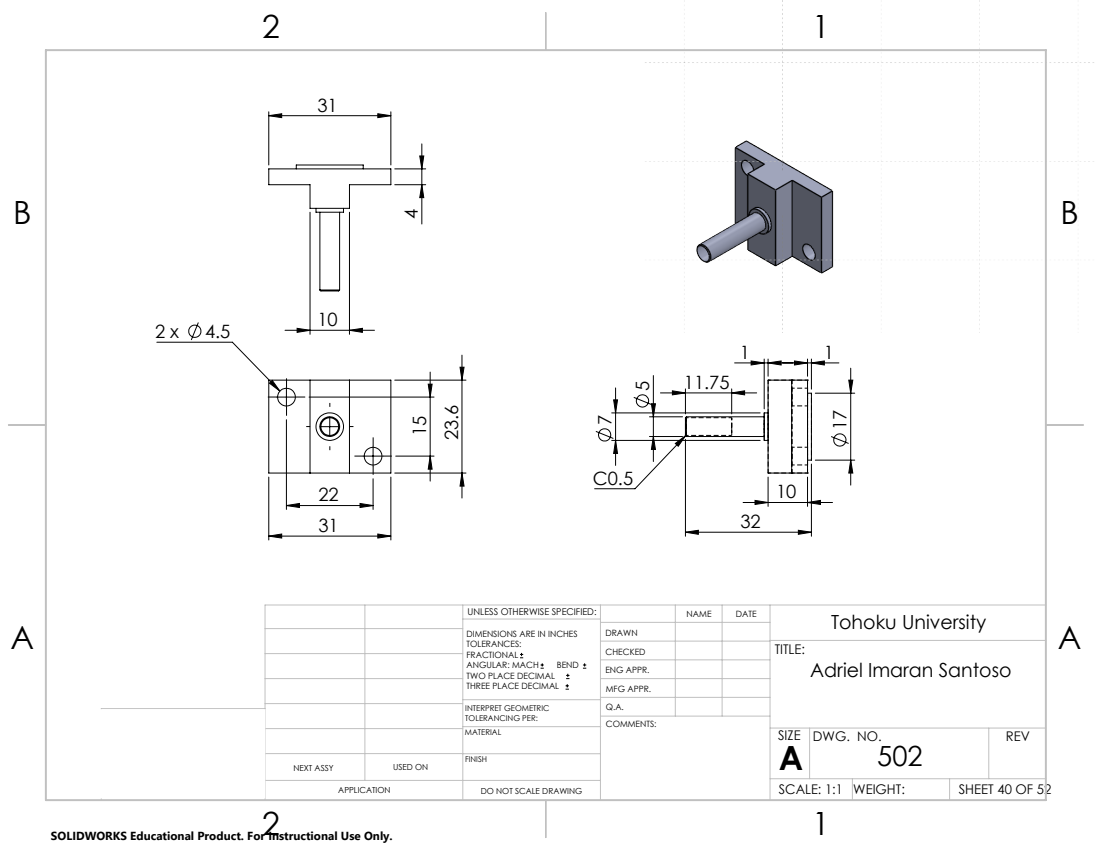
[picture p96: page 40]
Tohoku University A

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

CHECKED | | | TITLE: Adriel Imaran Santoso

ENG APPR.
MFG APPR.

INTERPRET GEOMETRIC TOLERANCING PER: | Q.A.
MATERIAL | | SIZE A | DWG. NO. 502 | REV

NEXT ASSY | USED ON | FINISH

SCALE: 1:1 | WEIGHT:

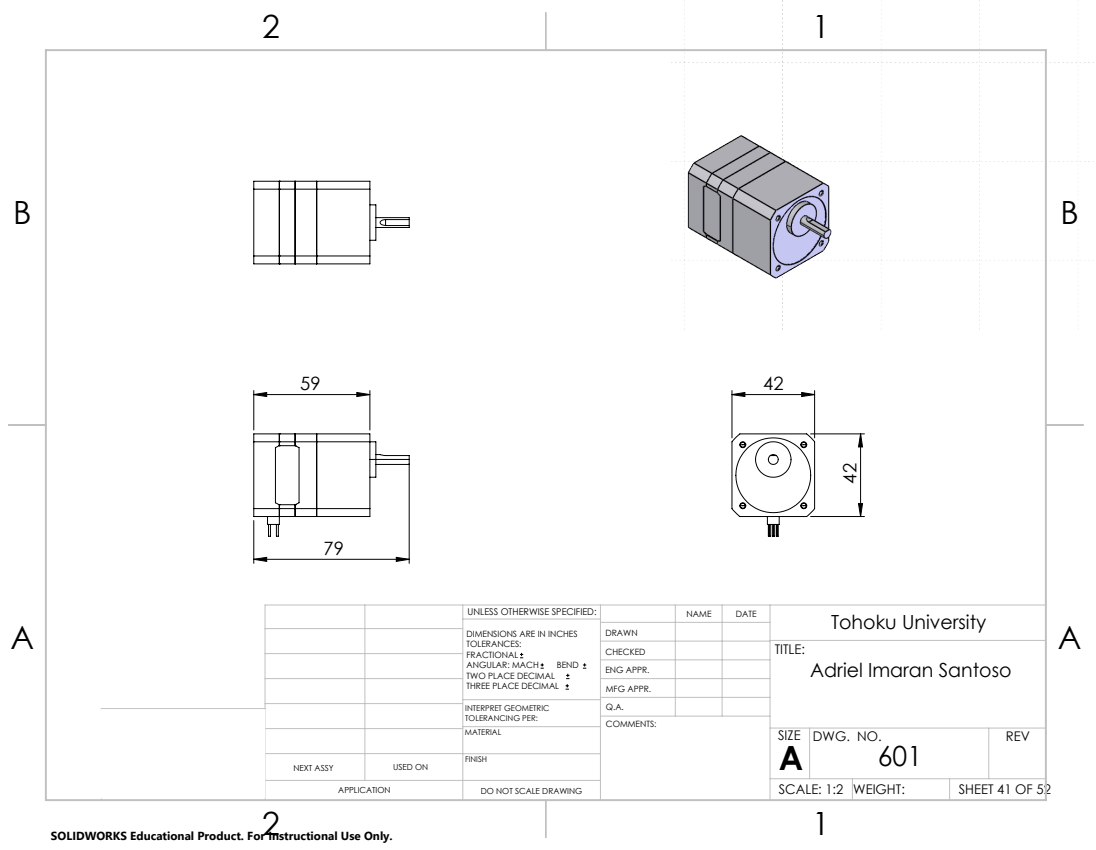
[picture p97: page 41]
Tohoku University A

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

CHECKED | | | TITLE: Adriel Imaran Santoso

ENG APPR.
MFG APPR.

INTERPRET GEOMETRIC TOLERANCING PER: | Q.A.
MATERIAL | | SIZE A | DWG. NO. 601 | REV

NEXT ASSY | USED ON | FINISH

SCALE: 1:2 | WEIGHT:

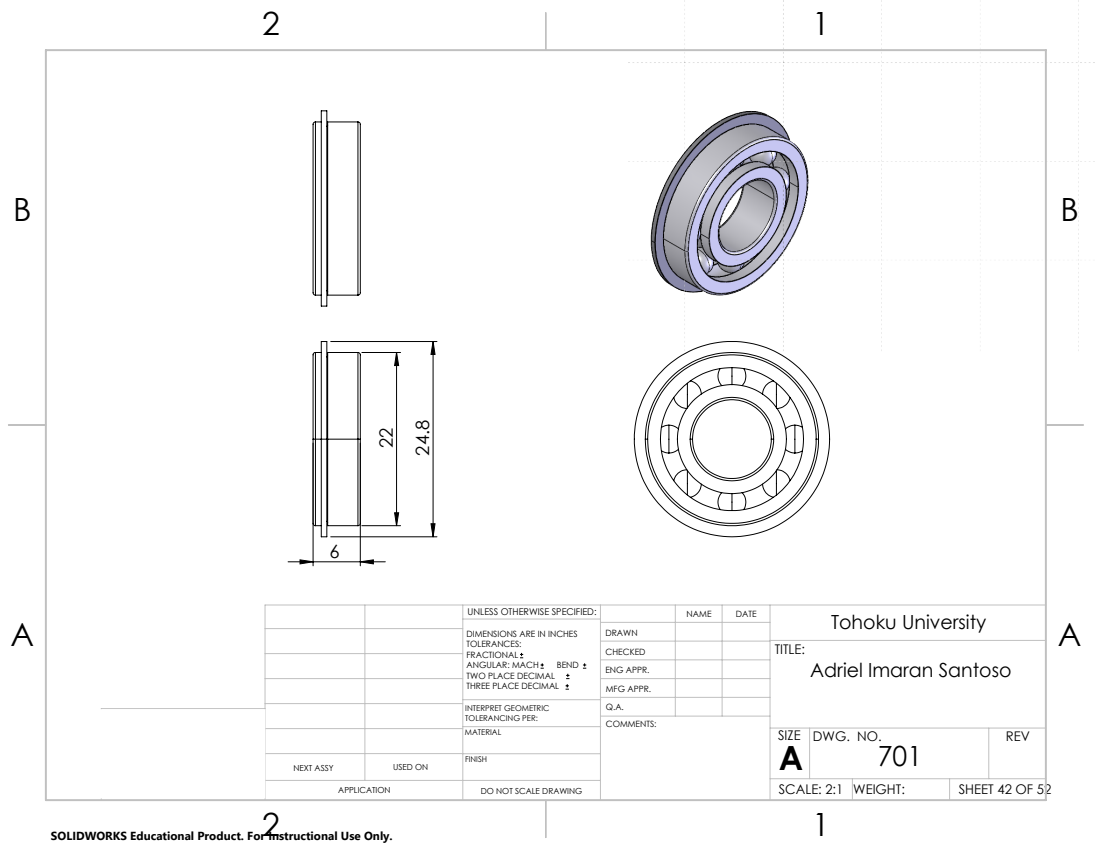
[picture p98: page 42]
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

CHECKED | | | TITLE: Adriel Imaran Santoso

ENG APPR.
MFG APPR.

INTERPRET GEOMETRIC TOLERANCING PER: | Q.A.
MATERIAL | | SIZE A | DWG. NO. 701 | REV

NEXT ASSY | USED ON | FINISH

SCALE: 2:1 | WEIGHT:

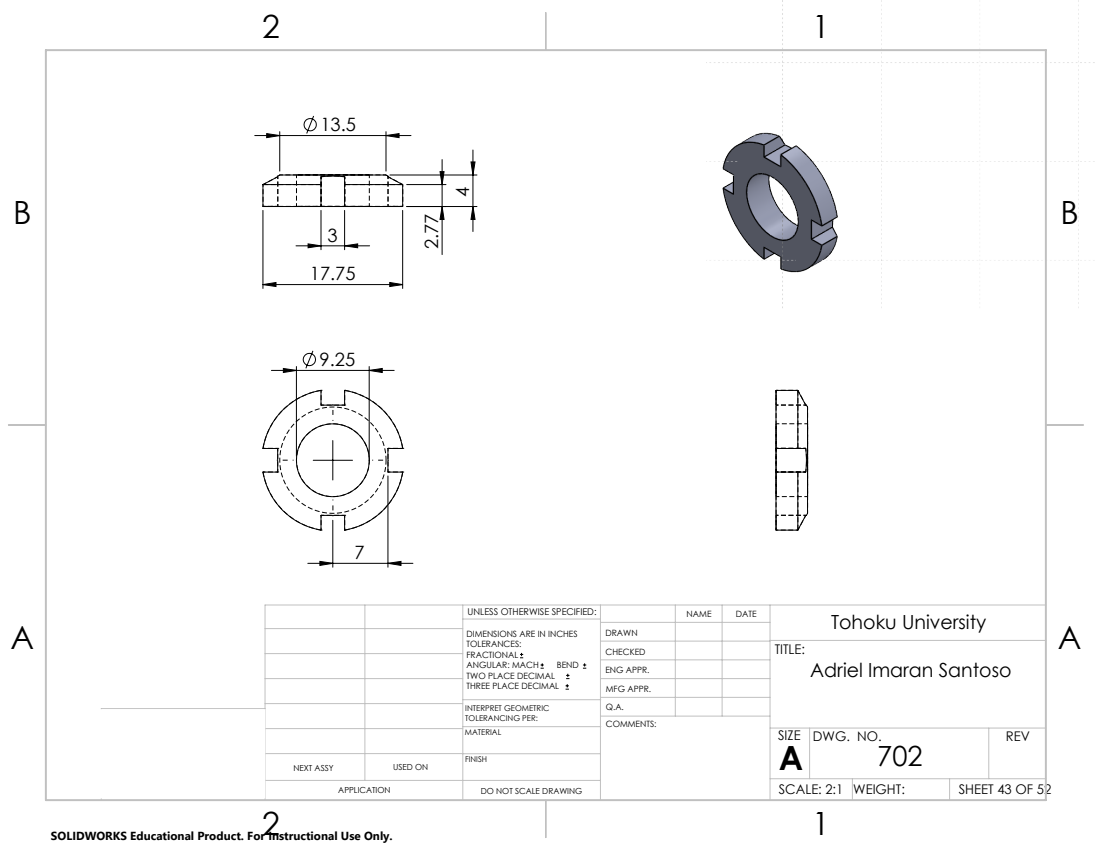
[picture p99: page 43]
Tohoku University A

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

CHECKED | | | TITLE: Adriel Imaran Santoso

ENG APPR.
MFG APPR.

INTERPRET GEOMETRIC TOLERANCING PER: | Q.A.
MATERIAL | | SIZE A | DWG. NO. 702 | REV

NEXT ASSY | USED ON | FINISH

SCALE: 2:1 | WEIGHT:

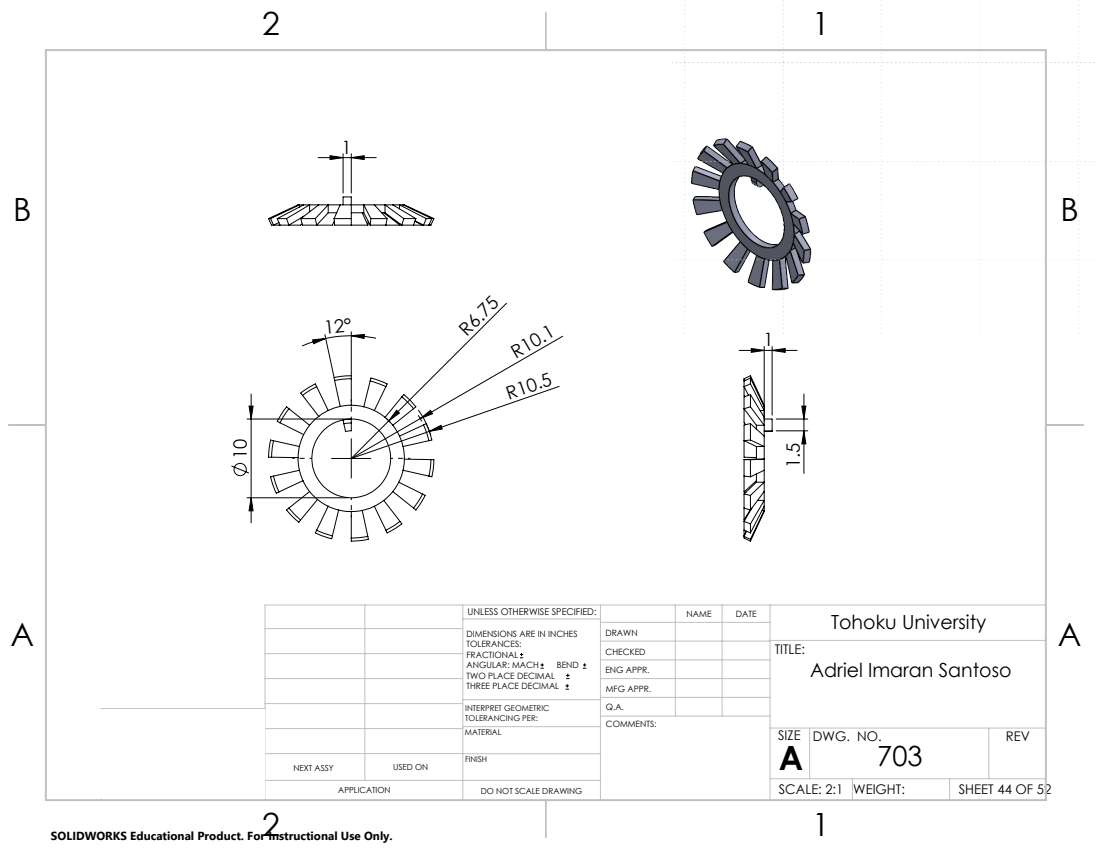
[picture p100: page 44]
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

CHECKED | | | TITLE: Adriel Imaran Santoso

ENG APPR.
MFG APPR.

INTERPRET GEOMETRIC TOLERANCING PER: | Q.A.
MATERIAL | | SIZE A | DWG. NO. 703 | REV

NEXT ASSY | USED ON | FINISH

SCALE: 2:1 | WEIGHT:

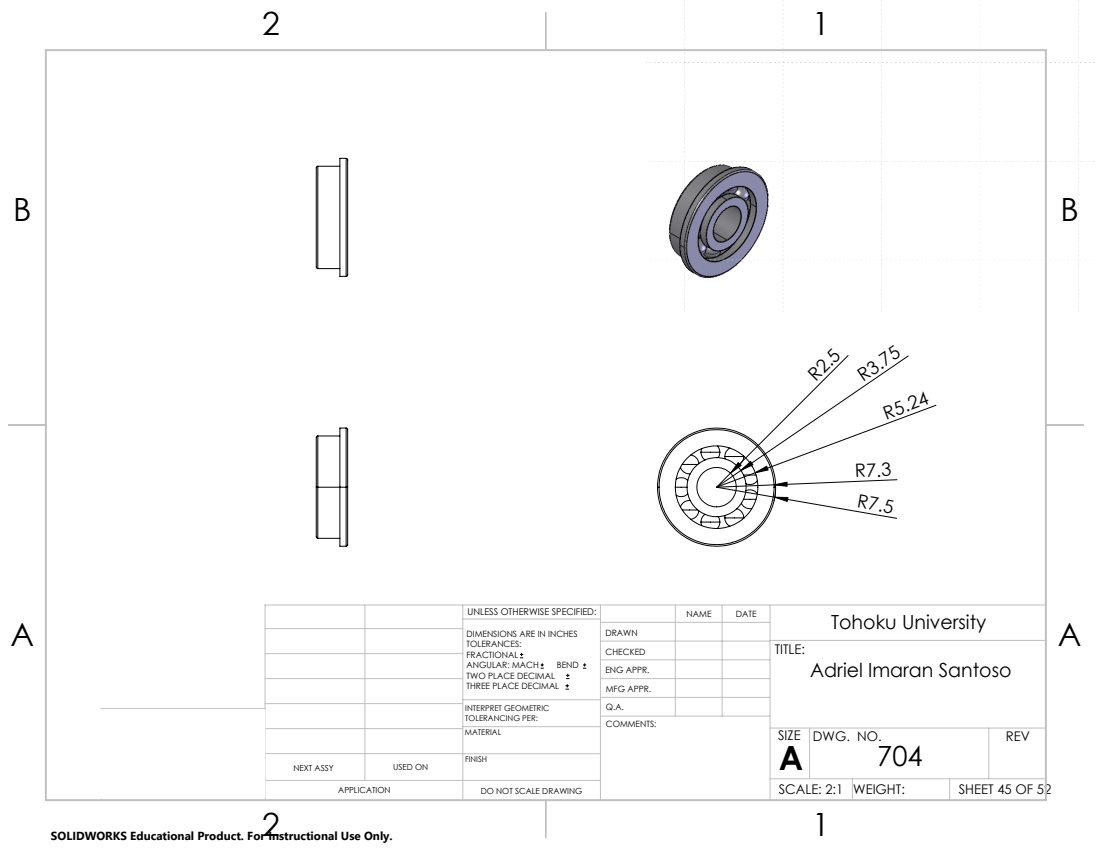
[picture p101: page 45]
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

CHECKED | | | TITLE: Adriel Imaran Santoso

ENG APPR.
MFG APPR.

INTERPRET GEOMETRIC TOLERANCING PER: | Q.A.
MATERIAL | | SIZE A | DWG. NO. 704 | REV

NEXT ASSY | USED ON | FINISH

SCALE: 2:1 | WEIGHT:

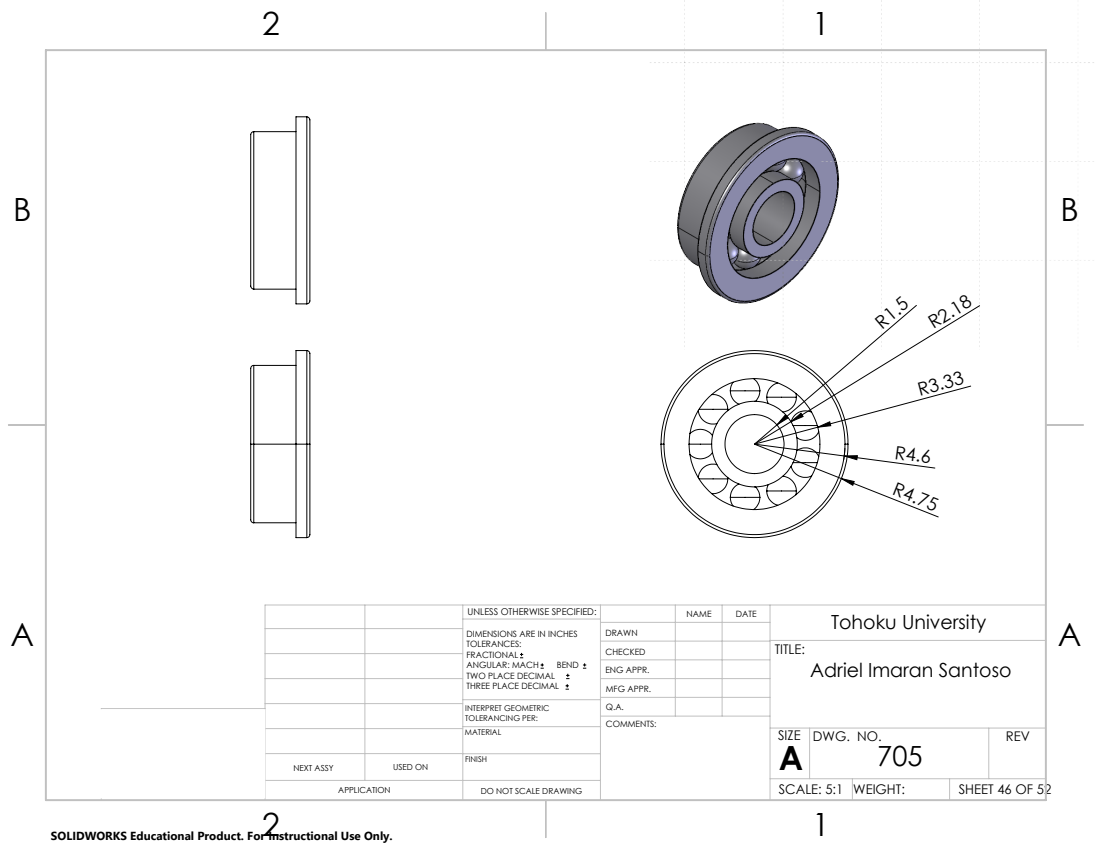
[picture p102: page 46]
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

CHECKED | | | TITLE: Adriel Imaran Santoso

ENG APPR.
MFG APPR.

INTERPRET GEOMETRIC TOLERANCING PER: | Q.A.
MATERIAL | | SIZE A | DWG. NO. 705 | REV

NEXT ASSY | USED ON | FINISH

SCALE: 5:1 | WEIGHT:

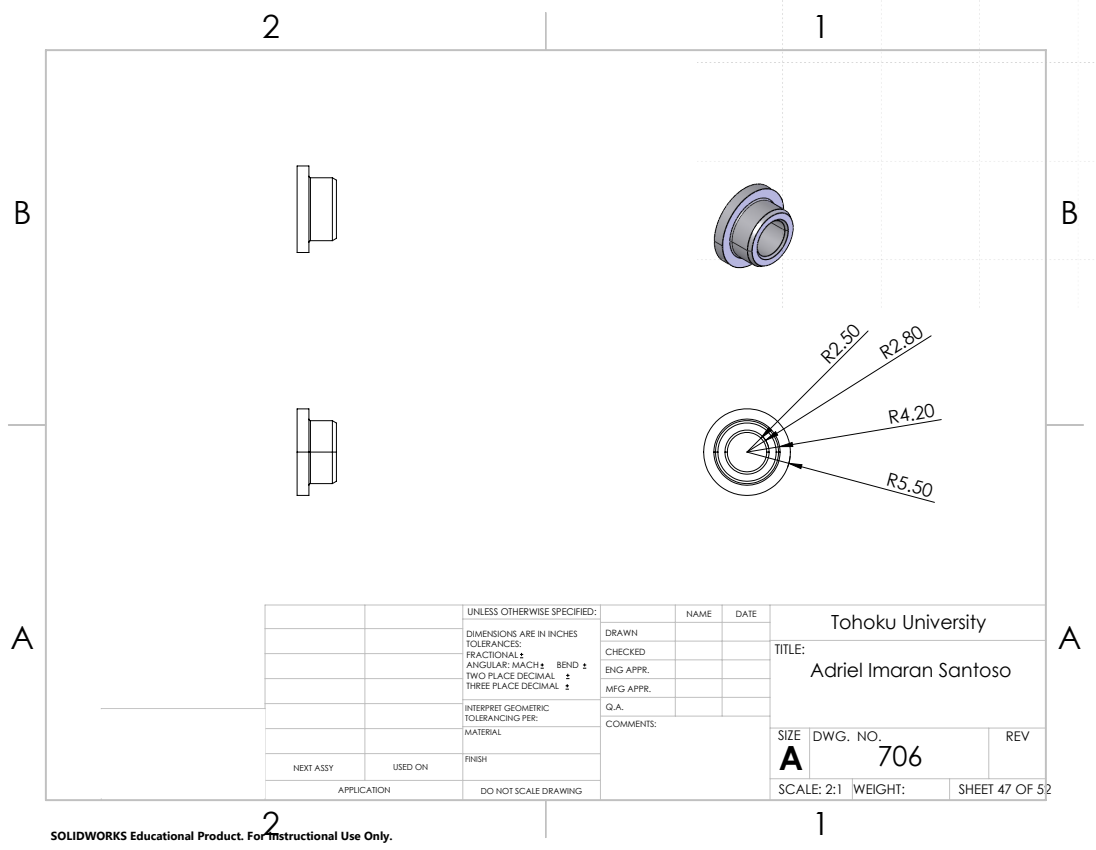
[picture p103: page 47]
Tohoku University A

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

CHECKED | | | TITLE: Adriel Imaran Santoso

ENG APPR.
MFG APPR.

INTERPRET GEOMETRIC TOLERANCING PER: | Q.A.
MATERIAL | | SIZE A | DWG. NO. 706 | REV

NEXT ASSY | USED ON | FINISH

SCALE: 2:1 | WEIGHT:

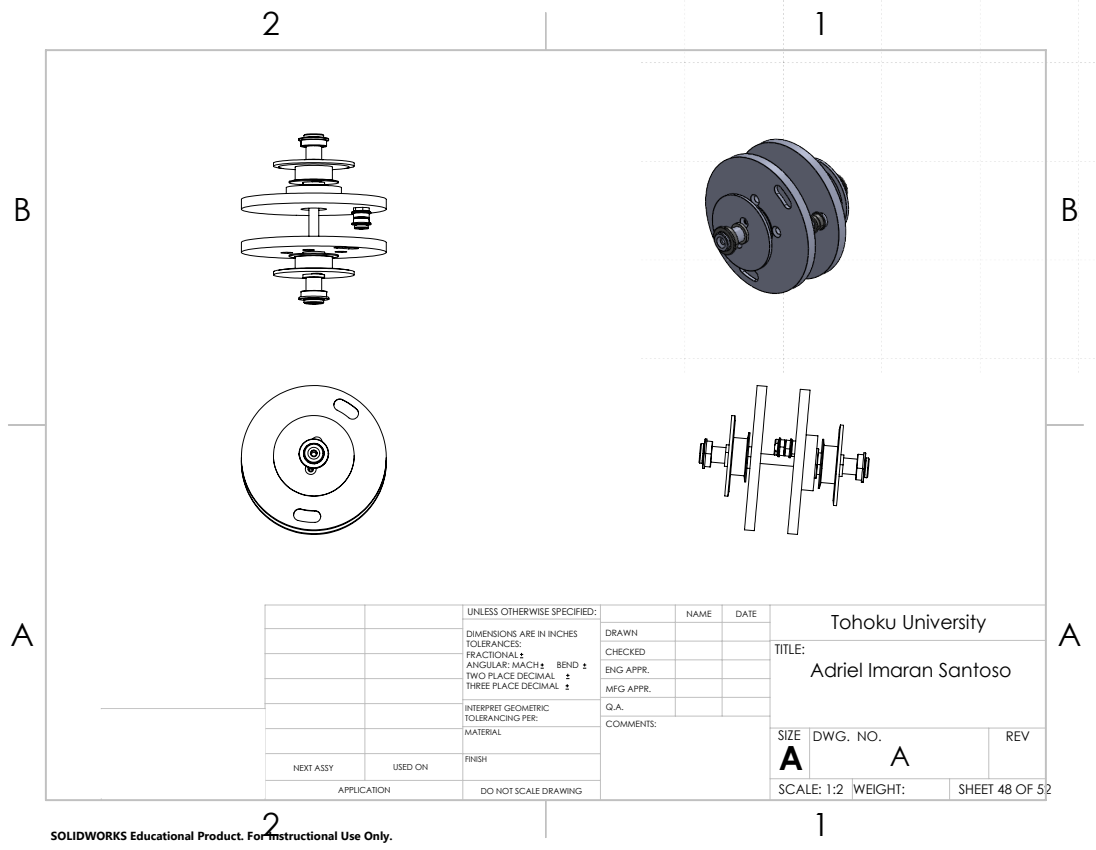
[picture p104: page 48]
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

CHECKED | | | TITLE: Adriel Imaran Santoso

ENG APPR.
MFG APPR.

INTERPRET GEOMETRIC TOLERANCING PER: | Q.A.
MATERIAL | | SIZE A | DWG. NO. A | REV

NEXT ASSY | USED ON | FINISH

SCALE: 1:2 | WEIGHT:

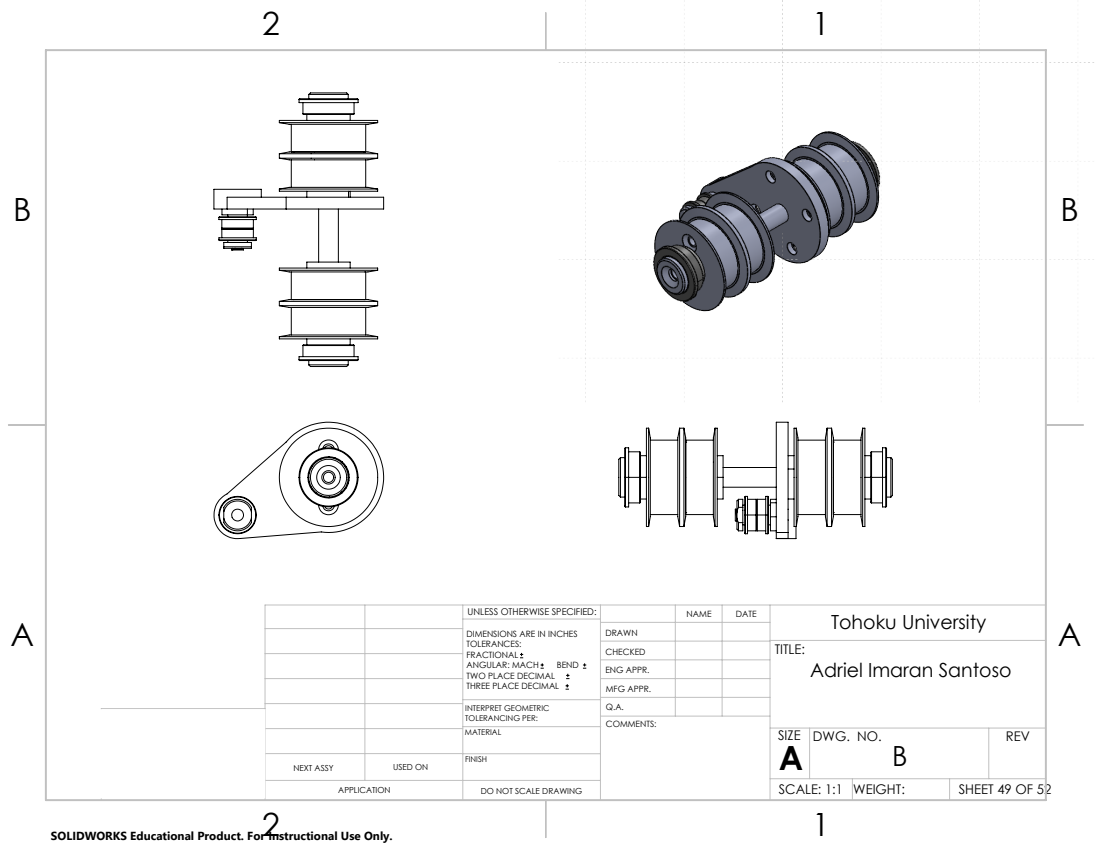
[picture p105: page 49]
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

CHECKED | | | TITLE: Adriel Imaran Santoso

ENG APPR.
MFG APPR.

INTERPRET GEOMETRIC TOLERANCING PER: | Q.A.
MATERIAL | | SIZE A | DWG. NO. B | REV

NEXT ASSY | USED ON | FINISH

SCALE: 1:1 | WEIGHT:

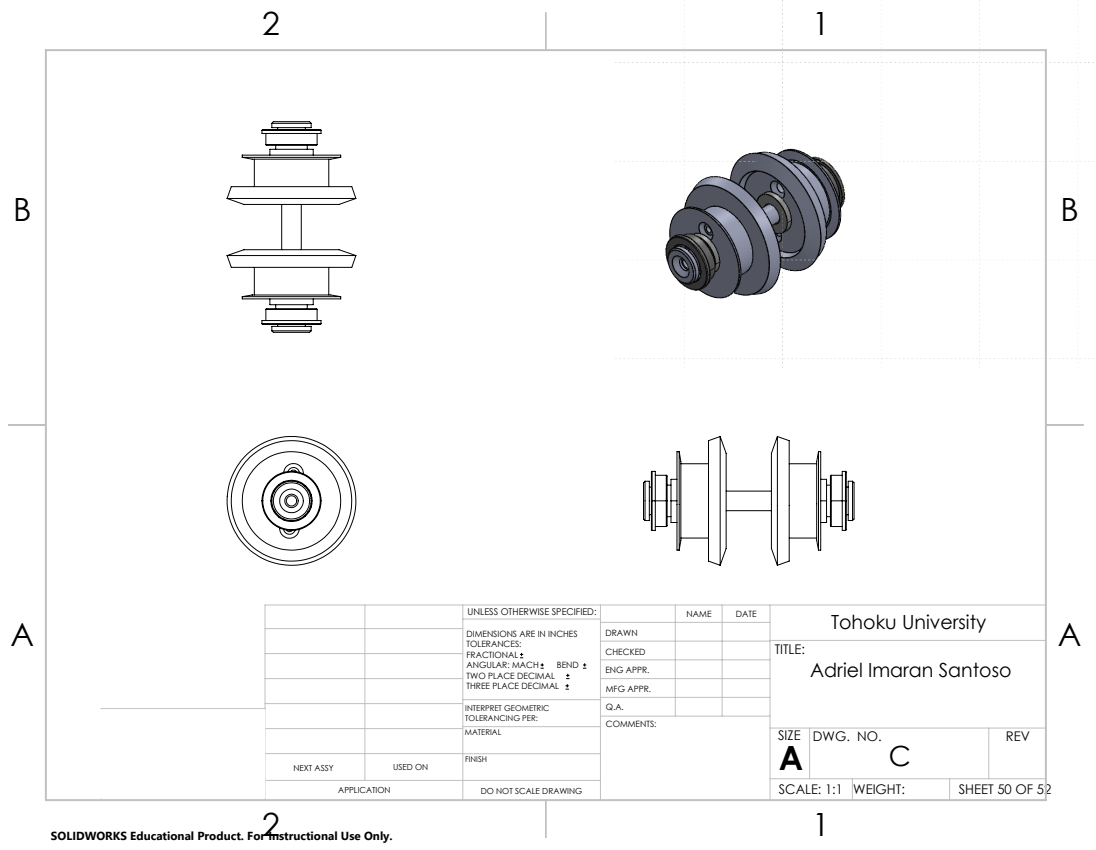
[picture p106: page 50]
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

CHECKED | | | TITLE: Adriel Imaran Santoso

ENG APPR.
MFG APPR.

INTERPRET GEOMETRIC TOLERANCING PER: | Q.A.
MATERIAL | | SIZE A | DWG. NO. C | REV

NEXT ASSY | USED ON | FINISH

SCALE: 1:1 | WEIGHT:

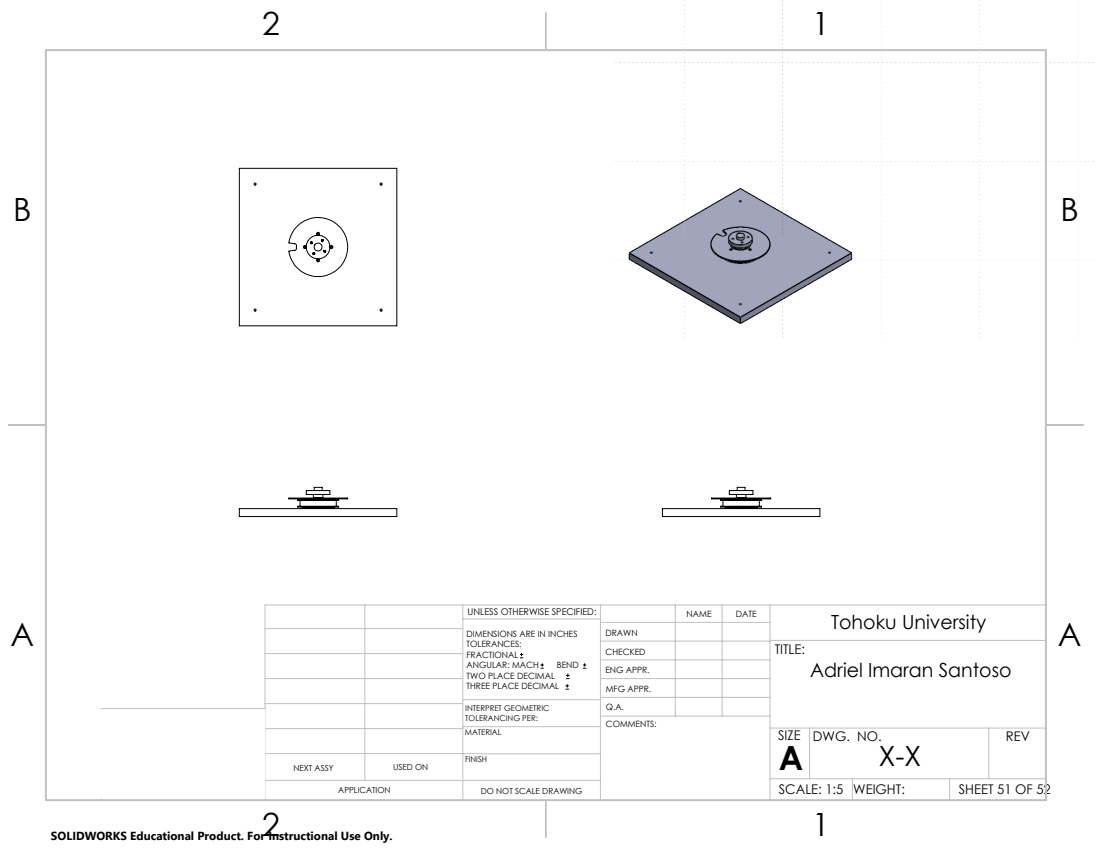
[picture p107: page 51]
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

CHECKED | | | TITLE: Adriel Imaran Santoso

ENG APPR.
MFG APPR.

INTERPRET GEOMETRIC TOLERANCING PER: | Q.A.
MATERIAL | | SIZE A | DWG. NO. X-X | REV

NEXT ASSY | USED ON | FINISH

SCALE: 1:5 | WEIGHT:

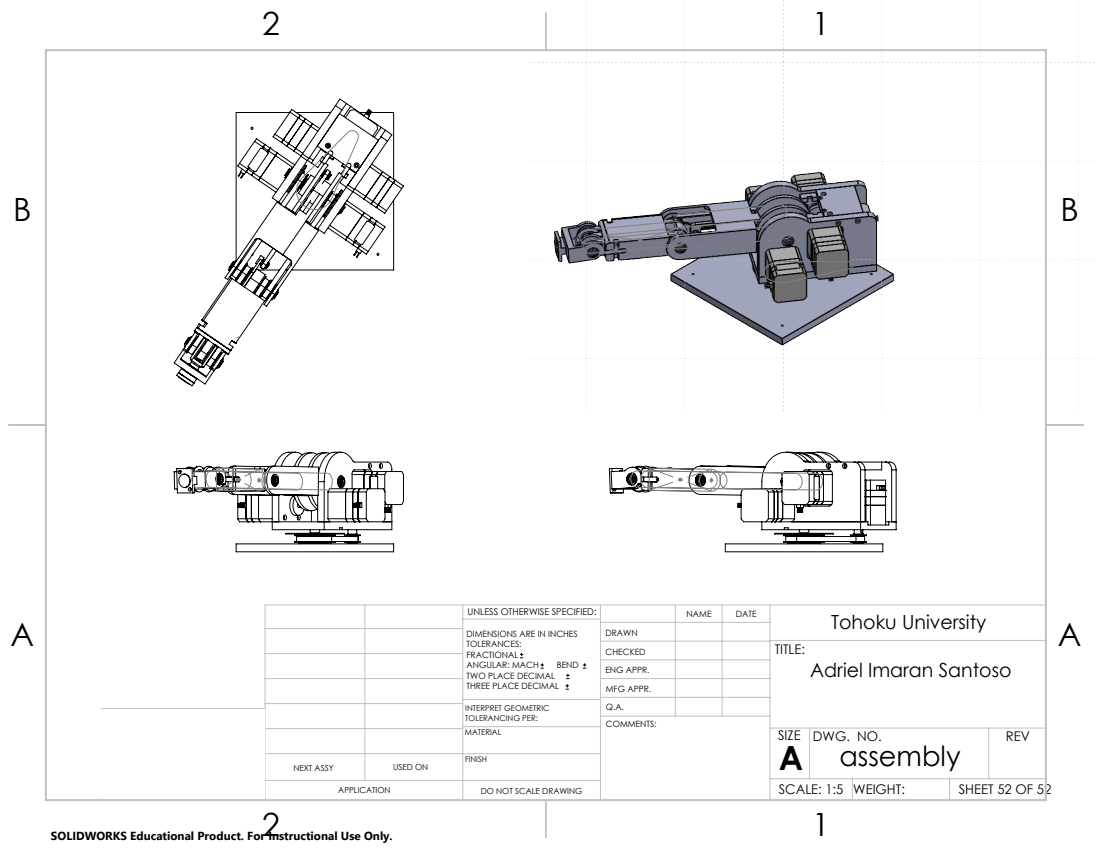
[picture p108: page 52]
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

CHECKED | | | TITLE: Adriel Imaran Santoso

ENG APPR.
MFG APPR.

INTERPRET GEOMETRIC TOLERANCING PER: | Q.A.
MATERIAL | | SIZE A | DWG. NO. assembly | REV

NEXT ASSY | USED ON | FINISH

SCALE: 1:5 | WEIGHT:
