adibatic/3dof-manipulator/(commit log)

2026-10-08 feat: add CAD parts and assemblies
    [101base.SLDPRT, 102shaft.SLDPRT, 103toothed_pulley.SLDPRT, 104toothed_pulley.SLDPRT, 105waist_rotation_plate.SLDPRT, 106proximity_sensor_target.SLDPRT, 107spacer.SLDPRT, 108belt.SLDPRT]
2026-10-08 docs: add README with pictures of the assembly
